melair/ktane/Docs/Card Scan/Melair_realistic_black_women_with_grey_streaks_in_hair_wearing__44ab107c-06e1-47cd-86c4-bb1236d598e2.png

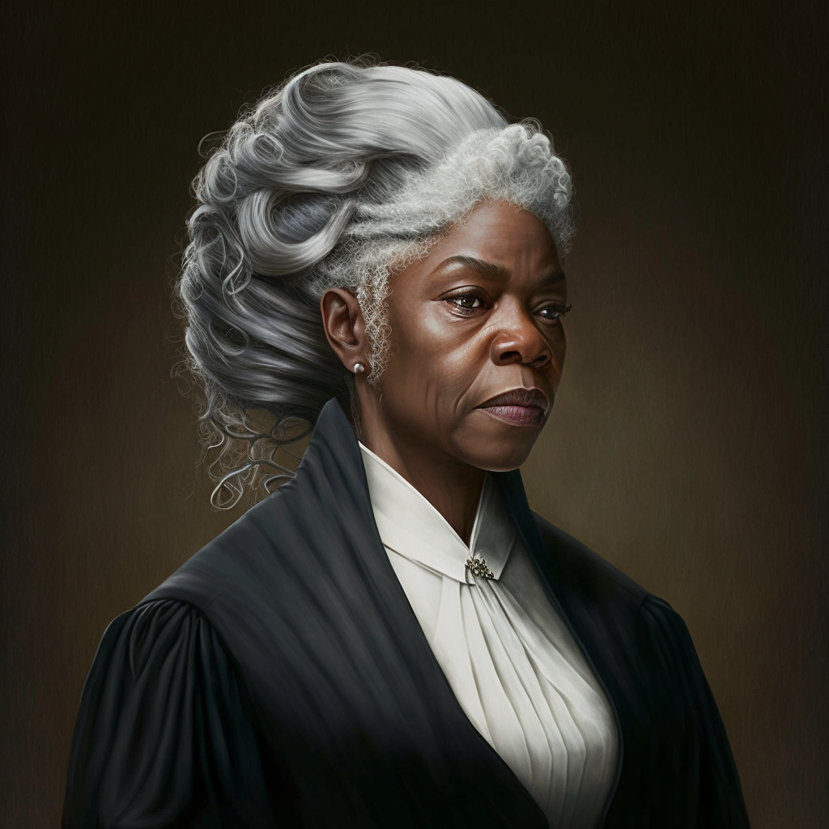
Docs/Card Scan/Melair_realistic_black_women_with_grey_streaks_in_hair_wearing__44ab107c-06e1-47cd-86c4-bb1236d598e2.png
