melair/ktane/Docs/Card Scan/Melair_realistic_grey_skinned_male_in_yellow_suit_jacket_with_n_b30e8cae-0856-494e-9278-38f3bf413497.png

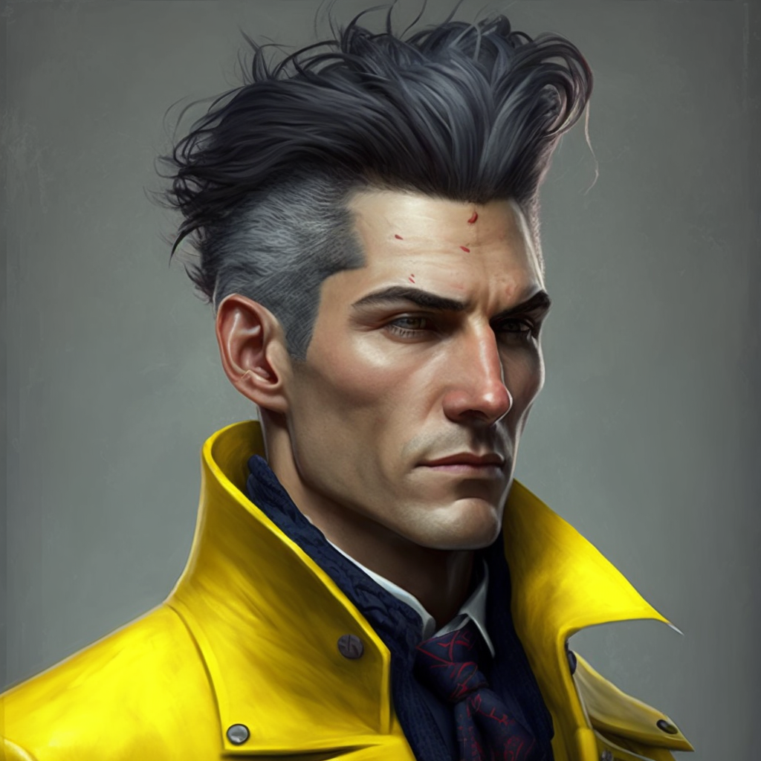
Docs/Card Scan/Melair_realistic_grey_skinned_male_in_yellow_suit_jacket_with_n_b30e8cae-0856-494e-9278-38f3bf413497.png
