melair/ktane/README.md

# Keep Talking and Nobody Explodes - Physical Version

## Version Two

This is version two of my Keep Talking and Nobody Explodes physical bomb, you may refer to the `version-one` branch if you wish to see the first version progress.
