melair/ktane/Docs/Card Scan/Cards.pdf

Acheron | Kontrollbeamter | Nyx | Obaida
Lloyd Davis | Judge Harris | Nine | 无名 (Wúmíng)

Richmond
Avenal

Josephus
Miller | Breeze | La Succubus
Shaykh Alwaqt | Lady of the
Night | Colonel Riker | Reaver

のぞみ
(Nozomi)
Mena | Duck | Packet

Jamie,
the Needle | The Librarian | Blackbird | El Padre del Diablo
