melair/ktane/Docs/Card Scan/Melair_realisitic_non_binary_person_with_short_hair_in_grey_mil_04014cfb-8ffc-4a0f-abf2-2d42c61999cd.png

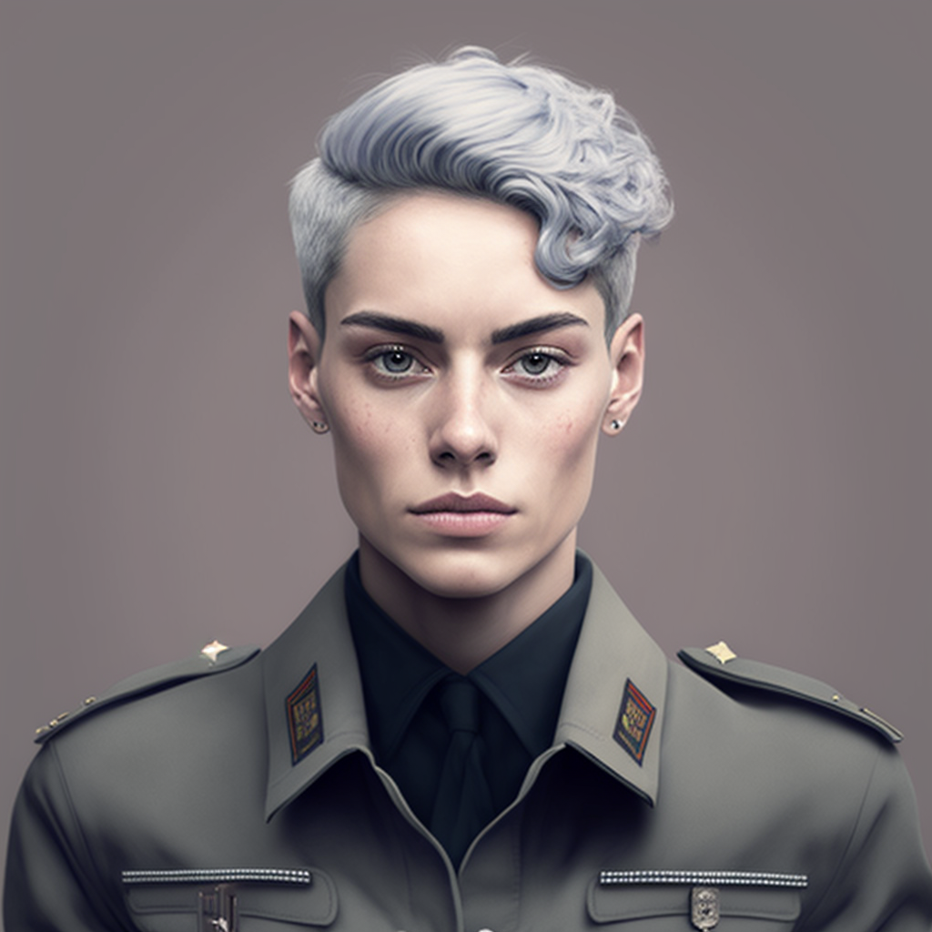
Docs/Card Scan/Melair_realisitic_non_binary_person_with_short_hair_in_grey_mil_04014cfb-8ffc-4a0f-abf2-2d42c61999cd.png
