melair/ktane/Docs/Card Scan/Melair_realistic_adult_German_female_with_purple_hair_in_a_blac_fe274c78-8b49-4a50-9dd5-ff4e6a9a2e28.png

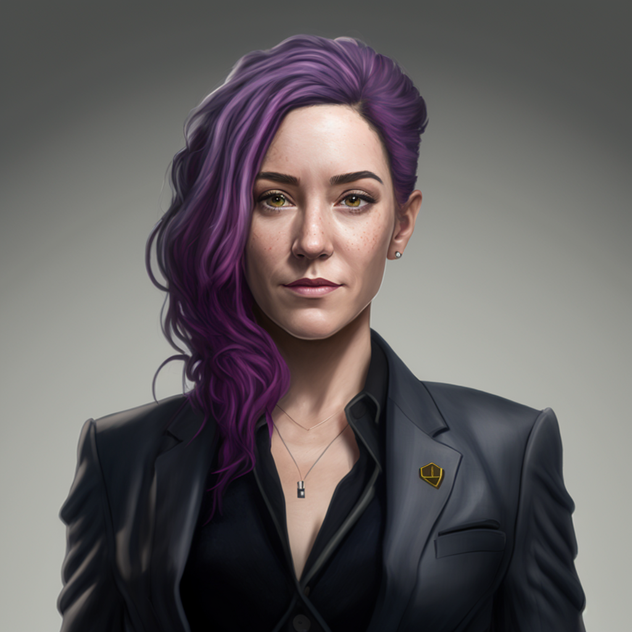
Docs/Card Scan/Melair_realistic_adult_German_female_with_purple_hair_in_a_blac_fe274c78-8b49-4a50-9dd5-ff4e6a9a2e28.png
