melair/ktane/Docs/Card Scan/Melair_realistic_Algerian_female_wearing_a_burka_d726cf47-6979-42aa-9952-323f560bce72.png

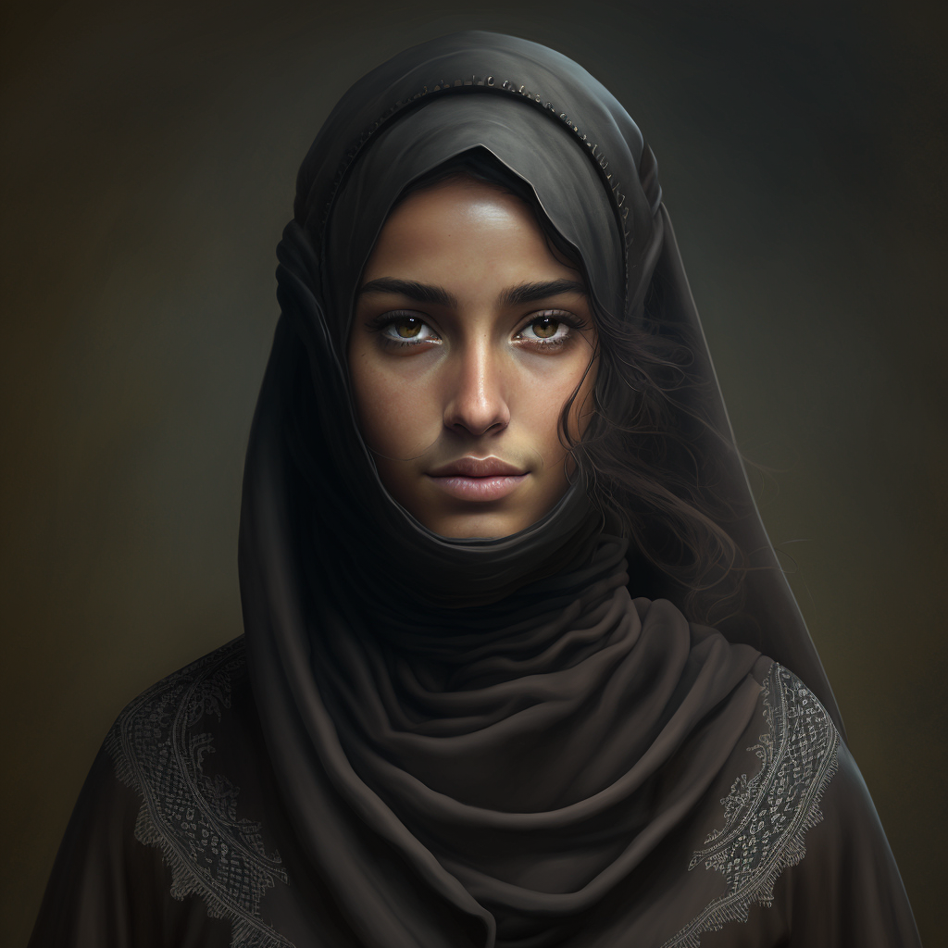
Docs/Card Scan/Melair_realistic_Algerian_female_wearing_a_burka_d726cf47-6979-42aa-9952-323f560bce72.png
