melair/ktane/Docs/Card Scan/Melair_realistic_black_male_with_white_hair_in_business_suite_368761fd-943f-4e19-92e4-5bb18a6a9406.png

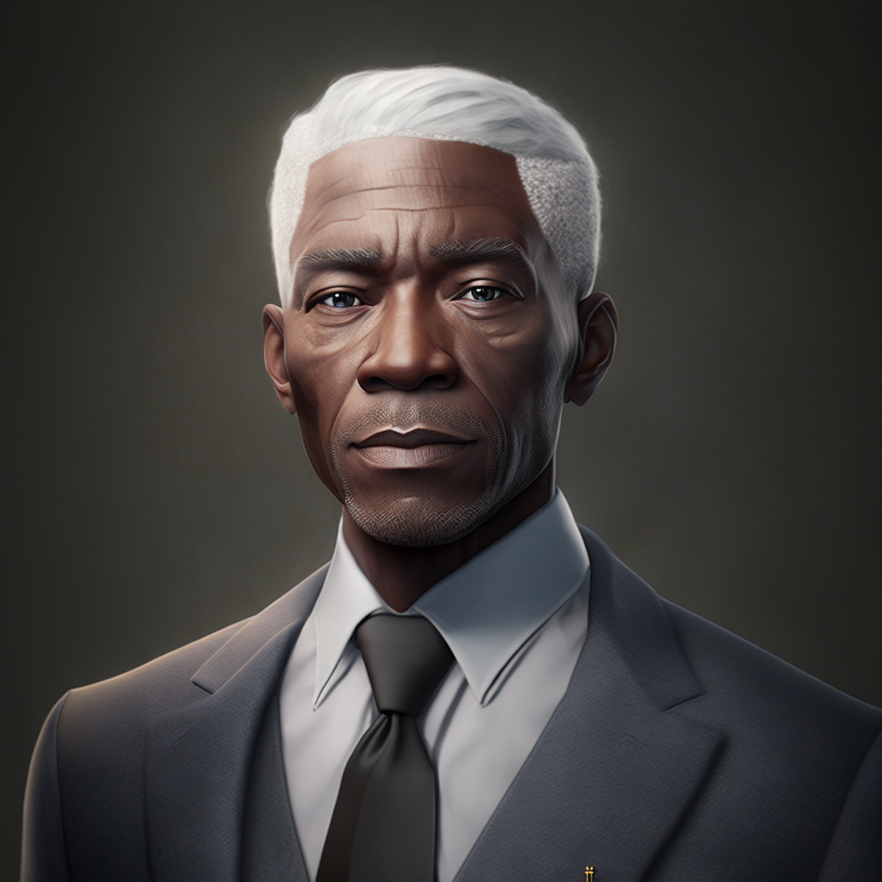
Docs/Card Scan/Melair_realistic_black_male_with_white_hair_in_business_suite_368761fd-943f-4e19-92e4-5bb18a6a9406.png
