melair/ktane/Docs/Card Scan/Melair_realistic_brown_teenager_wearing_a_pilots_uniform_has_gr_67f6606c-32e2-4271-a0de-92d22852f0d2.png

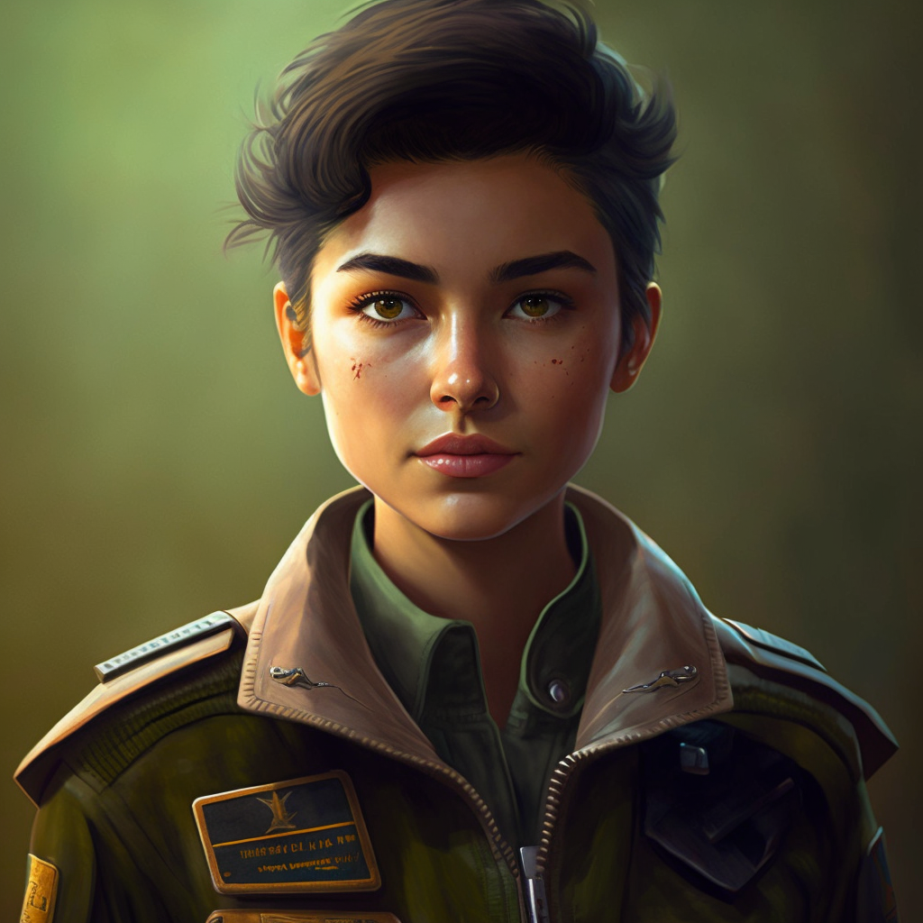
Docs/Card Scan/Melair_realistic_brown_teenager_wearing_a_pilots_uniform_has_gr_67f6606c-32e2-4271-a0de-92d22852f0d2.png
