melair/ktane/Docs/Card Scan/Melair_realistic_chinese_male_with_short_black_hair_in_formal_s_824c0033-530c-46d8-9239-9250d433e71a.png

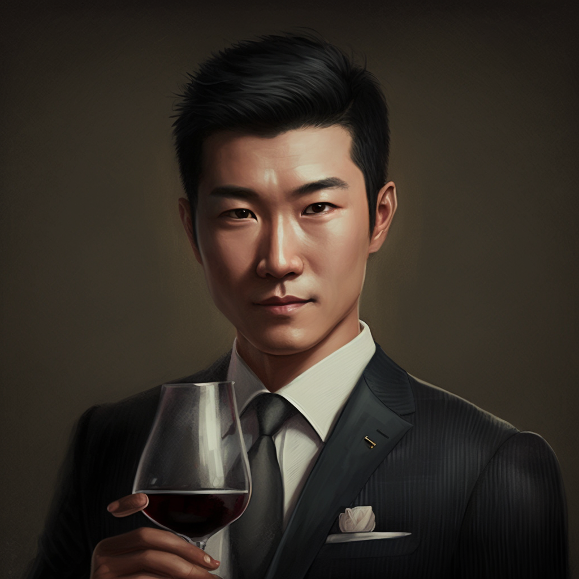
Docs/Card Scan/Melair_realistic_chinese_male_with_short_black_hair_in_formal_s_824c0033-530c-46d8-9239-9250d433e71a.png
