melair/ktane/Docs/Card Scan/Melair_realistic_goth_rock_male_with_long_black_hair_wearing_an_4043516b-c5be-47b4-9cfb-15923678df75.png

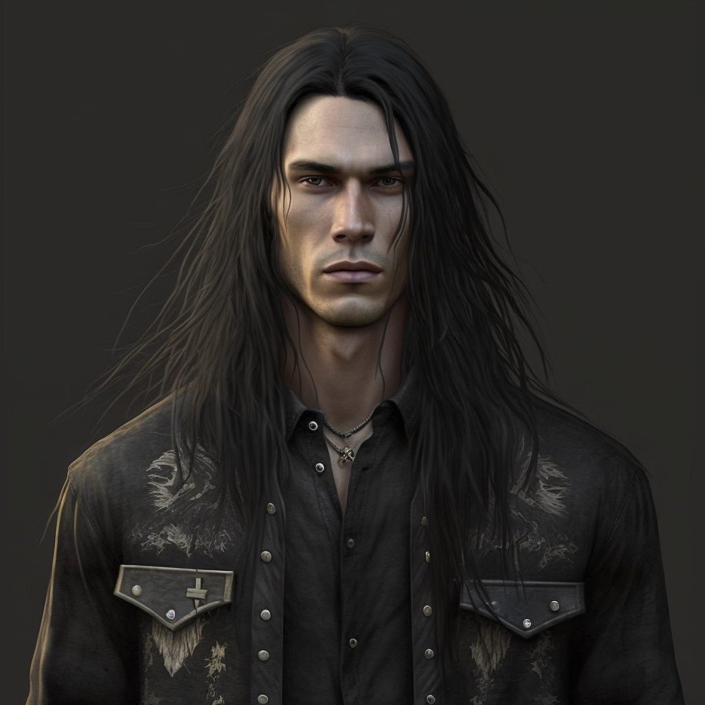
Docs/Card Scan/Melair_realistic_goth_rock_male_with_long_black_hair_wearing_an_4043516b-c5be-47b4-9cfb-15923678df75.png
