melair/ktane/Docs/Card Scan/Melair_realistic_indian_women_wearing_green_summer_dress_windsw_64dd87fc-c75d-431f-a860-1a8ef7d5c0e2.png

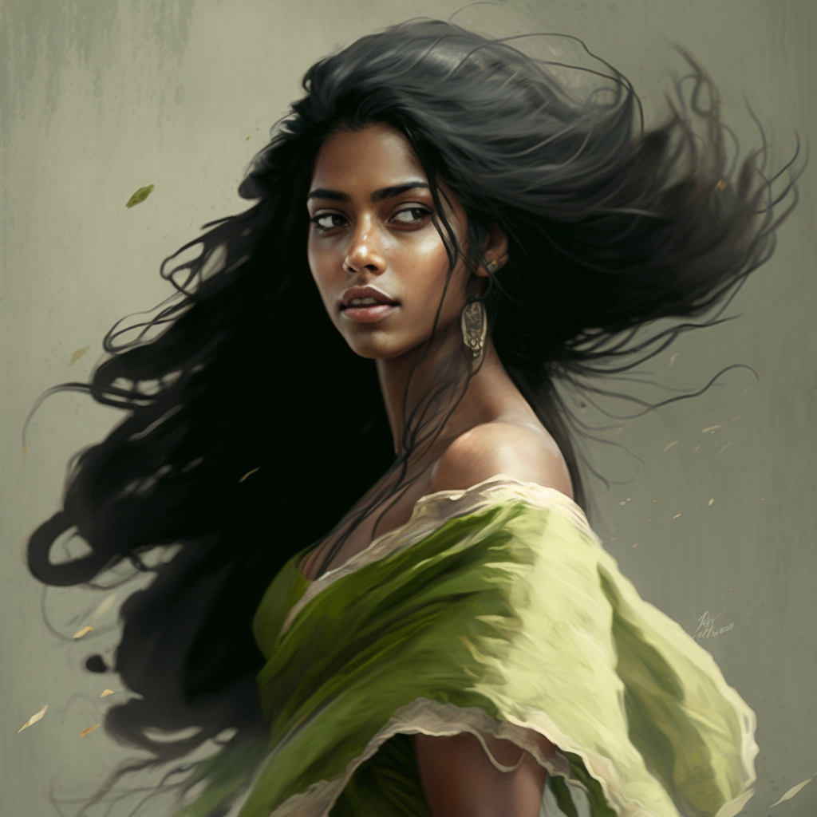
Docs/Card Scan/Melair_realistic_indian_women_wearing_green_summer_dress_windsw_64dd87fc-c75d-431f-a860-1a8ef7d5c0e2.png
