melair/ktane/Docs/Card Scan/Melair_realistic_latino_women_with_short_spikey_brown_hair_wear_2106f942-a5d6-429d-81e6-e0a5fbc91b26.png

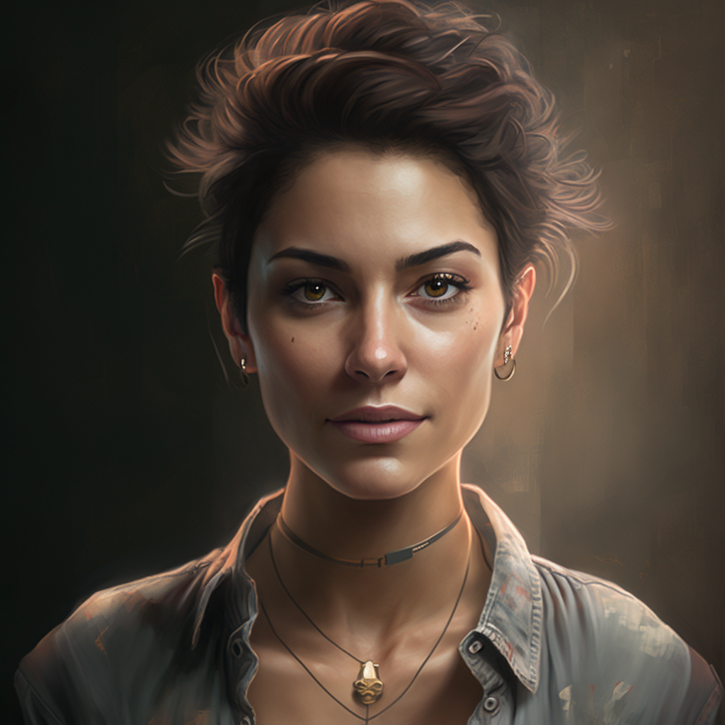
Docs/Card Scan/Melair_realistic_latino_women_with_short_spikey_brown_hair_wear_2106f942-a5d6-429d-81e6-e0a5fbc91b26.png
