melair/ktane/Docs/Card Scan/Melair_realistic_male_with_slick_black_hair_with_a_large_nose_p_a5ae49d4-29a0-4cd4-ba4a-adf8667f9832.png

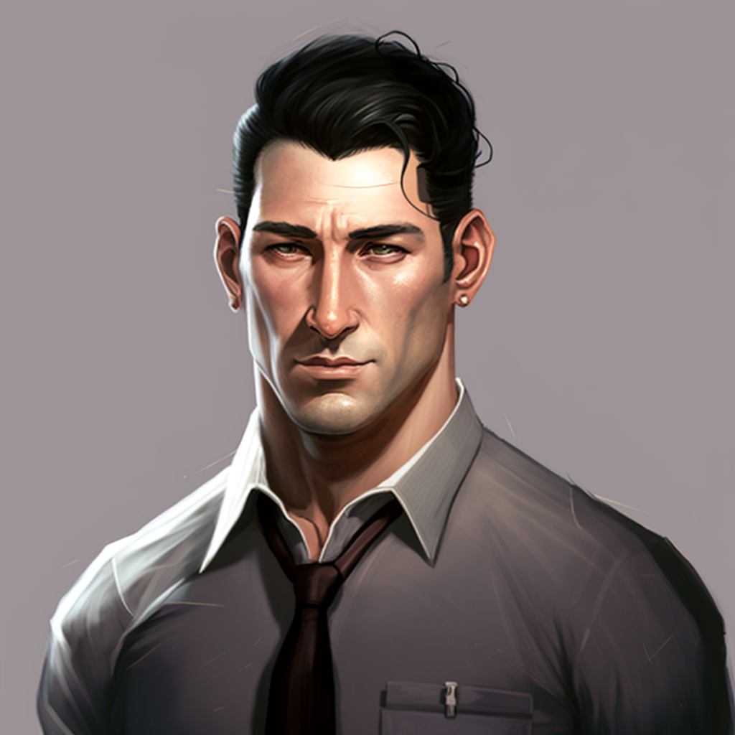
Docs/Card Scan/Melair_realistic_male_with_slick_black_hair_with_a_large_nose_p_a5ae49d4-29a0-4cd4-ba4a-adf8667f9832.png
