melair/ktane/Docs/Card Scan/Melair_realistic_middle_aged_arabian_man_with_dark_beard_wearin_ca8c735b-52ef-4bd1-9561-8f61d17f6978.png

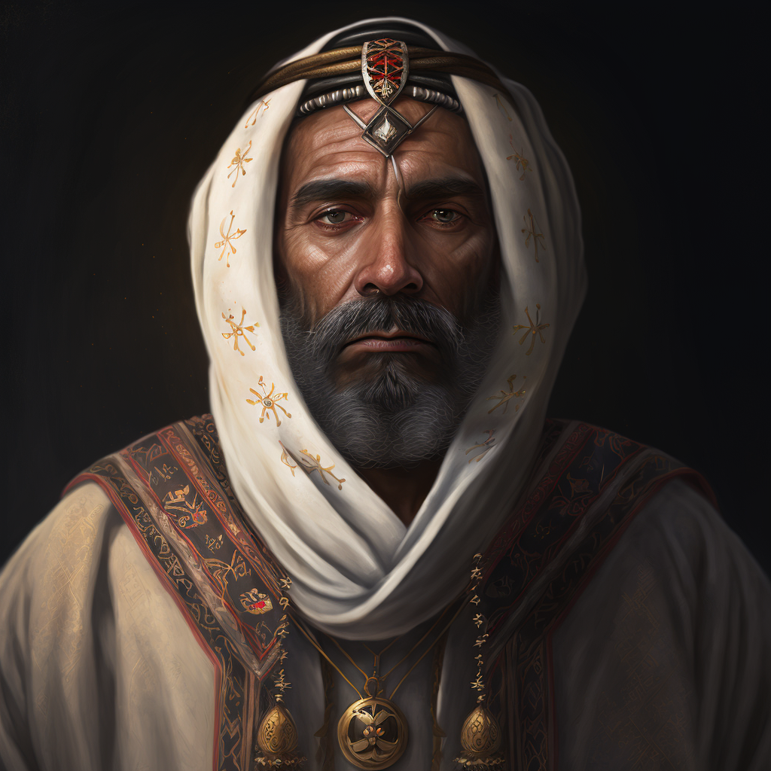
Docs/Card Scan/Melair_realistic_middle_aged_arabian_man_with_dark_beard_wearin_ca8c735b-52ef-4bd1-9561-8f61d17f6978.png
