melair/ktane/Docs/Card Scan/Melair_realistic_punk_rock_chick_with_dark_green_hair_b33debdb-83f1-4f58-8f6f-820d5b683afa.png

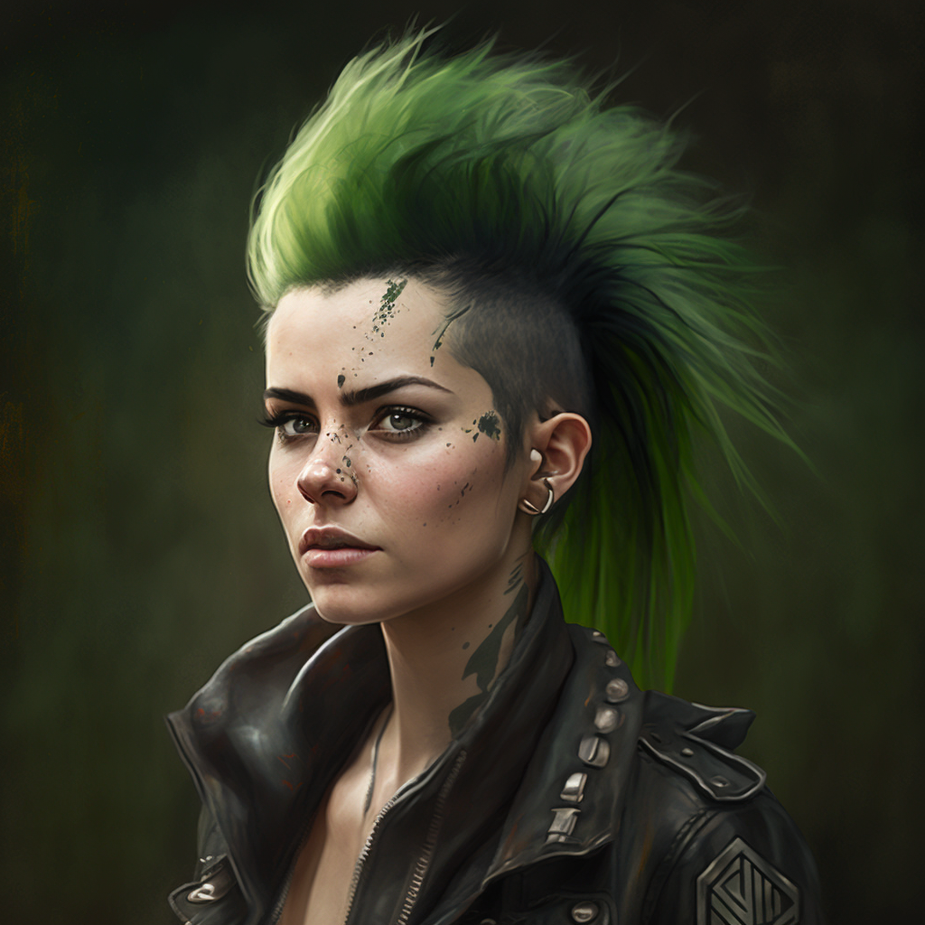
Docs/Card Scan/Melair_realistic_punk_rock_chick_with_dark_green_hair_b33debdb-83f1-4f58-8f6f-820d5b683afa.png
