melair/ktane/Docs/Card Scan/Melair_realistic_single_japanese_women_wearing_white_blouse_ff5d4336-b6ed-4613-82a2-87acb8b5093d.png

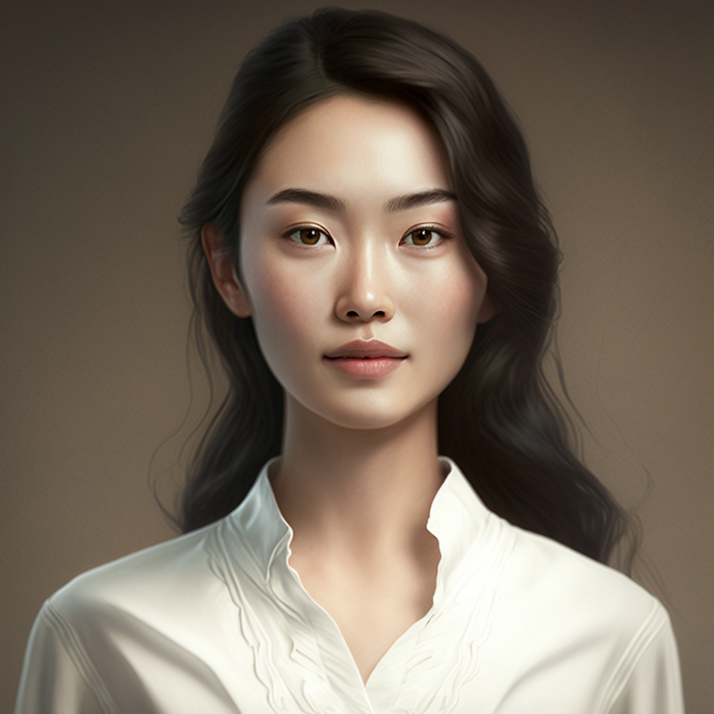
Docs/Card Scan/Melair_realistic_single_japanese_women_wearing_white_blouse_ff5d4336-b6ed-4613-82a2-87acb8b5093d.png
