melair/ktane/Docs/Card Scan/Melair_realistic_skater_girl_in_a_pink_tutu_with_braids_and_rol_8da13982-55fd-414e-803c-13e852adb5a8.png

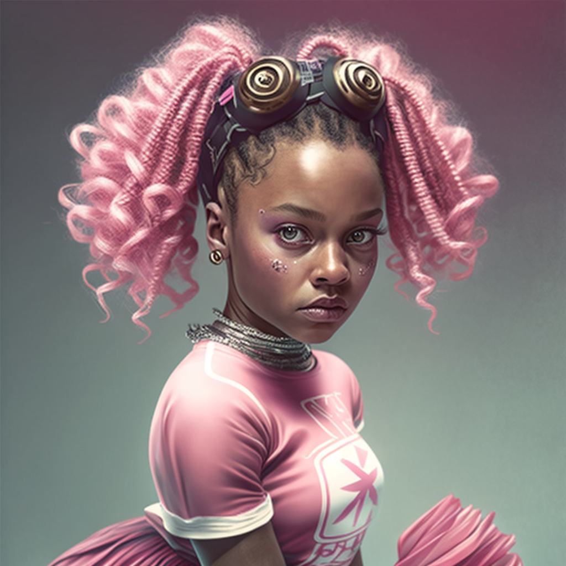
Docs/Card Scan/Melair_realistic_skater_girl_in_a_pink_tutu_with_braids_and_rol_8da13982-55fd-414e-803c-13e852adb5a8.png
