melair/ktane/Docs/Card Scan/Melair_realistic_skinny_white_male_with_shaved_head_with_a_larg_ee708fcf-f423-4748-8782-7e67da6e844e.png

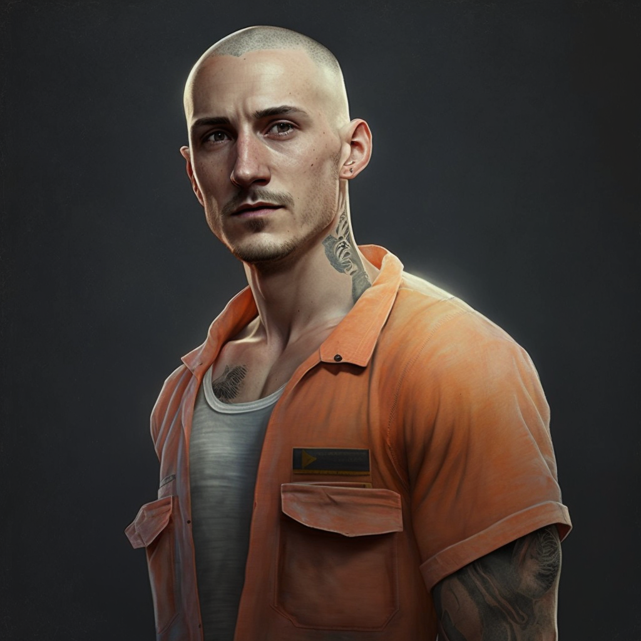
Docs/Card Scan/Melair_realistic_skinny_white_male_with_shaved_head_with_a_larg_ee708fcf-f423-4748-8782-7e67da6e844e.png
