melair/ktane/Docs/Card Scan/Melair_realistic_teenage_male_with_gaming_attire_0c467978-188e-4960-90f6-b093527184a6.png

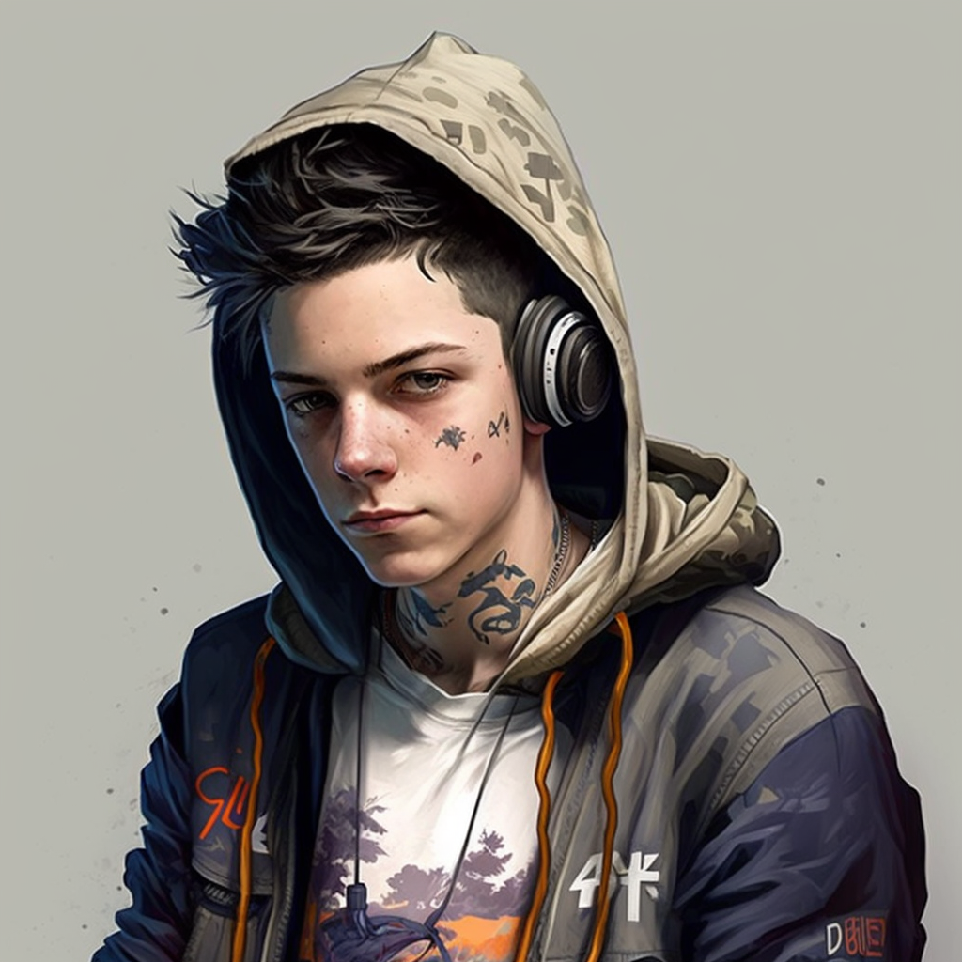
Docs/Card Scan/Melair_realistic_teenage_male_with_gaming_attire_0c467978-188e-4960-90f6-b093527184a6.png
