melair/ktane/Docs/Card Scan/Melair_realsitic_white_female_with_curly_blue_hair_with_an_eye__1b1dd122-b8fa-4b1e-844d-534144faa12f.png

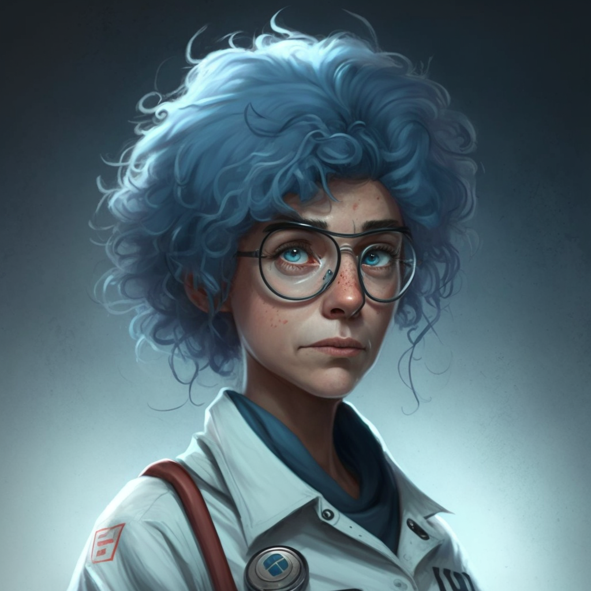
Docs/Card Scan/Melair_realsitic_white_female_with_curly_blue_hair_with_an_eye__1b1dd122-b8fa-4b1e-844d-534144faa12f.png
