melair/ktane/Docs/Card Scan/Melair_realsitic_young_black_female_wearing_a_tshirt_and_sweatp_16b6e8c9-ff5d-465f-b502-37f628f60e0f.png

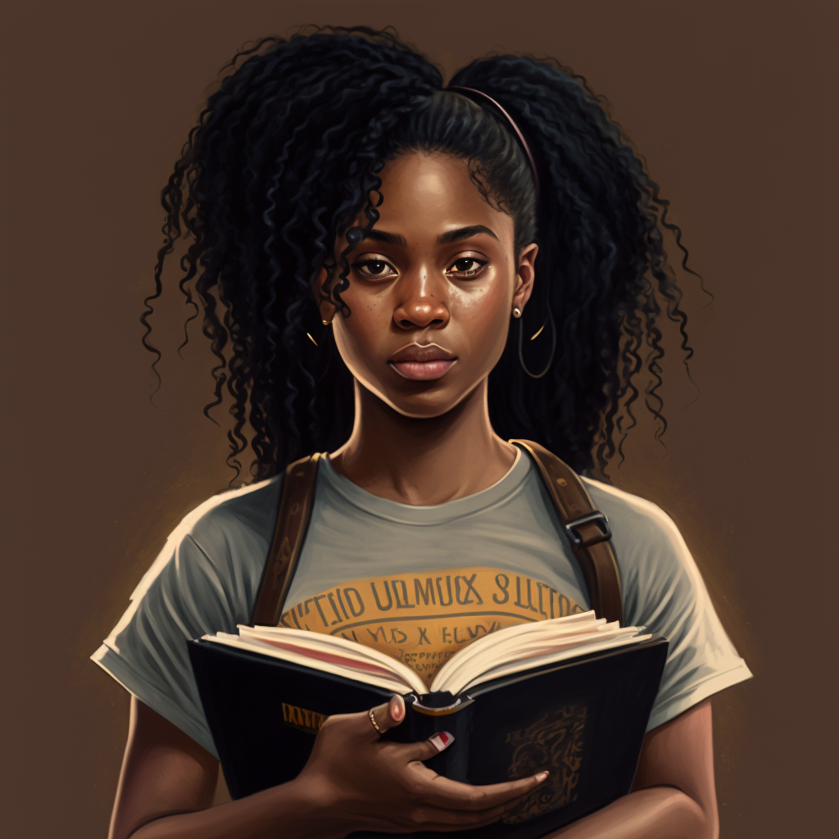
Docs/Card Scan/Melair_realsitic_young_black_female_wearing_a_tshirt_and_sweatp_16b6e8c9-ff5d-465f-b502-37f628f60e0f.png
