melair/ktane/Docs/Card Scan/Melair_white_female_with_pink_hair_in_a_pony_tail_with_large_ea_9b0f452e-8255-471d-aaca-e15b412c15e5.png

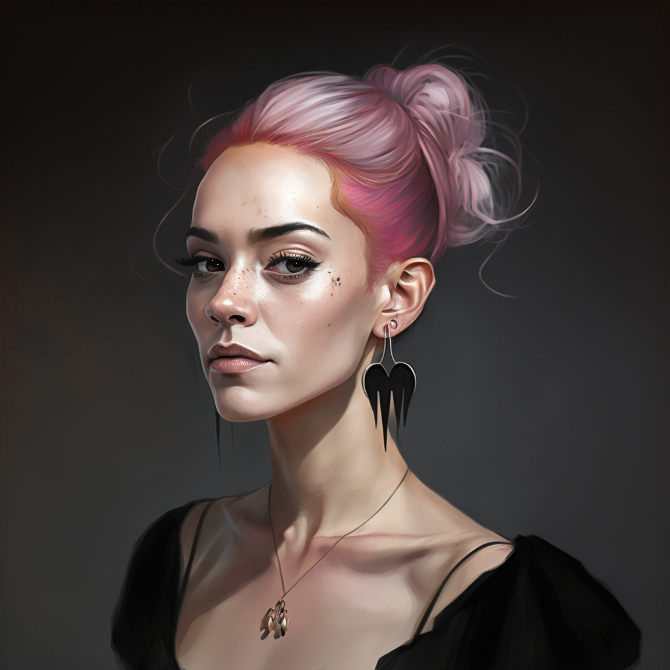
Docs/Card Scan/Melair_white_female_with_pink_hair_in_a_pony_tail_with_large_ea_9b0f452e-8255-471d-aaca-e15b412c15e5.png
