melair/ktane/Docs/Card Scan/Melair_young_spanish_man_with_tattoos_in_christian_priest_garb_0e999c80-e16d-4958-b63a-ef56c83381e8.png

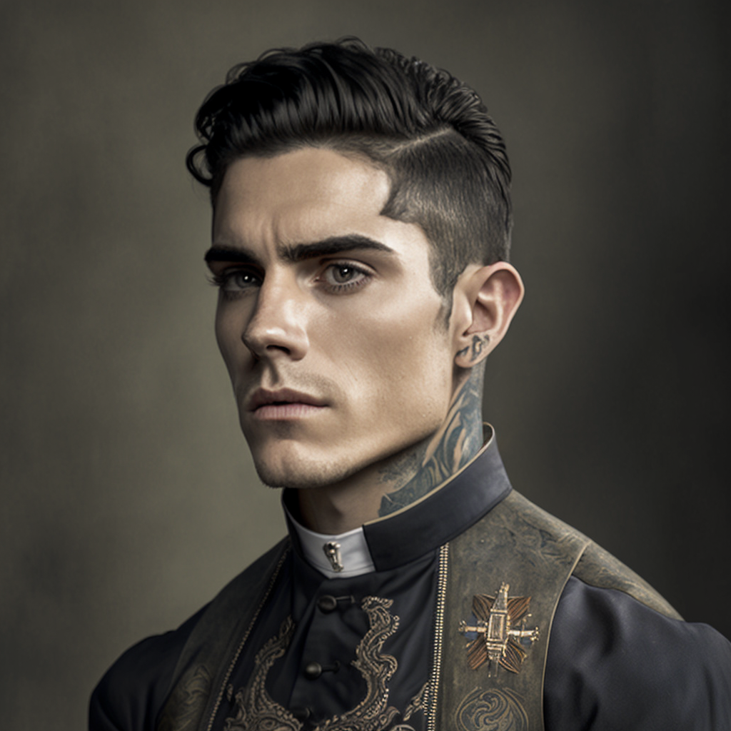
Docs/Card Scan/Melair_young_spanish_man_with_tattoos_in_christian_priest_garb_0e999c80-e16d-4958-b63a-ef56c83381e8.png
