melair/ktane/PCB/Others/ARGBSingle/Gerbers/ARGBSingle.csv

Reference | Qty | Value | DNP | Exclude from BOM | Exclude from Board | Footprint | Datasheet
C1 | 1 | 0.1uF |  |  |  | Capacitor_SMD:C_0603_1608Metric
D1 | 1 | WS2812B-2020 |  |  |  | LED_SMD:LED_WS2812B-2020_PLCC4_2.0x2.0mm | https://cdn-shop.adafruit.com/product-files/4684/4684_WS2812B-2020_V1.3_EN.pdf
