melair/ktane/(threads)

Thread 1 (2021-08-28):

It is possible to put the game into a weird state

InsiderPhD, 2021-08-28:
If the cables are not disconnected in between basked the game is put into a weird stagd

melair, 2022-08-26:
This is solved by 9810a73be7e14913d6606e7de681d0970c89e883, the issue isn't infact inbetween games as the actual MCU has to be restarted and its RAM is wiped on start. It's actually an oddity to do with changing resistances when a cable is touched/wiggled. This change makes it not care about cables "changing" colour during the game, only if they are removed outright.

Closed 2022-08-26.

Thread 2 (2023-02-12):

Change LCD code to act like a normal peripheral.

melair, 2023-02-12:
All modules currently init the LCD screen regardless of if they use it. This should be changed so that they only init it in the module's specific *_initialise() code. Remove lcd_default() from everywhere. This is the first step to the new main board respin with a custom module PCB for driving the LCD.

melair, 2023-02-12:
Done.

Closed 2023-02-12.

Thread 3 (2023-02-12):

Migrate peripherals to take memory during *_initialise()

melair, 2023-02-12:
At the moment peripherals like ARGB, LCD, keymatrix all have statically allocated RAM. The RAM should be moved into the modules mode_data_t union structure, that way RAM isn't being wasted when the LCD (4*20*3) or ARGB (40*3).

This isn't a problem at current, but maybe once sectors from the SD card are being buffered for DAC output.

Thread 6 (2023-03-07):

Controller ticks at 2kHz during GAME_RUNNING

melair, 2023-03-07:
As in title, it only updates the screen, it shouldn't need to run at that frequency.

melair, 2023-03-10:
This appears to be so that we can ensure the controller plays the timer tones correctly, as they happen at specific centisecond marks. We might be able to drop this down to 1kHz or 200Hz though.

Thread 10 (2023-03-11):

Migrate `peripherals/ports` and `peripherals/spi` to `hal`.

melair, 2023-03-11:
To avoid confusion migrate all abstractions into a specifically named HAL.

Add the following functionality:
- [x] Requesting resources such as UART and PWM by port.
- [ ] I2C HAL, similar to SPI.

Thread 9 (2023-03-11):

Change SPI HAL to handle unlimited devices/commands.

melair, 2023-03-11:
At current the SPI HAL is limited to X number of devices/commands, there isn't actually a need for devices to register with SPI first.

Instead migrate `spi_device_t` to be a ptr on `spi_command_t`. Further, add a `spi_command_t *next` ptr. This means that SPI would just need to keep a single ptr to the head of the queue.

This removes the need for modules/opts to track the device id, and any limits on registering and queuing.

Closed 2023-03-14.

Thread 13 (2023-03-27):

Rebuild approach to CAN firmware process.

melair, 2023-03-27:
The current implementation of "over-the-air" firmware updates is relativly naive. The KTANE firmware is limited to 63kb, this is under half of the 128kb that the PIC18F57Q84 has.

The memory layout is as follows:
* 0x000000 - 0x00FBFF (Firmware Main)
* 0x00FC00 - 0x01F7FF (Firmware Staging)
* 0x01F800 - 0x01FFFF (Flasher)

When the firmware detects that new firmware is available it wipes the staging area, and then proceeds to pull firmware from the remote module and place it in the firmware staging area.

If it then passes the CRC32 the program jumps to the flasher, the flasher disables all interrupts, DMAs, etc and copies the firmware from the staging environment to the main space, then issues `RESET()`.

This is how firmwaring works at current, it was simple to implement and has been reliable. However this means that 63kb of ROM space is unavailable to the module, and space is now becoming an issue.

A better way of handling this would be to move to a bootloader, firmware and CAN aware flasher combination. This would look like the following:

* 0x000000 - 0x0000FF (Bootloader)
* 0x000100 - 0x01EFFF (Firmware)
* 0x01F000 - 0x01FFFF (CAN Flasher)

The PIC18 would init to the bootloader, based upon a flag in the EEPROM of the PIC18 it would chose to jump to the firmware or the CAN flasher. Under normal operation the bootloader would immediately jump to the firmware.

The firmware would operate as normal, but not participate in actively retrieving firmware (though would have code to distribute firmware). If the firmware detected there was new firmware, then it would store its CAN id, the remote CAN id of the firmware, the new firmware version, new firmware CRC in the EEPROM, as well as activate the flag to jump to the CAN flasher, it would then issue `RESET()`.

The bootloader would then jump to the CAN flasher, which would init the CAN stack, and begin retrieving firmware pages via CAN, writing them directly over the existing firmware. Once the transfer was complete the CRC32 would be verified, assuming it was valid the EEPROM would be reset back to jump into normal firmware, wiping out the existing CAN details for the flasher.

If the CAN flasher failed to verify the CRC32, then it would increase an attempt count and RESET(), attempting the process again. This would be retried for a specific number of attempts.

This new approach would give us just under 124kb of ROM, almost double the current program space.

melair, 2023-03-29:
# New Firmware Flow

## Application

* Monitor `module_t modules[MODULE_COUNT]`, updated by `OPCODE_MODULE_ANNOUNCEMENT` messages.
  * Watch for a more recent firmware version (not 0xFFFF).
  * For bootloader, application and flasher.
* If bootloader or flasher:
  * Start process within application.
  * RESET() once complete.
* Update EEPROM:
  * Target firmware partition
  * Target firmware version
  * Current CAN ID
  * Bootloader Target

## Flasher

* Read EEPROM data.
* Start Process
* RESET()

## Process

* Send `OPCODE_FIRMWARE_REQUEST`, wait for `OPCODE_FIRMWARE_HEADER`.
* Send `OPCODE_FIRMWARE_PAGE_REQUEST` for each required page
  * Await `OPCODE_FIRMWARE_PAGE_RESPONSE`, write code into NVM.
* Once complete, verify CRC.
  * If matches, change Bootloader Target back to application.
  * If fails, increase firmware attempt count and restart process.

melair, 2023-04-13:
This has been completed and merged in!

Closed 2023-04-13.

Thread 14 (2023-04-12):

can_service() is not woken by interrupt

melair, 2023-04-12:
It appears that the can peripheral is not causing interrupts to wake the application out of `DOZE`.

This isn't a real issue for the main application as the clock is waking it every 0.5ms anyway, but for the flasher it stops it doing anything as there are no other triggers to wake from `DOZE`.

The `sleep()` line is commented out in the flasher.

Thread 17 (2024-08-25):

Module Ideas: Punch Cards

melair, 2024-08-25:
Some module that requires creation of punch cards by assembling different cards together. Layered to create the correct hole pattern. Use optical or micro switch array to detect.
