melair/ktane/PCB/Others/LCDI2CInterface/LCDI2CInterface.kicad_pcb

## KiCad design PCB/Others/LCDI2CInterface/LCDI2CInterface.kicad_pcb (2026-10-21)

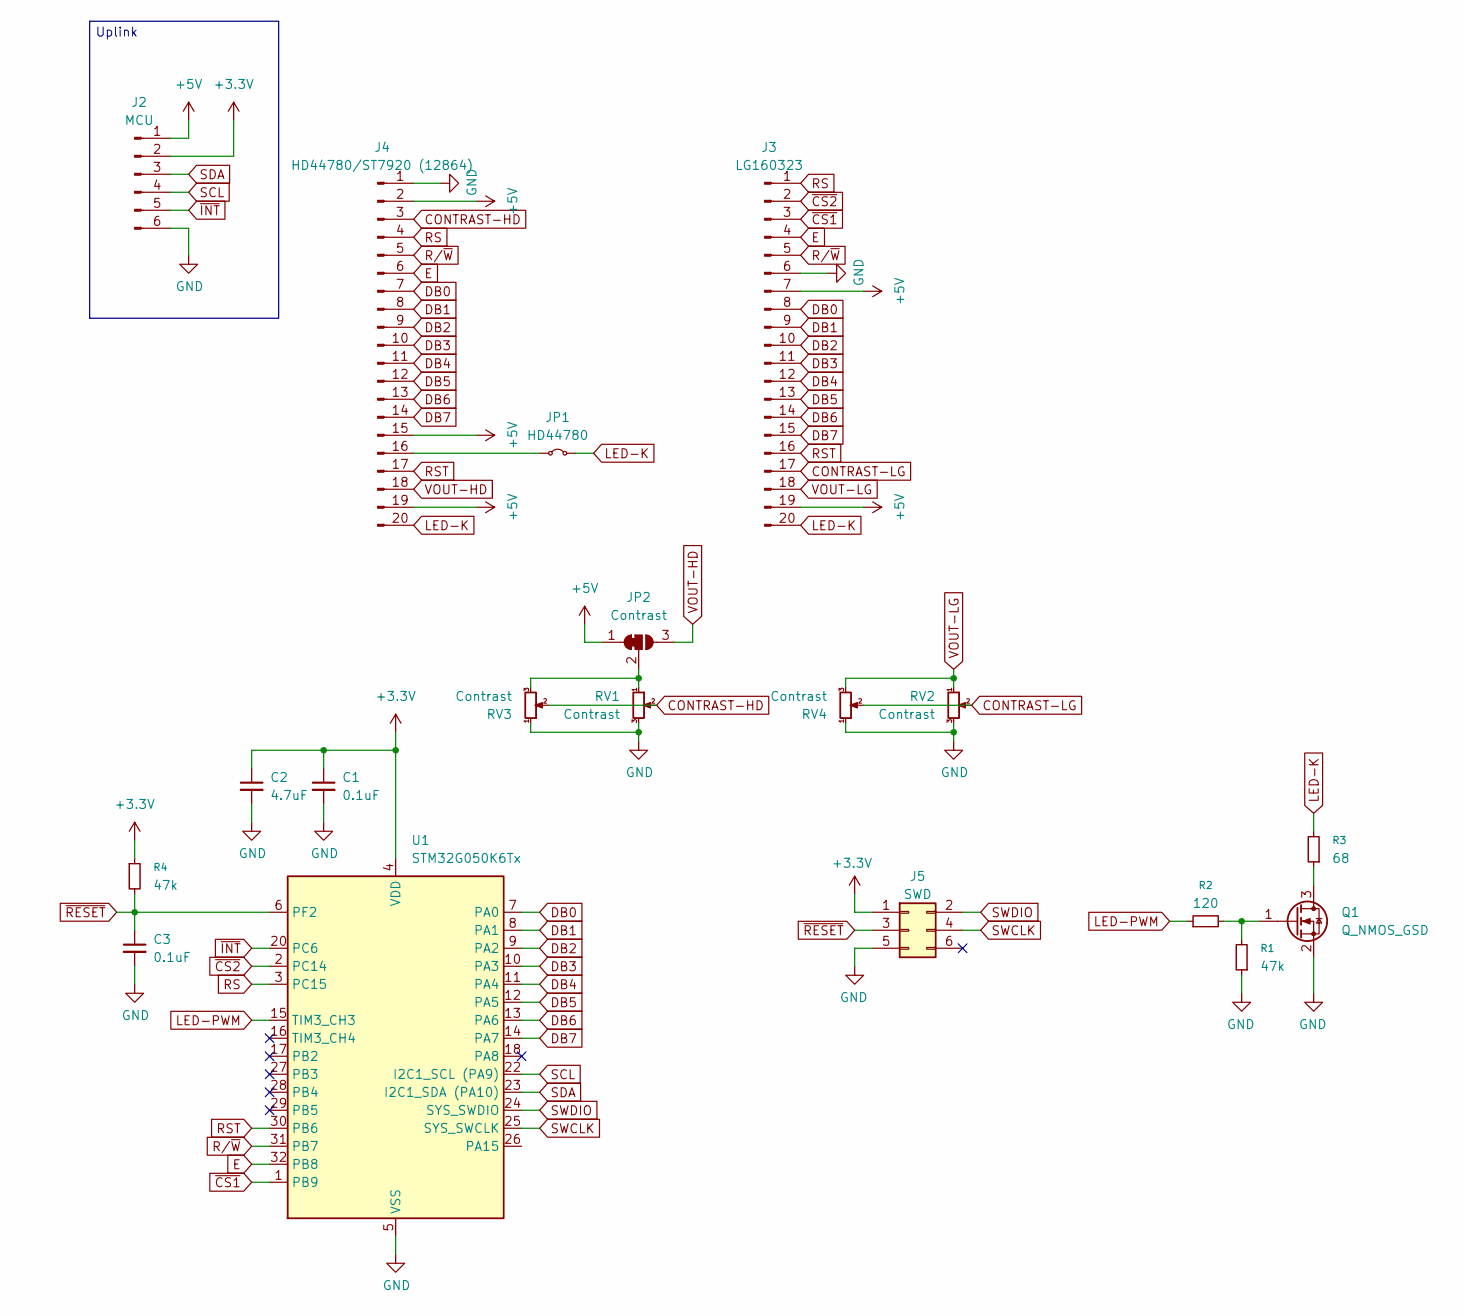
[picture p23: schematic LCDI2CInterface.kicad_sch, KTANE Physical Edition - LCDI2CInterface]

Parts:
C1, C3: 0.1uF; C_0603_1608Metric
C2: 4.7uF; C_0603_1608Metric
J2: MCU; PinHeader_1x06_P2.54mm_Horizontal
J3: LG160323; PinHeader_1x20_P2.54mm_Vertical
J4: HD44780/ST7920 (12864); PinHeader_1x20_P2.54mm_Vertical
J5: SWD; Tag-Connect_TC2030-IDC-NL_2x03_P1.27mm_Vertical; DIGIKEY NONE
JP1: HD44780; SolderJumper-2_P1.3mm_Bridged_RoundedPad1.0x1.5mm
JP2: Contrast; SolderJumper-3_P1.3mm_Bridged12_RoundedPad1.0x1.5mm
Q1: Q_NMOS_GSD; SOT-23
R1, R4: 47k; R_0603_1608Metric
R2: 120; R_0603_1608Metric
R3: 68; R_0603_1608Metric
RV1, RV2, RV3, RV4: Contrast; Potentiometer_Bourns_TC33X_Vertical; DIGIKEY TC33X-103ECT-ND
U1: STM32G050K6Tx; LQFP-32_7x7mm_P0.8mm

Connections:
+3.3V: C1.1, C2.1, J2.2, J5.1, R4.1, U1.4 (VDD)
+5V: J2.1, J3.7, J3.19, J4.2, J4.15, J4.19, JP2.1 (A)
CONTRAST-HD: J4.3, RV1.2, RV3.2
CONTRAST-LG: J3.17, RV2.2, RV4.2
DB0: J3.8, J4.7, U1.7 (PA0)
DB1: J3.9, J4.8, U1.8 (PA1)
DB2: J3.10, J4.9, U1.9 (PA2)
DB3: J3.11, J4.10, U1.10 (PA3)
DB4: J3.12, J4.11, U1.11 (PA4)
DB5: J3.13, J4.12, U1.12 (PA5)
DB6: J3.14, J4.13, U1.13 (PA6)
DB7: J3.15, J4.14, U1.14 (PA7)
E: J3.4, J4.6, U1.32 (PB8)
GND: C1.2, C2.2, C3.2, J2.6, J3.6, J4.1, J5.5, Q1.2 (S), R1.1, RV1.3, RV2.3, RV3.1, RV4.1, U1.5 (VSS)
LED-K: J3.20, J4.20, JP1.2 (B), R3.2
LED-PWM: R2.1, U1.15 (TIM3_CH3)
unnamed: J4.16, JP1.1 (A)
unnamed: JP2.2 (C), RV1.1, RV3.3
unnamed: Q1.3 (D), R3.1
unnamed: Q1.1 (G), R1.2, R2.2
RS: J3.1, J4.4, U1.3 (PC15)
RST: J3.16, J4.17, U1.30 (PB6)
R/~W: J3.5, J4.5, U1.31 (PB7)
SCL: J2.4, U1.22 (I2C1_SCL (PA9))
SDA: J2.3, U1.23 (I2C1_SDA (PA10))
SWCLK: J5.4, U1.25 (SYS_SWCLK)
SWDIO: J5.2, U1.24 (SYS_SWDIO)
VOUT-HD: J4.18, JP2.3 (B)
VOUT-LG: J3.18, RV2.1, RV4.3
~CS1: J3.3, U1.1 (PB9)
~CS2: J3.2, U1.2 (PC14)
~INT: J2.5, U1.20 (PC6)
~RESET: C3.1, J5.3, R4.2, U1.6 (PF2)

Notes on the sheet:
Uplink

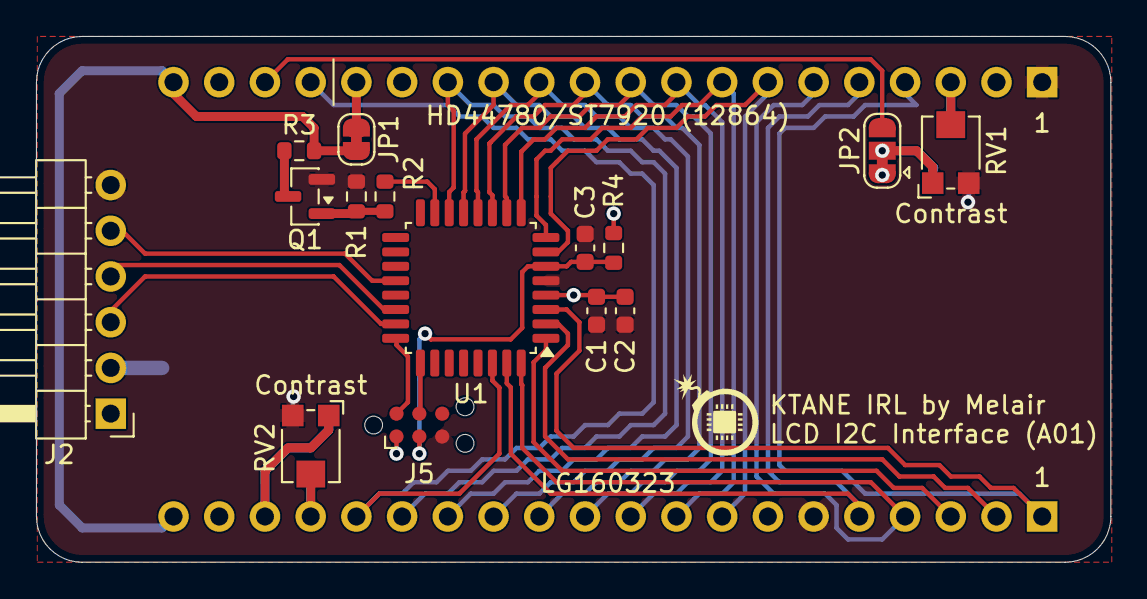
[picture p24: board LCDI2CInterface.kicad_pcb from above]

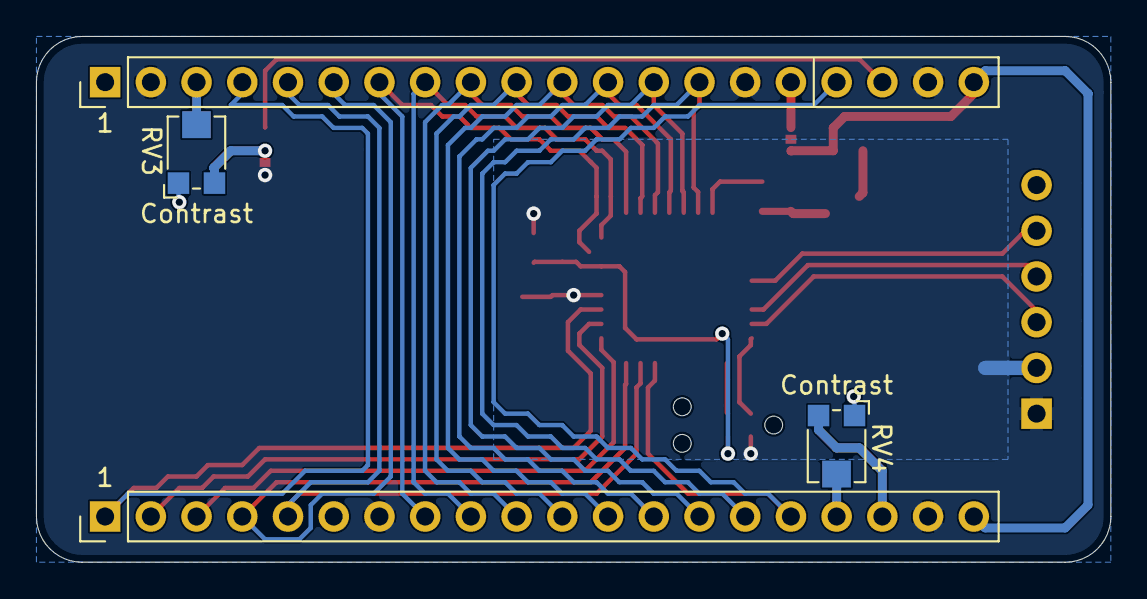
[picture p25: board LCDI2CInterface.kicad_pcb from below]

Board: 2 copper layers, 59.7 x 29.2 mm, 19 parts (4 on the bottom side), 33 nets.
