melair/ktane/PCB/Modules/Keymatrix/Keymatrix.kicad_pcb

## KiCad design PCB/Modules/Keymatrix/Keymatrix.kicad_pcb (2026-10-21)

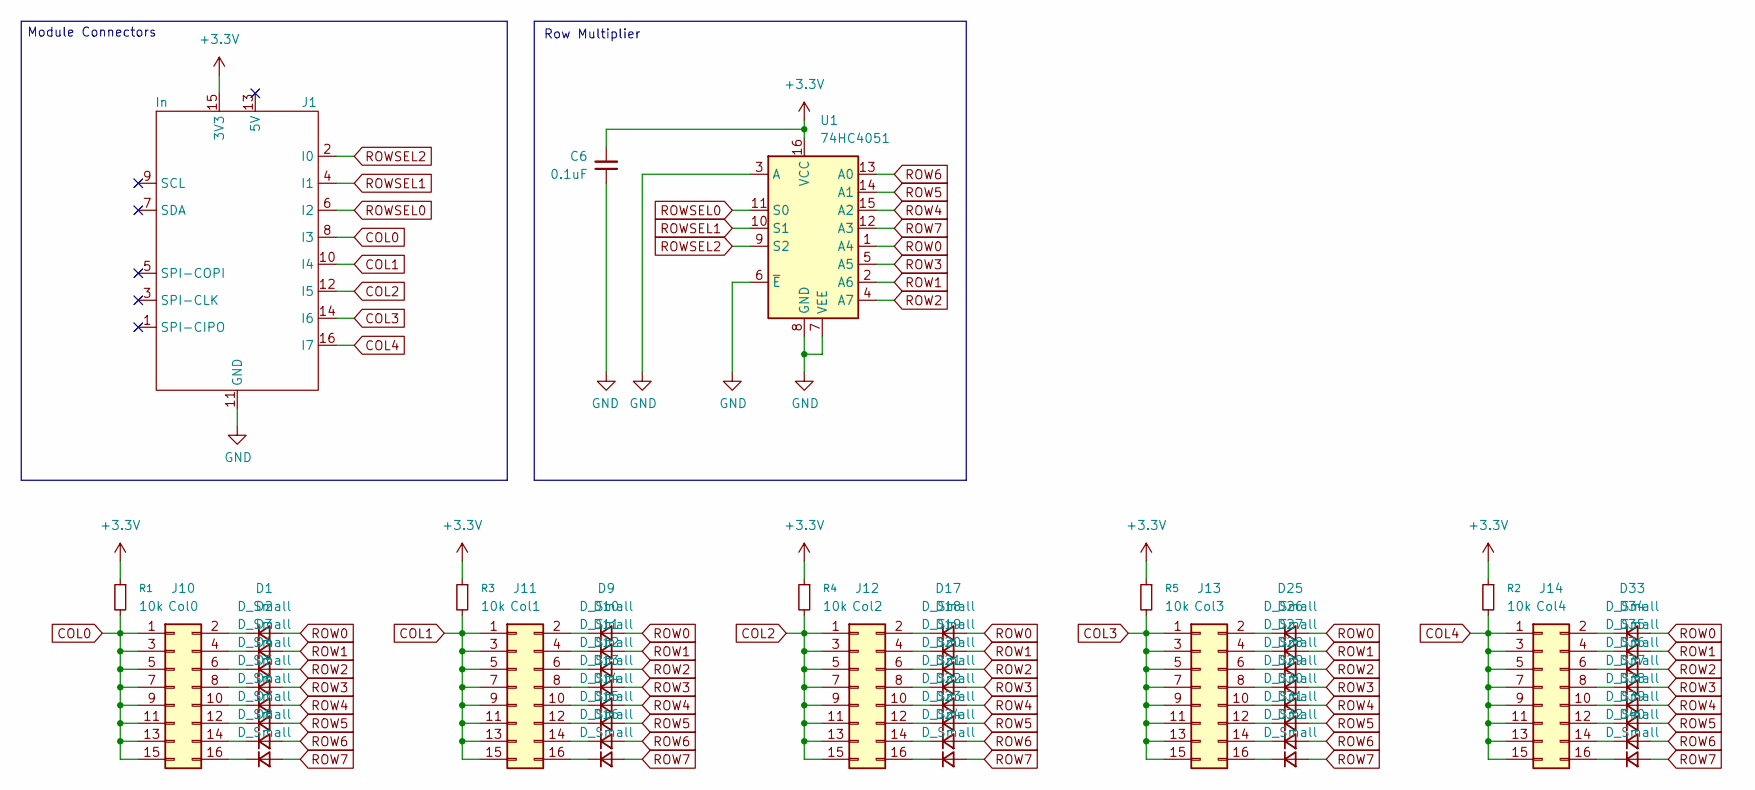
[picture p26: schematic Keymatrix.kicad_sch, KTANE Physical Edition - Keymatrix]

Parts:
C6: 0.1uF; C_0603_1608Metric
D1, D2, D3, D4, D5, D6, D7, D8, D9, D10, D11, D12, D13, D14, D15, D16, D17, D18, D19, D20, D21, D22, D23, D24, D25, D26, D27, D28, D29, D30, D31, D32, D33, D34, D35, D36, D37, D38, D39, D40: D_Small; D_0603_1608Metric
J1: In; KTANE Submodule Connector V2 - Short; DIGIKEY STOCK
J10: Col0; PinHeader_2x08_P2.54mm_Vertical
J11: Col1; PinHeader_2x08_P2.54mm_Vertical
J12: Col2; PinHeader_2x08_P2.54mm_Vertical
J13: Col3; PinHeader_2x08_P2.54mm_Vertical
J14: Col4; PinHeader_2x08_P2.54mm_Vertical
R1, R2, R3, R4, R5: 10k; R_0603_1608Metric
U1: 74HC4051; DHVQFN-16-1EP_2.5x3.5mm_P0.5mm_EP1x2mm

Connections:
+3.3V: C6.2, J1.15 (3V3), R1.1, R2.1, R3.1, R4.1, R5.1, U1.16 (VCC)
COL0: J1.8 (I3), J10.1, J10.3, J10.5, J10.7, J10.9, J10.11, J10.13, J10.15, R1.2
COL1: J1.10 (I4), J11.1, J11.3, J11.5, J11.7, J11.9, J11.11, J11.13, J11.15, R3.2
COL2: J1.12 (I5), J12.1, J12.3, J12.5, J12.7, J12.9, J12.11, J12.13, J12.15, R4.2
COL3: J1.14 (I6), J13.1, J13.3, J13.5, J13.7, J13.9, J13.11, J13.13, J13.15, R5.2
COL4: J1.16 (I7), J14.1, J14.3, J14.5, J14.7, J14.9, J14.11, J14.13, J14.15, R2.2
GND: C6.1, J1.11 (GND), U1.3 (A), U1.6 (~E), U1.7 (VEE), U1.8 (GND)
unnamed: D1.1 (K), J10.2
unnamed: D2.1 (K), J10.4
unnamed: D3.1 (K), J10.6
unnamed: D4.1 (K), J10.8
unnamed: D5.1 (K), J10.10
unnamed: D6.1 (K), J10.12
unnamed: D7.1 (K), J10.14
unnamed: D8.1 (K), J10.16
unnamed: D9.1 (K), J11.2
unnamed: D10.1 (K), J11.4
unnamed: D11.1 (K), J11.6
unnamed: D12.1 (K), J11.8
unnamed: D13.1 (K), J11.10
unnamed: D14.1 (K), J11.12
unnamed: D15.1 (K), J11.14
unnamed: D16.1 (K), J11.16
unnamed: D17.1 (K), J12.2
unnamed: D18.1 (K), J12.4
unnamed: D19.1 (K), J12.6
unnamed: D20.1 (K), J12.8
unnamed: D21.1 (K), J12.10
unnamed: D22.1 (K), J12.12
unnamed: D23.1 (K), J12.14
unnamed: D24.1 (K), J12.16
unnamed: D25.1 (K), J13.2
unnamed: D26.1 (K), J13.4
unnamed: D27.1 (K), J13.6
unnamed: D28.1 (K), J13.8
unnamed: D29.1 (K), J13.10
unnamed: D30.1 (K), J13.12
unnamed: D31.1 (K), J13.14
unnamed: D32.1 (K), J13.16
unnamed: D33.1 (K), J14.2
unnamed: D34.1 (K), J14.4
unnamed: D35.1 (K), J14.6
unnamed: D36.1 (K), J14.8
unnamed: D37.1 (K), J14.10
unnamed: D38.1 (K), J14.12
unnamed: D39.1 (K), J14.14
unnamed: D40.1 (K), J14.16
ROW0: D1.2 (A), D9.2 (A), D17.2 (A), D25.2 (A), D33.2 (A), U1.1 (A4)
ROW1: D2.2 (A), D10.2 (A), D18.2 (A), D26.2 (A), D34.2 (A), U1.2 (A6)
ROW2: D3.2 (A), D11.2 (A), D19.2 (A), D27.2 (A), D35.2 (A), U1.4 (A7)
ROW3: D4.2 (A), D12.2 (A), D20.2 (A), D28.2 (A), D36.2 (A), U1.5 (A5)
ROW4: D5.2 (A), D13.2 (A), D21.2 (A), D29.2 (A), D37.2 (A), U1.15 (A2)
ROW5: D6.2 (A), D14.2 (A), D22.2 (A), D30.2 (A), D38.2 (A), U1.14 (A1)
ROW6: D7.2 (A), D15.2 (A), D23.2 (A), D31.2 (A), D39.2 (A), U1.13 (A0)
ROW7: D8.2 (A), D16.2 (A), D24.2 (A), D32.2 (A), D40.2 (A), U1.12 (A3)
ROWSEL0: J1.6 (I2), U1.11 (S0)
ROWSEL1: J1.4 (I1), U1.10 (S1)
ROWSEL2: J1.2 (I0), U1.9 (S2)

Notes on the sheet:
Module Connectors
Row Multiplier

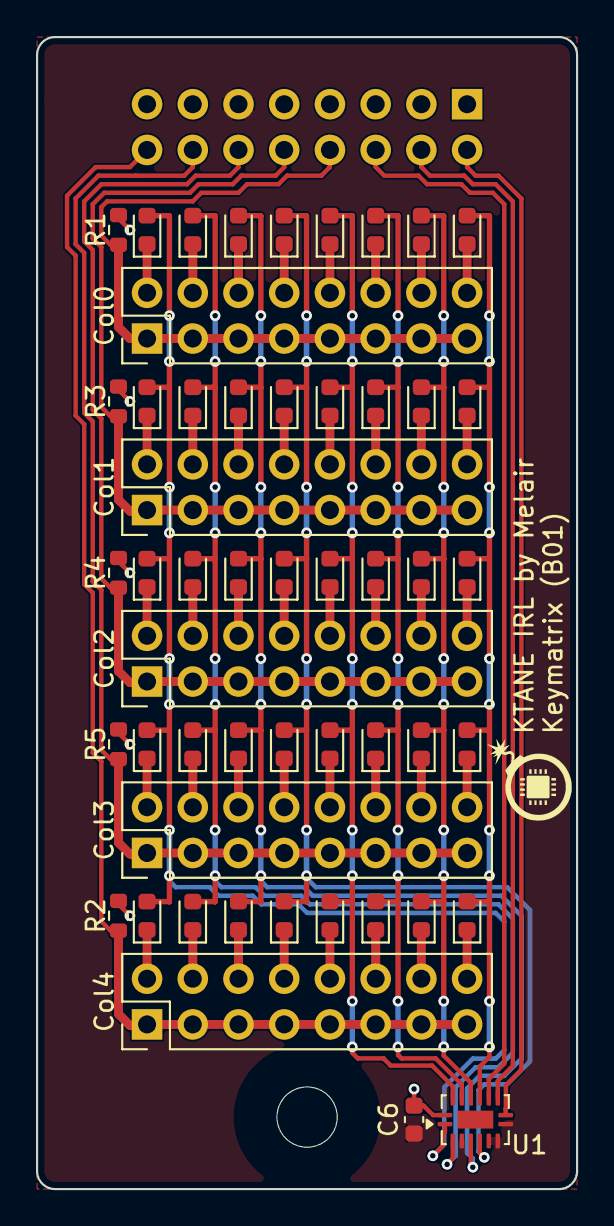
[picture p27: board Keymatrix.kicad_pcb from above]

Board: 2 copper layers, 30.0 x 64.0 mm, 53 parts (0 on the bottom side), 58 nets.
