melair/ktane/PCB/Modules/LocalAudio/LocalAudio.kicad_pcb

## KiCad design PCB/Modules/LocalAudio/LocalAudio.kicad_pcb (2026-10-17)

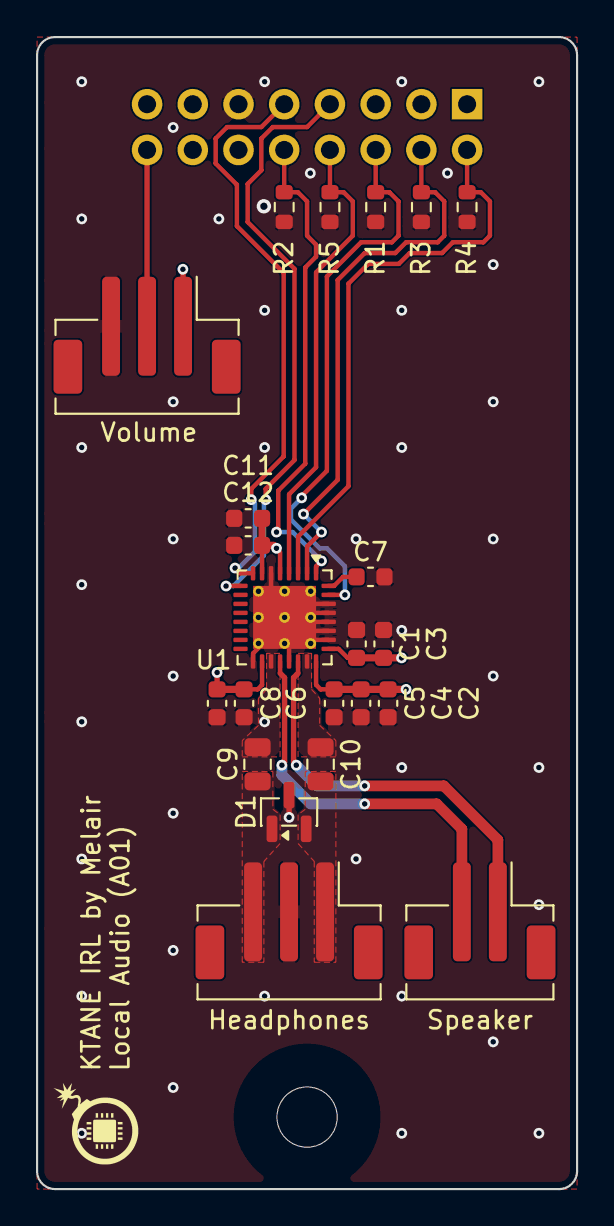
[picture p28: board LocalAudio.kicad_pcb from above]

Board: 4 copper layers, 30.0 x 64.0 mm, 23 parts (0 on the bottom side), 17 nets.

Parts:
C1, C5, C6, C7, C12: 0.1uF; C_0603_1608Metric
C2: 10uF; C_0603_1608Metric
C3, C4, C8, C11: 1uF; C_0603_1608Metric
C9, C10: 47uF; C_0805_2012Metric
D1: PESD3V3S2BT; SOT-23
J1: In; KTANE Submodule Connector V2 - Short
J2: Speaker; JST_PH_B2B-PH-SM4-TB_1x02-1MP_P2.00mm_Vertical
J3: Headphones; JST_PH_B3B-PH-SM4-TB_1x03-1MP_P2.00mm_Vertical
J4: Volume; JST_PH_B3B-PH-SM4-TB_1x03-1MP_P2.00mm_Vertical
R1, R2, R3, R4, R5: 4.7k; R_0603_1608Metric
U1: TLV320DAC32; VQFN-32-1EP_5x5mm_P0.5mm_EP3.5x3.5mm_ThermalVias

Connections:
+3.3V: C1.2, C2.2, C3.2, C4.2, C5.2, C6.2, C8.2, C11.2, C12.2, J1.15 (3V3), J4.1, U1.5 (LDO_SELECT), U1.7 (IOVDD), U1.18 (DRVDD), U1.24 (DRVDD), U1.25 (AVDD_DAC)
GND: C1.1, C2.1, C3.1, C4.1, C5.1, C6.1, C7.1, C8.1, C11.1, C12.1, D1.3 (CC), J1.11 (GND), J3.2, J4.3, R1.1, R2.1, R3.1, R4.1, R5.1, U1.6 (IOVSS), U1.17 (DRVSS), U1.21 (DRVSS), U1.26 (VSS_DAC), U1.27 (VSS_DAC), U1.28 (VSS_DAC), U1.29 (VSS_DAC), U1.30 (VSS_DAC), U1.33 (VSS_DAC)
I2C-CLK: J1.9 (SCL), U1.8 (SCL)
I2C-DAT: J1.7 (SDA), U1.9 (SDA)
I2S-BCLK: J1.4 (I2S_CK), R3.2, U1.2 (BCLK)
I2S-DAT: J1.8 (I2S_SDO), R5.2, U1.4 (DIN)
I2S-MCLK: J1.10 (I2S_MCLK), R2.2, U1.1 (MCLK)
I2S-WCLK: J1.2 (I2S_WS), R4.2, U1.3 (WCLK)
unnamed: C9.2, D1.1 (K1), J3.3
unnamed: C10.2, D1.2 (K2), J3.1
unnamed: C7.2, U1.32 (DVDD)
unnamed: C9.1, U1.19 (HPLOUT)
unnamed: C10.1, U1.23 (HPROUT)
SPK+: J2.1, U1.22 (HPRCOM)
SPK-: J2.2, U1.20 (HPLCOM)
VOL: J1.16 (I7), J4.2
~RESET: J1.6 (I2S_SDI), R1.2, U1.31 (~RESET)
