melair/ktane/PCB/Others/NeedyCountdown/NeedyCountdown.kicad_pcb

## KiCad design PCB/Others/NeedyCountdown/NeedyCountdown.kicad_pcb (2026-10-16)

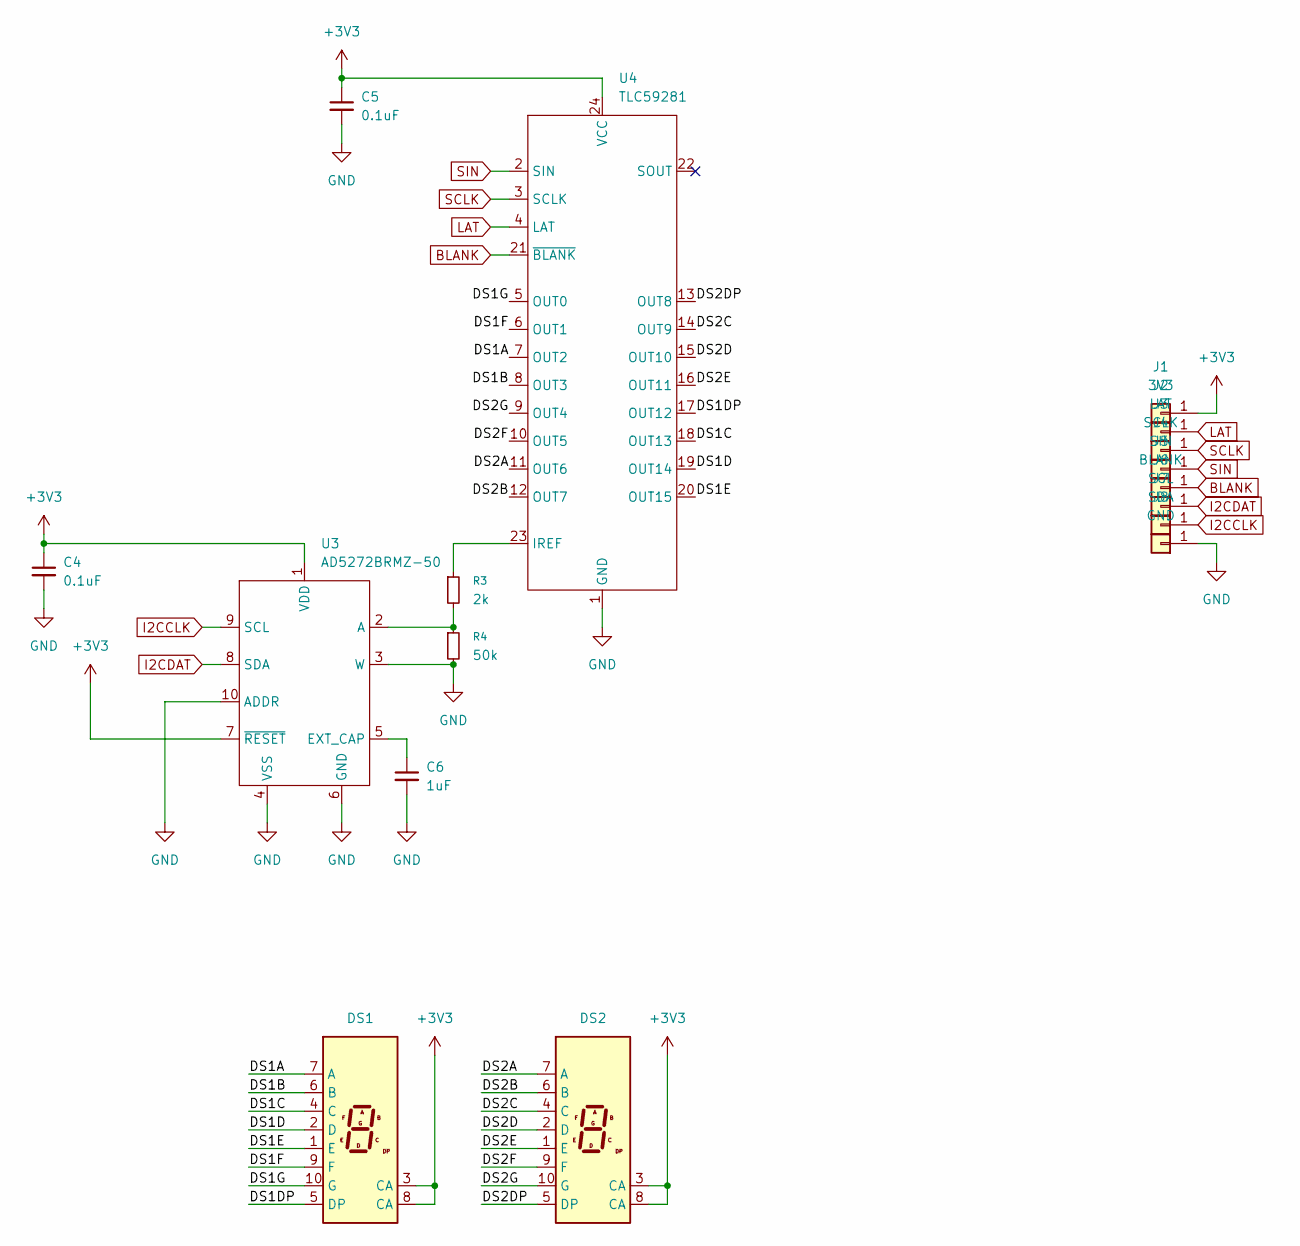
[picture p29: schematic NeedyCountdown.kicad_sch]

Parts:
C4, C5: 0.1uF; C_0603_1608Metric; DIGIKEY 1276-1005-1-ND
C6: 1uF; C_0603_1608Metric; DIGIKEY 1276-1946-1-ND
DS1, DS2: 5161 LED
J1: 3V3; Pad4x2; DIGIKEY NONE
J2: LAT; Pad4x2; DIGIKEY NONE
J3: SCLK; Pad4x2; DIGIKEY NONE
J4: SIN; Pad4x2; DIGIKEY NONE
J5: BLANK; Pad4x2; DIGIKEY NONE
J6: SCL; Pad4x2; DIGIKEY NONE
J7: SDA; Pad4x2; DIGIKEY NONE
J8: GND; Pad4x2; DIGIKEY NONE
R3: 2k; R_0603_1608Metric; DIGIKEY P2.00KHCT-ND
R4: 50k; R_0603_1608Metric; DIGIKEY P51.0KHCT-ND
U3: AD5272BRMZ-50; MSOP-10_3x3mm_P0.5mm; DIGIKEY 505-AD5272BRMZ-50-ND
U4: TLC59281; SSOP-24_3.9x8.7mm_P0.635mm; DIGIKEY 296-25789-1-ND

Connections:
+3V3: C4.1, C5.1, DS1.3 (CA), DS1.8 (CA), DS2.3 (CA), DS2.8 (CA), J1.1 (Pin_1_1), U3.1 (VDD), U3.7 (~RESET), U4.24 (VCC)
/DS1A: DS1.7 (A), U4.7 (OUT2)
/DS1B: DS1.6 (B), U4.8 (OUT3)
/DS1C: DS1.4 (C), U4.18 (OUT13)
/DS1D: DS1.2 (D), U4.19 (OUT14)
/DS1DP: DS1.5 (DP), U4.17 (OUT12)
/DS1E: DS1.1 (E), U4.20 (OUT15)
/DS1F: DS1.9 (F), U4.6 (OUT1)
/DS1G: DS1.10 (G), U4.5 (OUT0)
/DS2A: DS2.7 (A), U4.11 (OUT6)
/DS2B: DS2.6 (B), U4.12 (OUT7)
/DS2C: DS2.4 (C), U4.14 (OUT9)
/DS2D: DS2.2 (D), U4.15 (OUT10)
/DS2DP: DS2.5 (DP), U4.13 (OUT8)
/DS2E: DS2.1 (E), U4.16 (OUT11)
/DS2F: DS2.9 (F), U4.10 (OUT5)
/DS2G: DS2.10 (G), U4.9 (OUT4)
BLANK: J5.1 (Pin_1_1), U4.21 (~BLANK)
GND: C4.2, C5.2, C6.2, J8.1 (Pin_1_1), R4.2, U3.3 (W), U3.4 (VSS), U3.6 (GND), U3.10 (ADDR), U4.1 (GND)
I2CCLK: J7.1 (Pin_1_1), U3.9 (SCL)
I2CDAT: J6.1 (Pin_1_1), U3.8 (SDA)
LAT: J2.1 (Pin_1_1), U4.4 (LAT)
unnamed: R3.2, R4.1, U3.2 (A)
unnamed: C6.1, U3.5 (EXT_CAP)
unnamed: R3.1, U4.23 (IREF)
SCLK: J3.1 (Pin_1_1), U4.3 (SCLK)
SIN: J4.1 (Pin_1_1), U4.2 (SIN)

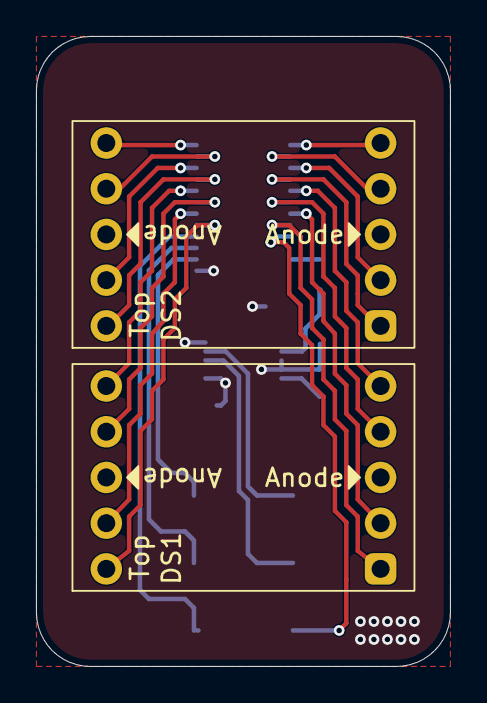
[picture p30: board NeedyCountdown.kicad_pcb from above]

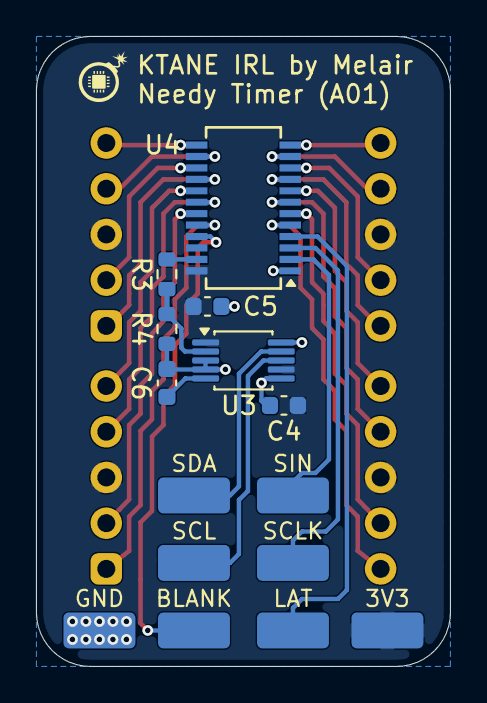
[picture p31: board NeedyCountdown.kicad_pcb from below]

Board: 2 copper layers, 23.0 x 35.0 mm, 17 parts (15 on the bottom side), 27 nets.
