melair/ktane/PCB/Modules/Comms/Comms.kicad_pcb

## KiCad design PCB/Modules/Comms/Comms.kicad_pcb (2026-09-24)

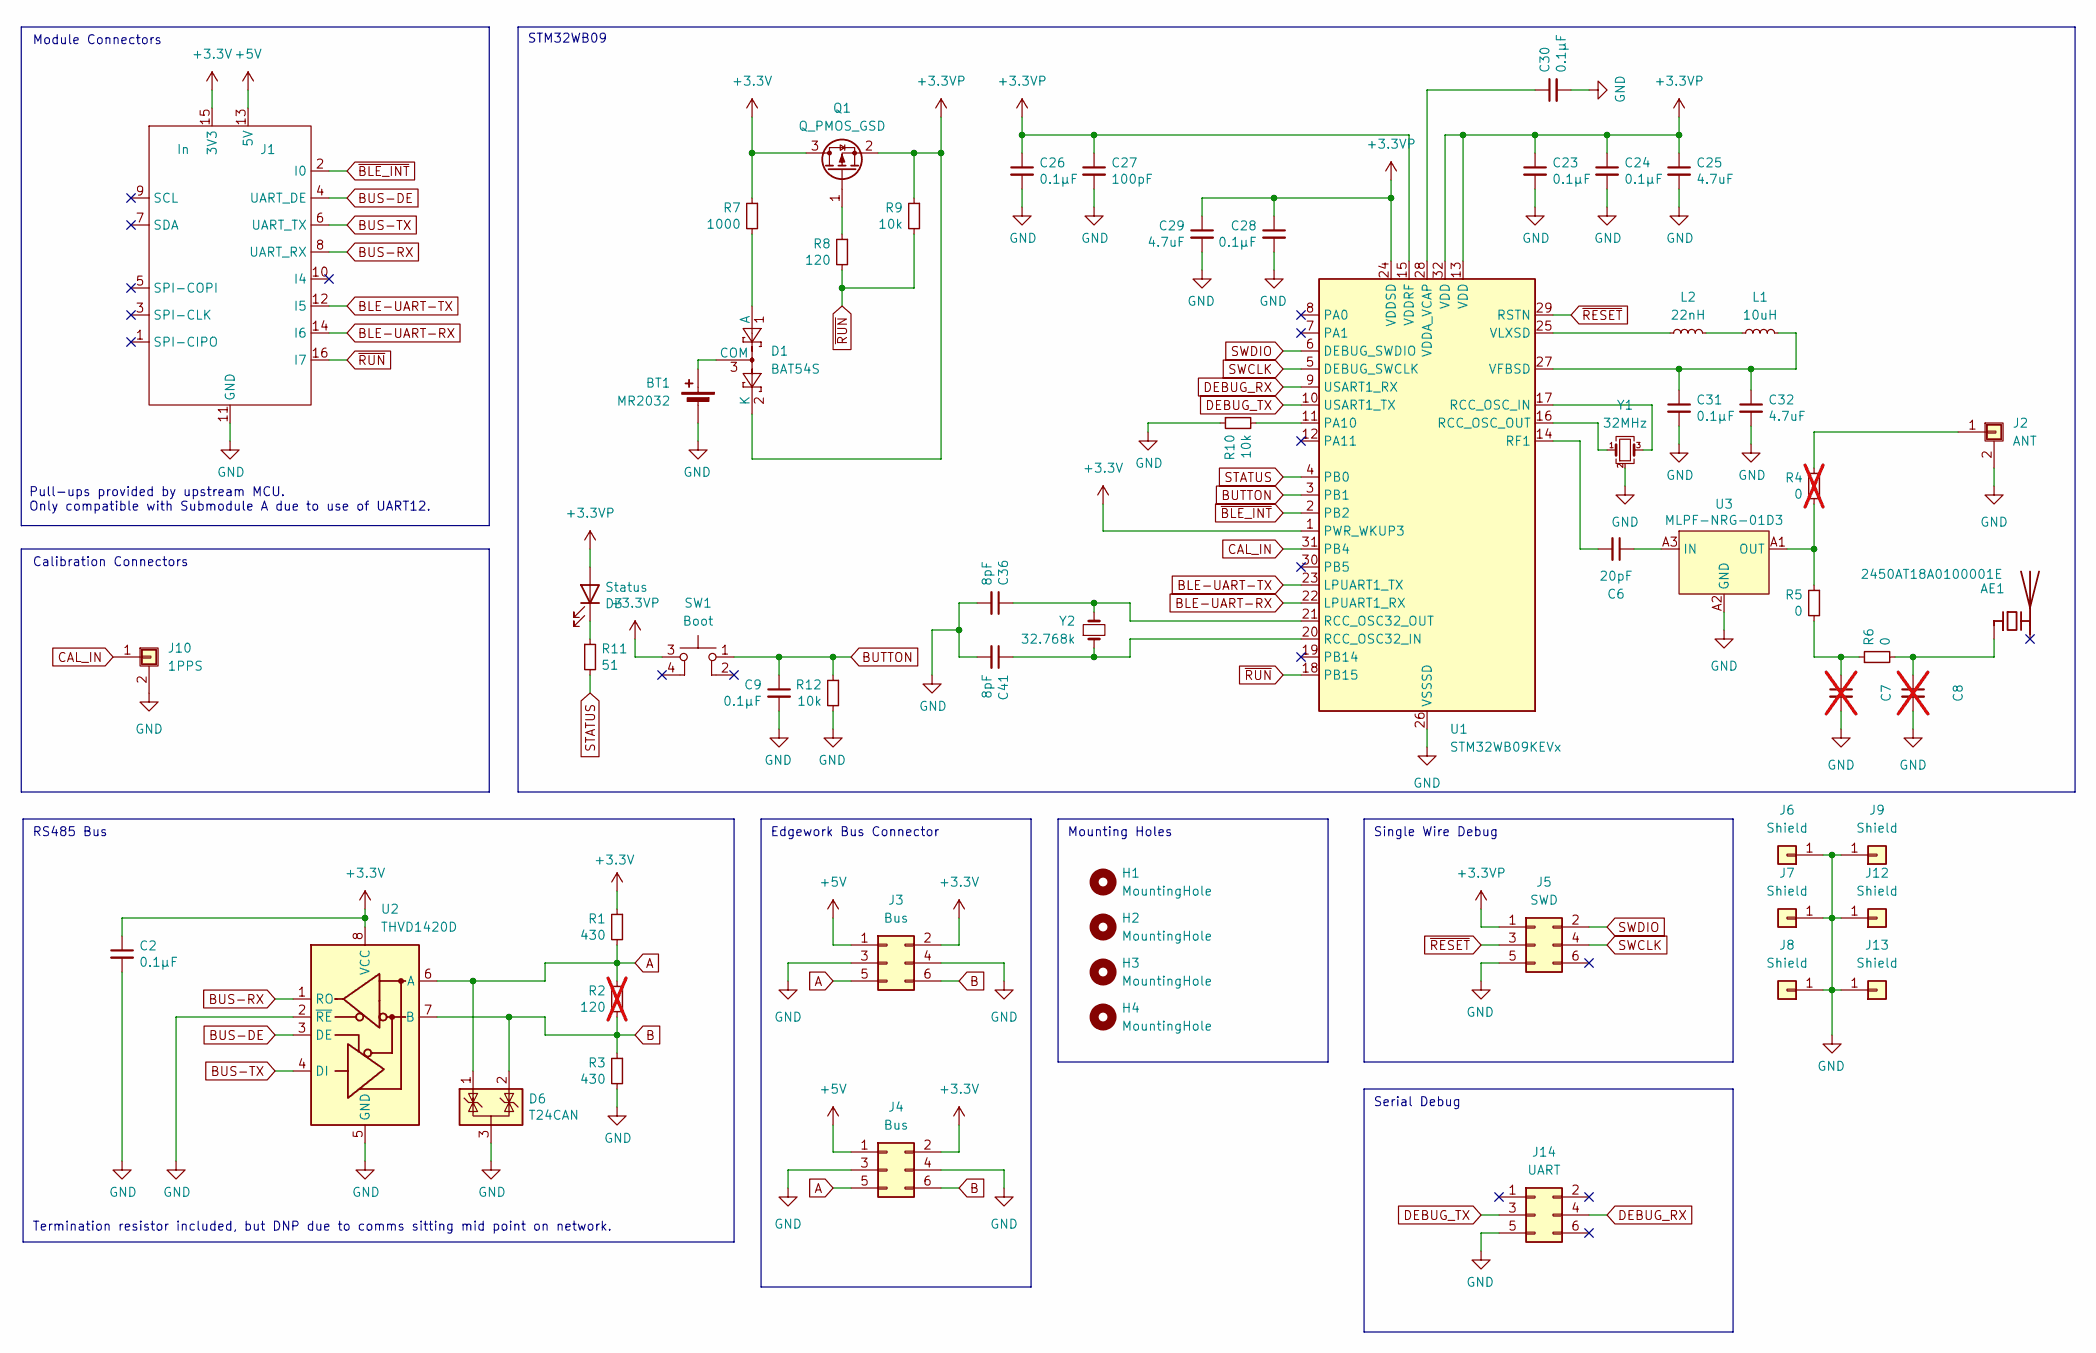
[picture p32: schematic Comms.kicad_sch, KTANE Physical Edition - Edgework Bus / BLE]

Parts:
AE1: 2450AT18A0100001E; Johanson_2450AT18x100_2400-2500Mhz; DIGIKEY 712-2450AT18A0100001ECT-ND
BT1: MR2032; CellHolder
C2, C9, C23, C24, C26, C28, C30, C31: 0.1μF; C_0603_1608Metric; DIGIKEY 1276-1005-1-ND
C6: 20pF; R_0402_1005Metric_Tweaked; DIGIKEY 1276-6601-1-ND
C7, C8: R_0402_1005Metric_Tweaked; DIGIKEY NONE; not fitted
C25, C29, C32: 4.7uF; C_0603_1608Metric; DIGIKEY 1276-2087-1-ND
C27: 100pF; C_0603_1608Metric; DIGIKEY 1276-1005-1-ND
C36, C41: 8pF; C_0603_1608Metric; DIGIKEY 490-GCM1885C2A8R0BA16JCT-ND
D1: BAT54S; SOT-23; DIGIKEY BAT54SLT1GOSCT-ND
D3: Status; LED_0603_1608Metric; DIGIKEY 160-1827-1-ND
D6: T24CAN; SOT-23; DIGIKEY STOCK
H1, H2, H3, H4: MountingHole; MountingHole_3.2mm_M3_NoCopper; DIGIKEY NONE
J1: In; PinHeader_2x08_P2.54mm_Vertical-Centered; DIGIKEY S9171-ND
J2: ANT; U.FL_Hirose_U.FL-R-SMT-1_Vertical; DIGIKEY 26-U.FL-R-SMT-1(32)CT-ND
J3, J4: Bus; PinHeader_2x03_P2.54mm_Vertical-Centered; DIGIKEY S9716-ND
J5: SWD; Tag-Connect_TC2030-IDC-NL_2x03_P1.27mm_Vertical; DIGIKEY NONE
J6, J7, J8, J9: Shield; EMI_Shield_Corner; DIGIKEY STOCK/AliExpress
J10: 1PPS; U.FL_Hirose_U.FL-R-SMT-1_Vertical; DIGIKEY 26-U.FL-R-SMT-1(32)CT-ND
J12, J13: Shield; EMI_Shield_Straight; DIGIKEY STOCK/AliExpress
J14: UART; Tag-Connect_TC2030-IDC-NL_2x03_P1.27mm_Vertical; DIGIKEY NONE
L1: 10uH; L_0805_2012Metric; DIGIKEY 490-LQM21DN100M70LCT-ND
L2: 22nH; L_0402_1005Metric; DIGIKEY 490-LQG15HN22NG02DCT-ND
Q1: Q_PMOS_GSD; SOT-23; DIGIKEY 4518-SI2307ACT-ND
R1, R3: 430; R_0603_1608Metric; DIGIKEY P430HCT-ND
R2: 120; R_0603_1608Metric; DIGIKEY P120HCT-ND; not fitted
R4: 0; R_0402_1005Metric_Tweaked; DIGIKEY 10-ERJ-H2G0R00XCT-ND; not fitted
R5, R6: 0; R_0402_1005Metric_Tweaked; DIGIKEY 10-ERJ-H2G0R00XCT-ND
R7: 1000; R_0603_1608Metric; DIGIKEY P1.00KHCT-ND
R8: 120; R_0603_1608Metric; DIGIKEY P120HCT-ND
R9, R10, R12: 10k; R_0603_1608Metric; DIGIKEY P10.0KHCT-ND
R11: 51; R_0603_1608Metric; DIGIKEY P51.0HCT-ND
SW1: Boot; PTS526Sx15SMTR2xLFS; DIGIKEY CKN12220-1-ND
U1: STM32WB09KEVx; QFN-32-1EP_5x5mm_P0.5mm_EP3.7x3.7mm; DIGIKEY 497-STM32WB09KEV6TRCT-ND
U2: THVD1420D; SOT-583-8; DIGIKEY 296-THVD1420DRLRCT-ND
U3: MLPF-NRG-01D3; DIGIKEY 497-MLPF-NRG-01D3CT-ND
Y1: 32MHz; Crystal_SMD_2016-4Pin_2.0x1.6mm; DIGIKEY 644-CS06654-32MCT-ND
Y2: 32.768k; Crystal_SMD_2012-2Pin_2.0x1.2mm; DIGIKEY XC3096CT-ND

Connections:
+3.3V: C2.1, J1.15 (3V3), J3.2, J4.2, Q1.3 (D), R1.1, R7.1, U1.1 (PWR_WKUP3), U2.8 (VCC)
+3.3VP: C23.1, C24.1, C25.1, C26.1, C27.1, C28.1, C29.1, D1.2 (K), D3.2 (A), J5.1, Q1.2 (S), R9.1, SW1.3, U1.13 (VDD), U1.15 (VDDRF), U1.24 (VDDSD), U1.32 (VDD)
+5V: J1.13 (5V), J3.1, J4.1
A: D6.1 (K), J3.5, J4.5, R1.2, R2.1, U2.6 (A)
B: D6.2 (K), J3.6, J4.6, R2.2, R3.1, U2.7 (B)
BLE-UART-RX: J1.14 (I6), U1.22 (LPUART1_RX)
BLE-UART-TX: J1.12 (I5), U1.23 (LPUART1_TX)
BUS-DE: J1.4 (UART_DE), U2.3 (DE)
BUS-RX: J1.8 (UART_RX), U2.1 (RO)
BUS-TX: J1.6 (UART_TX), U2.4 (DI)
BUTTON: C9.1, R12.1, SW1.1, U1.3 (PB1)
CAL_IN: J10.1, U1.31 (PB4)
DEBUG_RX: J14.4, U1.9 (USART1_RX)
DEBUG_TX: J14.3, U1.10 (USART1_TX)
GND: BT1.2 (-), C2.2, C7.2, C8.2, C9.2, C23.2, C24.2, C25.2, C26.2, C27.2, C28.2, C29.2, C30.2, C31.2, C32.2, C36.2, C41.2, D6.3 (A), J1.11 (GND), J2.2 (Shield), J3.3, J3.4, J4.3, J4.4, J5.5, J6.1 (Pin_1_1), J7.1 (Pin_1_1), J8.1 (Pin_1_1), J9.1 (Pin_1_1), J10.2 (Shield), J12.1 (Pin_1_1), J13.1 (Pin_1_1), J14.5, R3.2, R10.1, R12.2, U1.26 (VSSSD), U1.33 (VSSSD), U2.2 (~RE), U2.5 (GND), U3.A2 (GND), U3.B1 (GND), U3.B2 (GND), U3.B3 (GND), Y1.2 (G), Y1.4 (G)
unnamed: AE1.1 (FEED_1), C8.1, R6.2
unnamed: BT1.1 (+), D1.3 (COM)
unnamed: C7.1, R5.2, R6.1
unnamed: D1.1 (A), R7.2
unnamed: D3.1 (K), R11.1
unnamed: J2.1, R4.1
unnamed: L1.2, L2.1
unnamed: Q1.1 (G), R8.1
unnamed: U1.17 (RCC_OSC_IN), Y1.3
unnamed: U1.16 (RCC_OSC_OUT), Y1.1
unnamed: R10.2, U1.11 (PA10)
unnamed: C36.1, U1.21 (RCC_OSC32_OUT), Y2.2
unnamed: C41.1, U1.20 (RCC_OSC32_IN), Y2.1
unnamed: C6.2, U1.14 (RF1)
unnamed: C30.1, U1.28 (VDDA_VCAP)
unnamed: C31.1, C32.1, L1.1, U1.27 (VFBSD)
unnamed: L2.2, U1.25 (VLXSD)
unnamed: C6.1, U3.A3 (IN)
unnamed: R4.2, R5.1, U3.A1 (OUT)
STATUS: R11.2, U1.4 (PB0)
SWCLK: J5.4, U1.5 (DEBUG_SWCLK)
SWDIO: J5.2, U1.6 (DEBUG_SWDIO)
~BLE_INT: J1.2 (I0), U1.2 (PB2)
~RESET: J5.3, U1.29 (RSTN)
~RUN: J1.16 (I7), R8.2, R9.2, U1.18 (PB15)

Notes on the sheet:
Pull-ups provided by upstream MCU. Only compatible with Submodule A due to use of UART12.
Single Wire Debug
RS485 Bus
Module Connectors
Termination resistor included, but DNP due to comms sitting mid point on network.
Serial Debug
Mounting Holes
STM32WB09
Calibration Connectors
Edgework Bus Connector

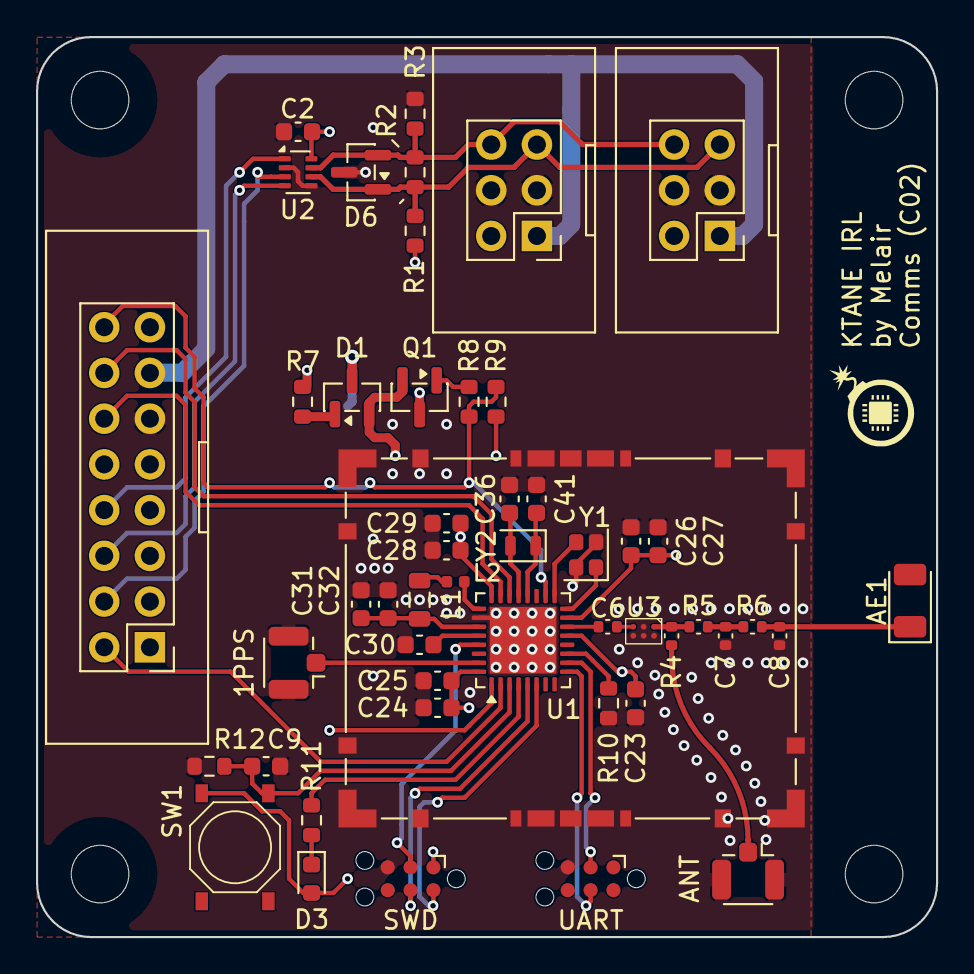
[picture p33: board Comms.kicad_pcb from above]

Board: 4 copper layers, 50.0 x 50.0 mm, 60 parts (1 on the bottom side), 40 nets.
