melair/ktane/PCB/Others/ARGBSingle/ARGBSingle.kicad_pcb

## KiCad design PCB/Others/ARGBSingle/ARGBSingle.kicad_pcb (2026-08-23)

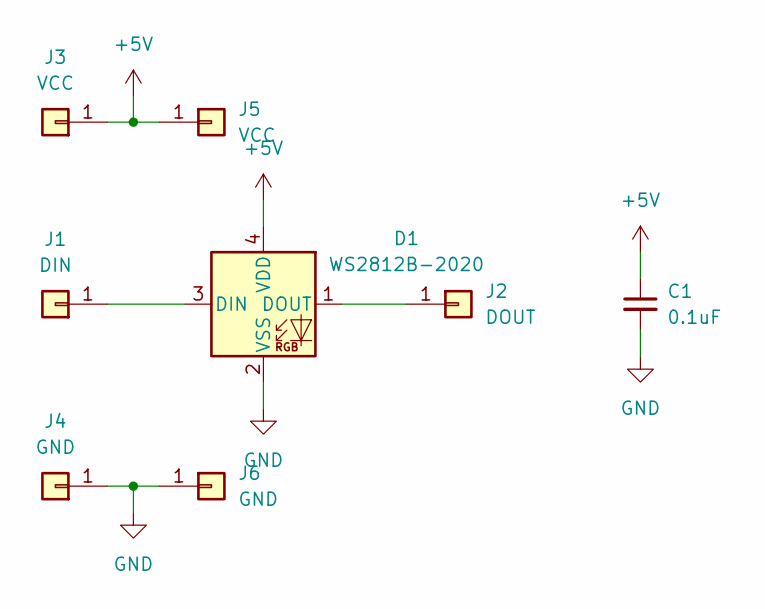
[picture p34: schematic ARGBSingle.kicad_sch]

Parts:
C1: 0.1uF; C_0603_1608Metric; JLCPCB Part # C597251
D1: WS2812B-2020; LED_WS2812B-2020_PLCC4_2.0x2.0mm; JLCPCB Part # C52917434
J1: DIN; Pad2.5x1.25
J2: DOUT; Pad2.5x1.25
J3, J5: VCC; Pad2.5x1.25
J4, J6: GND; Pad2.5x1.25

Connections:
+5V: C1.1, D1.4 (VDD), J3.1 (Pin_1_1), J5.1 (Pin_1_1)
GND: C1.2, D1.2 (VSS), J4.1 (Pin_1_1), J6.1 (Pin_1_1)
unnamed: D1.3 (DIN), J1.1 (Pin_1_1)
unnamed: D1.1 (DOUT), J2.1 (Pin_1_1)

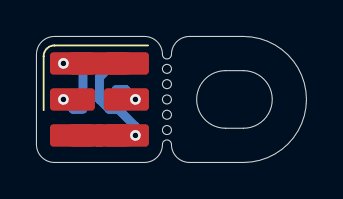
[picture p35: board ARGBSingle.kicad_pcb from above]

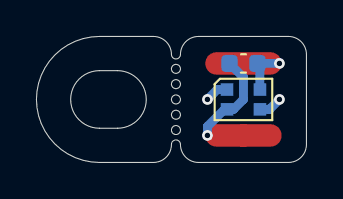
[picture p36: board ARGBSingle.kicad_pcb from below]

Board: 2 copper layers, 15.0 x 7.0 mm, 8 parts (2 on the bottom side), 4 nets.
