melair/ktane/PCB/Others/Strikes/Strikes.kicad_pcb

## KiCad design PCB/Others/Strikes/Strikes.kicad_pcb (2026-07-24)

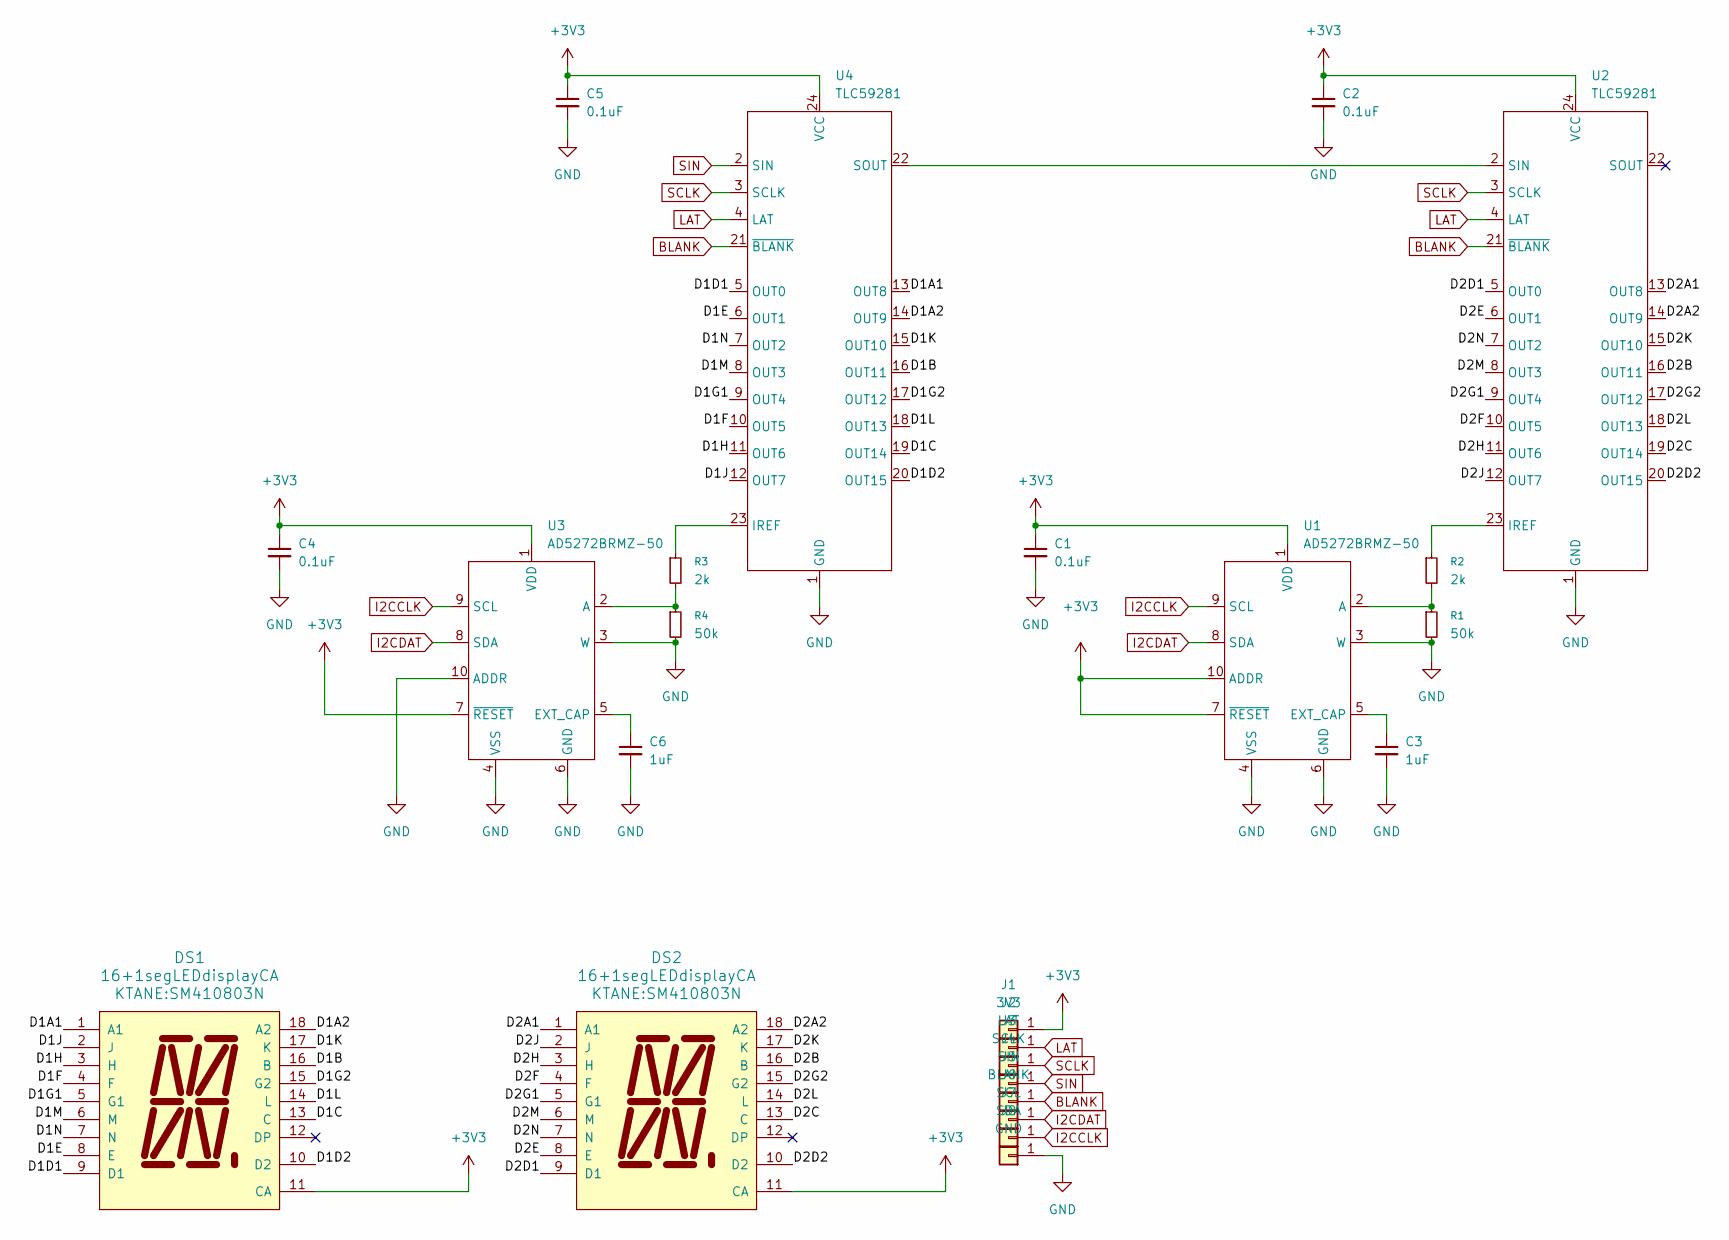
[picture p37: schematic Strikes.kicad_sch]

Parts:
C1, C2, C4, C5: 0.1uF; C_0603_1608Metric; DIGIKEY 1276-1005-1-ND
C3, C6: 1uF; C_0603_1608Metric; DIGIKEY 1276-1946-1-ND
DS1, DS2: 16+1segLEDdisplayCA; SM410803N; DIGIKEY STOCK/ALIEXPRESS
J1: 3V3; Pad4x2; DIGIKEY NONE
J2: LAT; Pad4x2; DIGIKEY NONE
J3: SCLK; Pad4x2; DIGIKEY NONE
J4: SIN; Pad4x2; DIGIKEY NONE
J5: BLANK; Pad4x2; DIGIKEY NONE
J6: SCL; Pad4x2; DIGIKEY NONE
J7: SDA; Pad4x2; DIGIKEY NONE
J8: GND; Pad4x2; DIGIKEY NONE
R1, R4: 50k; R_0603_1608Metric; DIGIKEY P51.0KHCT-ND
R2, R3: 2k; R_0603_1608Metric; DIGIKEY P2.00KHCT-ND
U1, U3: AD5272BRMZ-50; MSOP-10_3x3mm_P0.5mm; DIGIKEY 505-AD5272BRMZ-50-ND
U2, U4: TLC59281; SSOP-24_3.9x8.7mm_P0.635mm; DIGIKEY 296-25789-1-ND

Connections:
+3V3: C1.1, C2.1, C4.1, C5.1, DS1.11 (CA), DS2.11 (CA), J1.1, U1.1 (VDD), U1.7 (~RESET), U1.10 (ADDR), U2.24 (VCC), U3.1 (VDD), U3.7 (~RESET), U4.24 (VCC)
/D1A1: DS1.1 (A1), U4.13 (OUT8)
/D1A2: DS1.18 (A2), U4.14 (OUT9)
/D1B: DS1.16 (B), U4.16 (OUT11)
/D1C: DS1.13 (C), U4.19 (OUT14)
/D1D1: DS1.9 (D1), U4.5 (OUT0)
/D1D2: DS1.10 (D2), U4.20 (OUT15)
/D1E: DS1.8 (E), U4.6 (OUT1)
/D1F: DS1.4 (F), U4.10 (OUT5)
/D1G1: DS1.5 (G1), U4.9 (OUT4)
/D1G2: DS1.15 (G2), U4.17 (OUT12)
/D1H: DS1.3 (H), U4.11 (OUT6)
/D1J: DS1.2 (J), U4.12 (OUT7)
/D1K: DS1.17 (K), U4.15 (OUT10)
/D1L: DS1.14 (L), U4.18 (OUT13)
/D1M: DS1.6 (M), U4.8 (OUT3)
/D1N: DS1.7 (N), U4.7 (OUT2)
/D2A1: DS2.1 (A1), U2.13 (OUT8)
/D2A2: DS2.18 (A2), U2.14 (OUT9)
/D2B: DS2.16 (B), U2.16 (OUT11)
/D2C: DS2.13 (C), U2.19 (OUT14)
/D2D1: DS2.9 (D1), U2.5 (OUT0)
/D2D2: DS2.10 (D2), U2.20 (OUT15)
/D2E: DS2.8 (E), U2.6 (OUT1)
/D2F: DS2.4 (F), U2.10 (OUT5)
/D2G1: DS2.5 (G1), U2.9 (OUT4)
/D2G2: DS2.15 (G2), U2.17 (OUT12)
/D2H: DS2.3 (H), U2.11 (OUT6)
/D2J: DS2.2 (J), U2.12 (OUT7)
/D2K: DS2.17 (K), U2.15 (OUT10)
/D2L: DS2.14 (L), U2.18 (OUT13)
/D2M: DS2.6 (M), U2.8 (OUT3)
/D2N: DS2.7 (N), U2.7 (OUT2)
BLANK: J5.1, U2.21 (~BLANK), U4.21 (~BLANK)
GND: C1.2, C2.2, C3.2, C4.2, C5.2, C6.2, J8.1, R1.2, R4.2, U1.3 (W), U1.4 (VSS), U1.6 (GND), U2.1 (GND), U3.3 (W), U3.4 (VSS), U3.6 (GND), U3.10 (ADDR), U4.1 (GND)
I2CCLK: J7.1, U1.9 (SCL), U3.9 (SCL)
I2CDAT: J6.1, U1.8 (SDA), U3.8 (SDA)
LAT: J2.1, U2.4 (LAT), U4.4 (LAT)
unnamed: R1.1, R2.2, U1.2 (A)
unnamed: C3.1, U1.5 (EXT_CAP)
unnamed: R2.1, U2.23 (IREF)
unnamed: U2.2 (SIN), U4.22 (SOUT)
unnamed: R3.2, R4.1, U3.2 (A)
unnamed: C6.1, U3.5 (EXT_CAP)
unnamed: R3.1, U4.23 (IREF)
SCLK: J3.1, U2.3 (SCLK), U4.3 (SCLK)
SIN: J4.1, U4.2 (SIN)

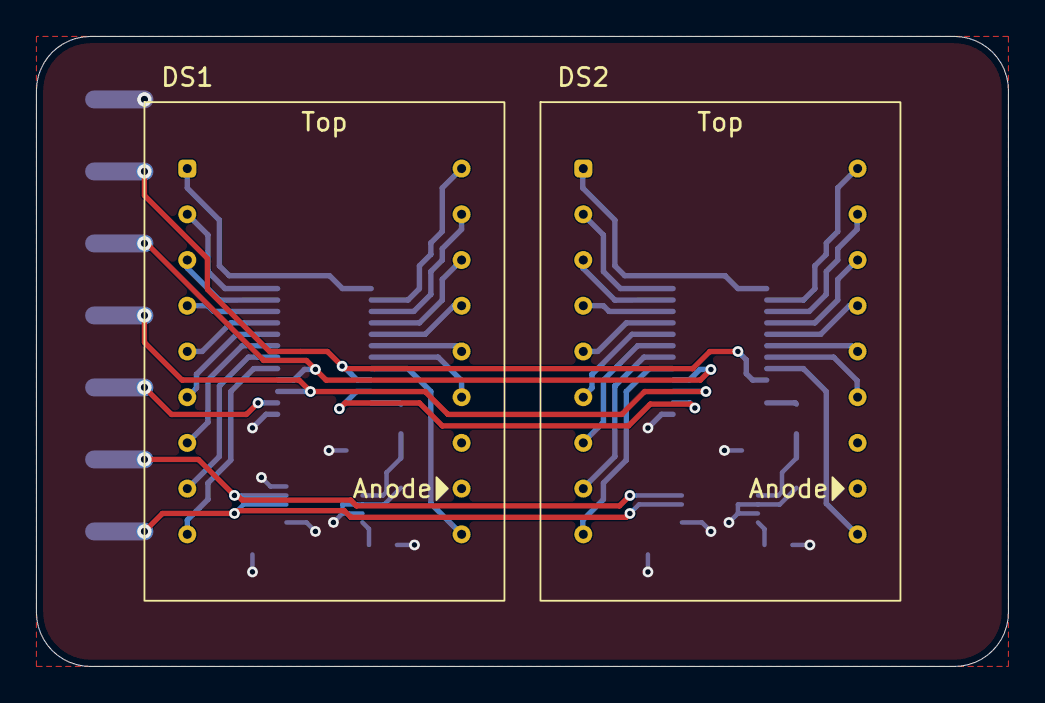
[picture p38: board Strikes.kicad_pcb from above]

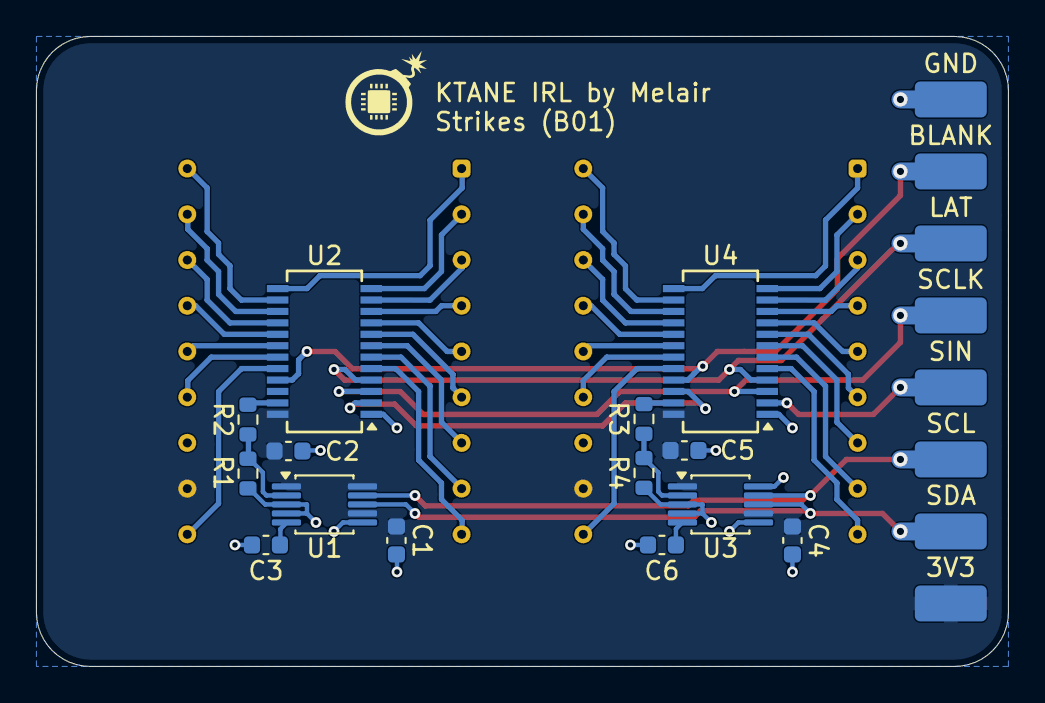
[picture p39: board Strikes.kicad_pcb from below]

Board: 2 copper layers, 54.0 x 35.0 mm, 24 parts (22 on the bottom side), 47 nets.
