melair/ktane/PCB/Edgework/Widget/Widget.kicad_pcb

## KiCad design PCB/Edgework/Widget/Widget.kicad_pcb (2026-06-27)

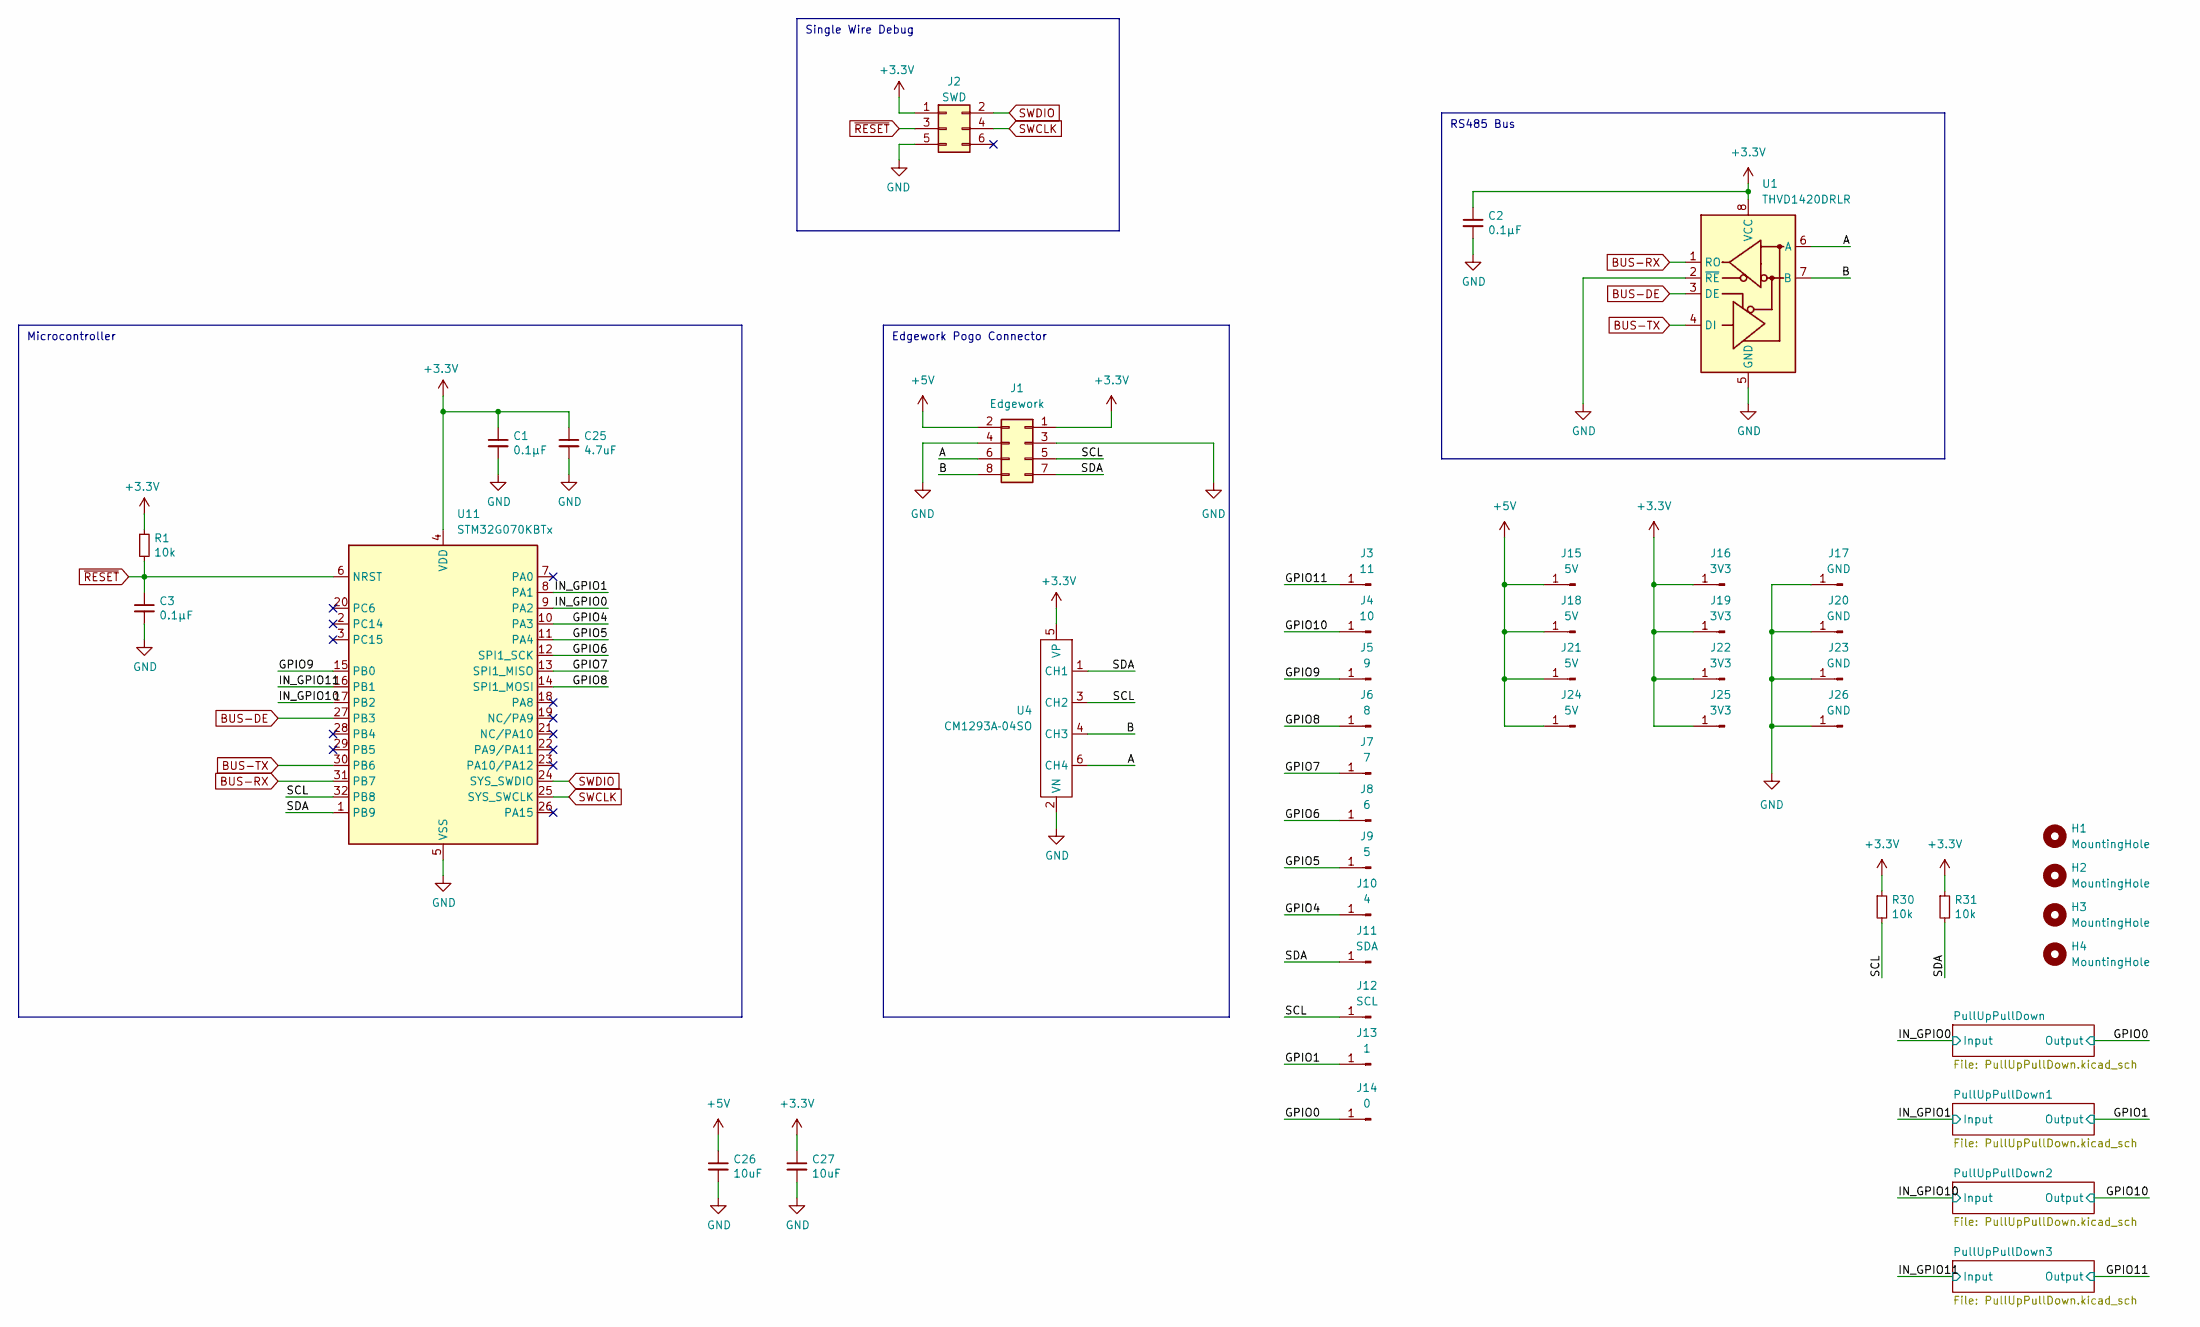
[picture p40: schematic Widget.kicad_sch, Edgework Widget]

Parts:
C1, C2, C3: 0.1μF; C_0603_1608Metric; DIGIKEY 1276-1005-1-ND
C25: 4.7uF; C_0603_1608Metric; DIGIKEY 1276-2087-1-ND
C26, C27: 10uF; C_0603_1608Metric; DIGIKEY 1276-1948-1-ND
H1, H2, H3, H4: MountingHole; MountingHole_3.2mm_M3_NoCopper; DIGIKEY NONE
J1: Edgework; PinHeader_2x04_P2.54mm_Horizontal; DIGIKEY STOCK/AliExpress
J2: SWD; Tag-Connect_TC2030-IDC-NL_2x03_P1.27mm_Vertical; DIGIKEY NONE
J3: 11; SolderPad; DIGIKEY NONE
J4: 10; SolderPad; DIGIKEY NONE
J5: 9; SolderPad; DIGIKEY NONE
J6: 8; SolderPad; DIGIKEY NONE
J7: 7; SolderPad; DIGIKEY NONE
J8: 6; SolderPad; DIGIKEY NONE
J9: 5; SolderPad; DIGIKEY NONE
J10: 4; SolderPad; DIGIKEY NONE
J11: SDA; SolderPad; DIGIKEY NONE
J12: SCL; SolderPad; DIGIKEY NONE
J13: 1; SolderPad; DIGIKEY NONE
J14: 0; SolderPad; DIGIKEY NONE
J15, J18, J21, J24: 5V; SolderPad; DIGIKEY NONE
J16, J19, J22, J25: 3V3; SolderPad; DIGIKEY NONE
J17, J20, J23, J26: GND; SolderPad; DIGIKEY NONE
R1, R30, R31: 10k; R_0603_1608Metric; DIGIKEY P10.0KHCT-ND
U1: THVD1420DRLR; SOT-583-8; DIGIKEY 296-THVD1420DRLRCT-ND
U4: CM1293A‐04SO; SC-74-6_1.55x2.9mm_P0.95mm; DIGIKEY CM1293A-04SOOSCT-ND
U11: STM32G070KBTx; LQFP-32_7x7mm_P0.8mm; DIGIKEY 497-STM32G070KBT6-ND

Connections:
+3.3V: C1.1, C2.1, C25.1, C27.1, J1.1, J2.1, J16.1 (Pin_1_1), J19.1 (Pin_1_1), J22.1 (Pin_1_1), J25.1 (Pin_1_1), R1.1, R30.1, R31.1, U1.8 (VCC), U4.5 (VP), U11.4 (VDD); also elsewhere on the board
+5V: C26.1, J1.2, J15.1 (Pin_1_1), J18.1 (Pin_1_1), J21.1 (Pin_1_1), J24.1 (Pin_1_1); also elsewhere on the board
/A: J1.6, U1.6 (A), U4.6 (CH4)
/B: J1.8, U1.7 (B), U4.4 (CH3)
/GPIO0: J14.1 (Pin_1_1); also elsewhere on the board
/GPIO1: J13.1 (Pin_1_1); also elsewhere on the board
/GPIO4: J10.1 (Pin_1_1), U11.10 (PA3)
/GPIO5: J9.1 (Pin_1_1), U11.11 (PA4)
/GPIO6: J8.1 (Pin_1_1), U11.12 (SPI1_SCK)
/GPIO7: J7.1 (Pin_1_1), U11.13 (SPI1_MISO)
/GPIO8: J6.1 (Pin_1_1), U11.14 (SPI1_MOSI)
/GPIO9: J5.1 (Pin_1_1), U11.15 (PB0)
/GPIO10: J4.1 (Pin_1_1); also elsewhere on the board
/GPIO11: J3.1 (Pin_1_1); also elsewhere on the board
/IN_GPIO0: U11.9 (PA2); also elsewhere on the board
/IN_GPIO1: U11.8 (PA1); also elsewhere on the board
/IN_GPIO10: U11.17 (PB2); also elsewhere on the board
/IN_GPIO11: U11.16 (PB1); also elsewhere on the board
/SCL: J1.5, J12.1 (Pin_1_1), R30.2, U4.3 (CH2), U11.32 (PB8)
/SDA: J1.7, J11.1 (Pin_1_1), R31.2, U4.1 (CH1), U11.1 (PB9)
BUS-DE: U1.3 (DE), U11.27 (PB3)
BUS-RX: U1.1 (RO), U11.31 (PB7)
BUS-TX: U1.4 (DI), U11.30 (PB6)
GND: C1.2, C2.2, C3.2, C25.2, C26.2, C27.2, J1.3, J1.4, J2.5, J17.1 (Pin_1_1), J20.1 (Pin_1_1), J23.1 (Pin_1_1), J26.1 (Pin_1_1), U1.2 (~RE), U1.5 (GND), U4.2 (VN), U11.5 (VSS); also elsewhere on the board
SWCLK: J2.4, U11.25 (SYS_SWCLK)
SWDIO: J2.2, U11.24 (SYS_SWDIO)
~RESET: C3.1, J2.3, R1.2, U11.6 (NRST)

Notes on the sheet:
Edgework Pogo Connector
Microcontroller
Single Wire Debug
RS485 Bus

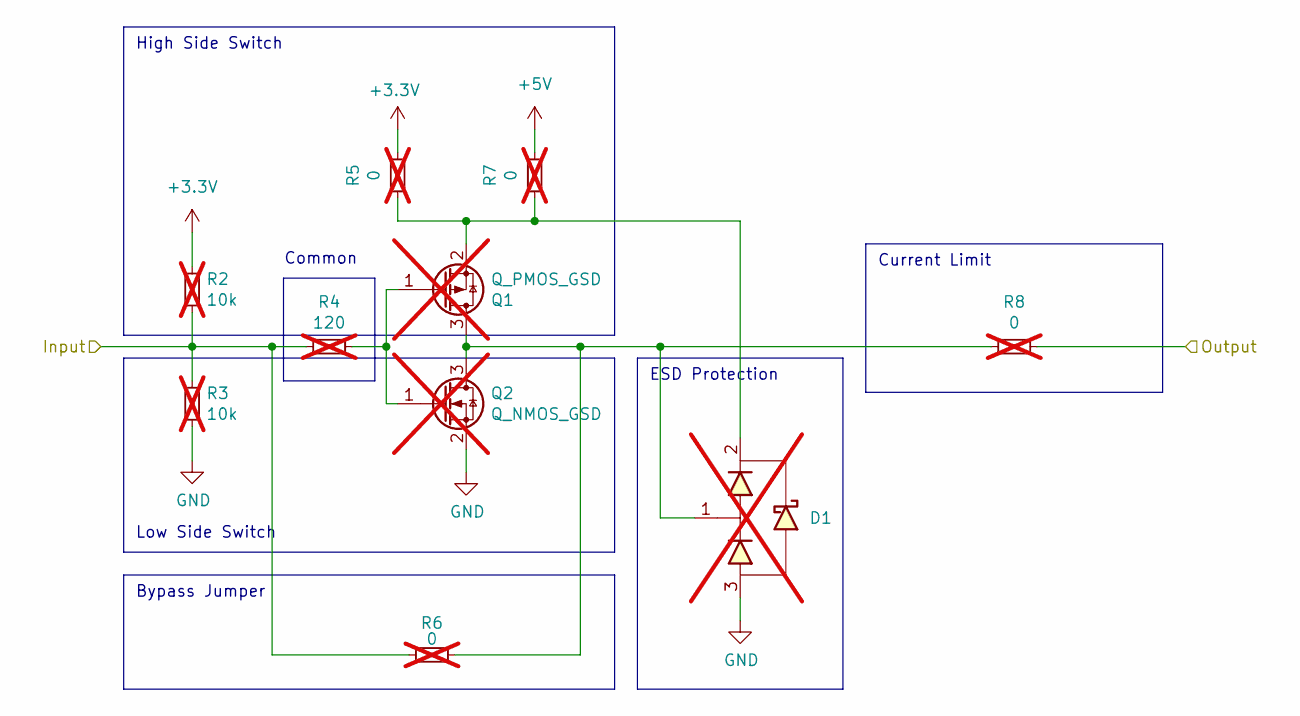
[picture p41: schematic PullUpPullDown.kicad_sch]

Parts:
D1: D1213A-01SO-7; SOT-23; DIGIKEY D1213A-01SO-7DICT-ND; not fitted
Q1: Q_PMOS_GSD; SOT-23; DIGIKEY DMG2301L-7DICT-ND; not fitted
Q2: Q_NMOS_GSD; SOT-23; DIGIKEY 31-DMN2310U-7CT-ND; not fitted
R2, R3: 10k; R_0603_1608Metric; DIGIKEY P10.0KHCT-ND; not fitted
R4: 120; R_0603_1608Metric; DIGIKEY P120HCT-ND; not fitted
R5, R6, R7, R8: 0; R_0603_1608Metric; DIGIKEY 10-ERJ-H3G0R00VCT-ND; not fitted

Connections:
+3.3V: R2.2, R5.1; also elsewhere on the board
+5V: R7.1; also elsewhere on the board
/GPIO0: R8.1; also elsewhere on the board
/IN_GPIO0: R2.1, R3.2, R4.1, R6.2; also elsewhere on the board
GND: D1.3, Q2.2 (S), R3.1; also elsewhere on the board
unnamed: D1.1, Q1.3 (D), Q2.3 (D), R6.1, R8.2
unnamed: Q1.1 (G), Q2.1 (G), R4.2
unnamed: D1.2, Q1.2 (S), R5.2, R7.2

Parts of its further copies:
D2, D3, D4: D1213A-01SO-7; SOT-23; DIGIKEY D1213A-01SO-7DICT-ND; not fitted
Q3, Q5, Q7: Q_PMOS_GSD; SOT-23; DIGIKEY DMG2301L-7DICT-ND; not fitted
Q4, Q6, Q8: Q_NMOS_GSD; SOT-23; DIGIKEY 31-DMN2310U-7CT-ND; not fitted
R9, R10, R16, R17, R23, R24: 10k; R_0603_1608Metric; DIGIKEY P10.0KHCT-ND; not fitted
R11, R18, R25: 120; R_0603_1608Metric; DIGIKEY P120HCT-ND; not fitted
R12, R13, R14, R15, R19, R20, R21, R22, R26, R27, R28, R29: 0; R_0603_1608Metric; DIGIKEY 10-ERJ-H3G0R00VCT-ND; not fitted

Connections of its further copies:
+3.3V: R9.2, R12.1, R16.2, R19.1, R23.2, R26.1; also elsewhere on the board
+5V: R14.1, R21.1, R28.1; also elsewhere on the board
/GPIO1: R15.1; also elsewhere on the board
/GPIO10: R22.1; also elsewhere on the board
/GPIO11: R29.1; also elsewhere on the board
/IN_GPIO1: R9.1, R10.2, R11.1, R13.2; also elsewhere on the board
/IN_GPIO10: R16.1, R17.2, R18.1, R20.2; also elsewhere on the board
/IN_GPIO11: R23.1, R24.2, R25.1, R27.2; also elsewhere on the board
GND: D2.3, D3.3, D4.3, Q4.2 (S), Q6.2 (S), Q8.2 (S), R10.1, R17.1, R24.1; also elsewhere on the board
unnamed: D2.1, Q3.3 (D), Q4.3 (D), R13.1, R15.2
unnamed: Q3.1 (G), Q4.1 (G), R11.2
unnamed: D2.2, Q3.2 (S), R12.2, R14.2
unnamed: D3.1, Q5.3 (D), Q6.3 (D), R20.1, R22.2
unnamed: Q5.1 (G), Q6.1 (G), R18.2
unnamed: D3.2, Q5.2 (S), R19.2, R21.2
unnamed: D4.1, Q7.3 (D), Q8.3 (D), R27.1, R29.2
unnamed: Q7.1 (G), Q8.1 (G), R25.2
unnamed: D4.2, Q7.2 (S), R26.2, R28.2

Notes on the sheet:
High Side Switch
Current Limit
Bypass Jumper
ESD Protection
Low Side Switch
Common

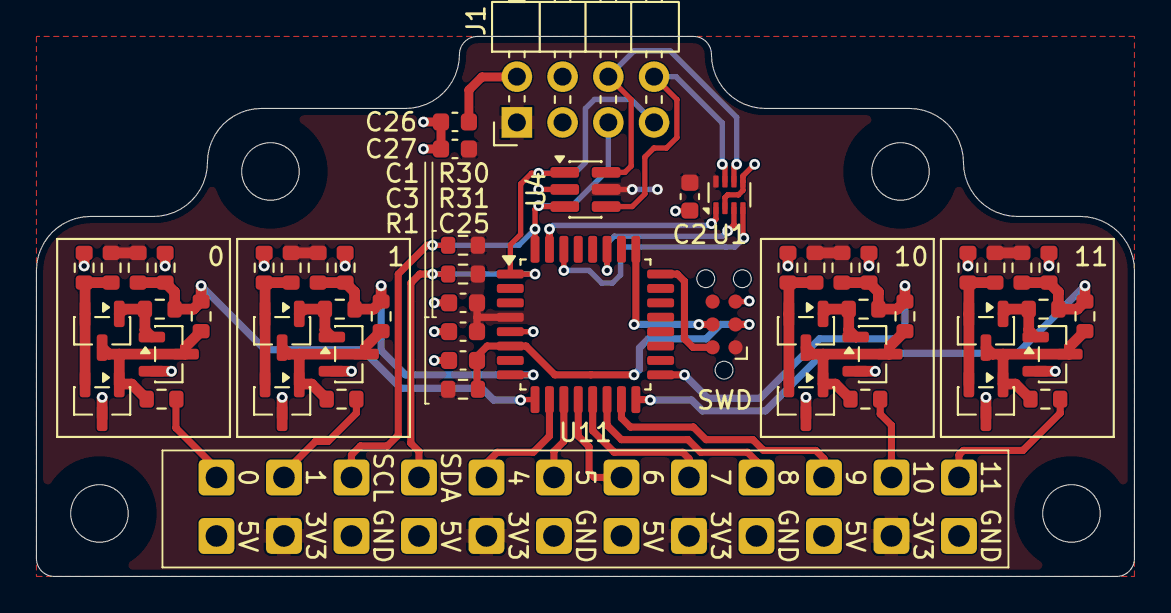
[picture p42: board Widget.kicad_pcb from above]

Board: 4 copper layers, 61.0 x 30.0 mm, 82 parts (0 on the bottom side), 39 nets.
