melair/ktane/PCB/Backplane/Backplane.kicad_pcb

## KiCad design PCB/Backplane/Backplane.kicad_pcb (2026-06-27)

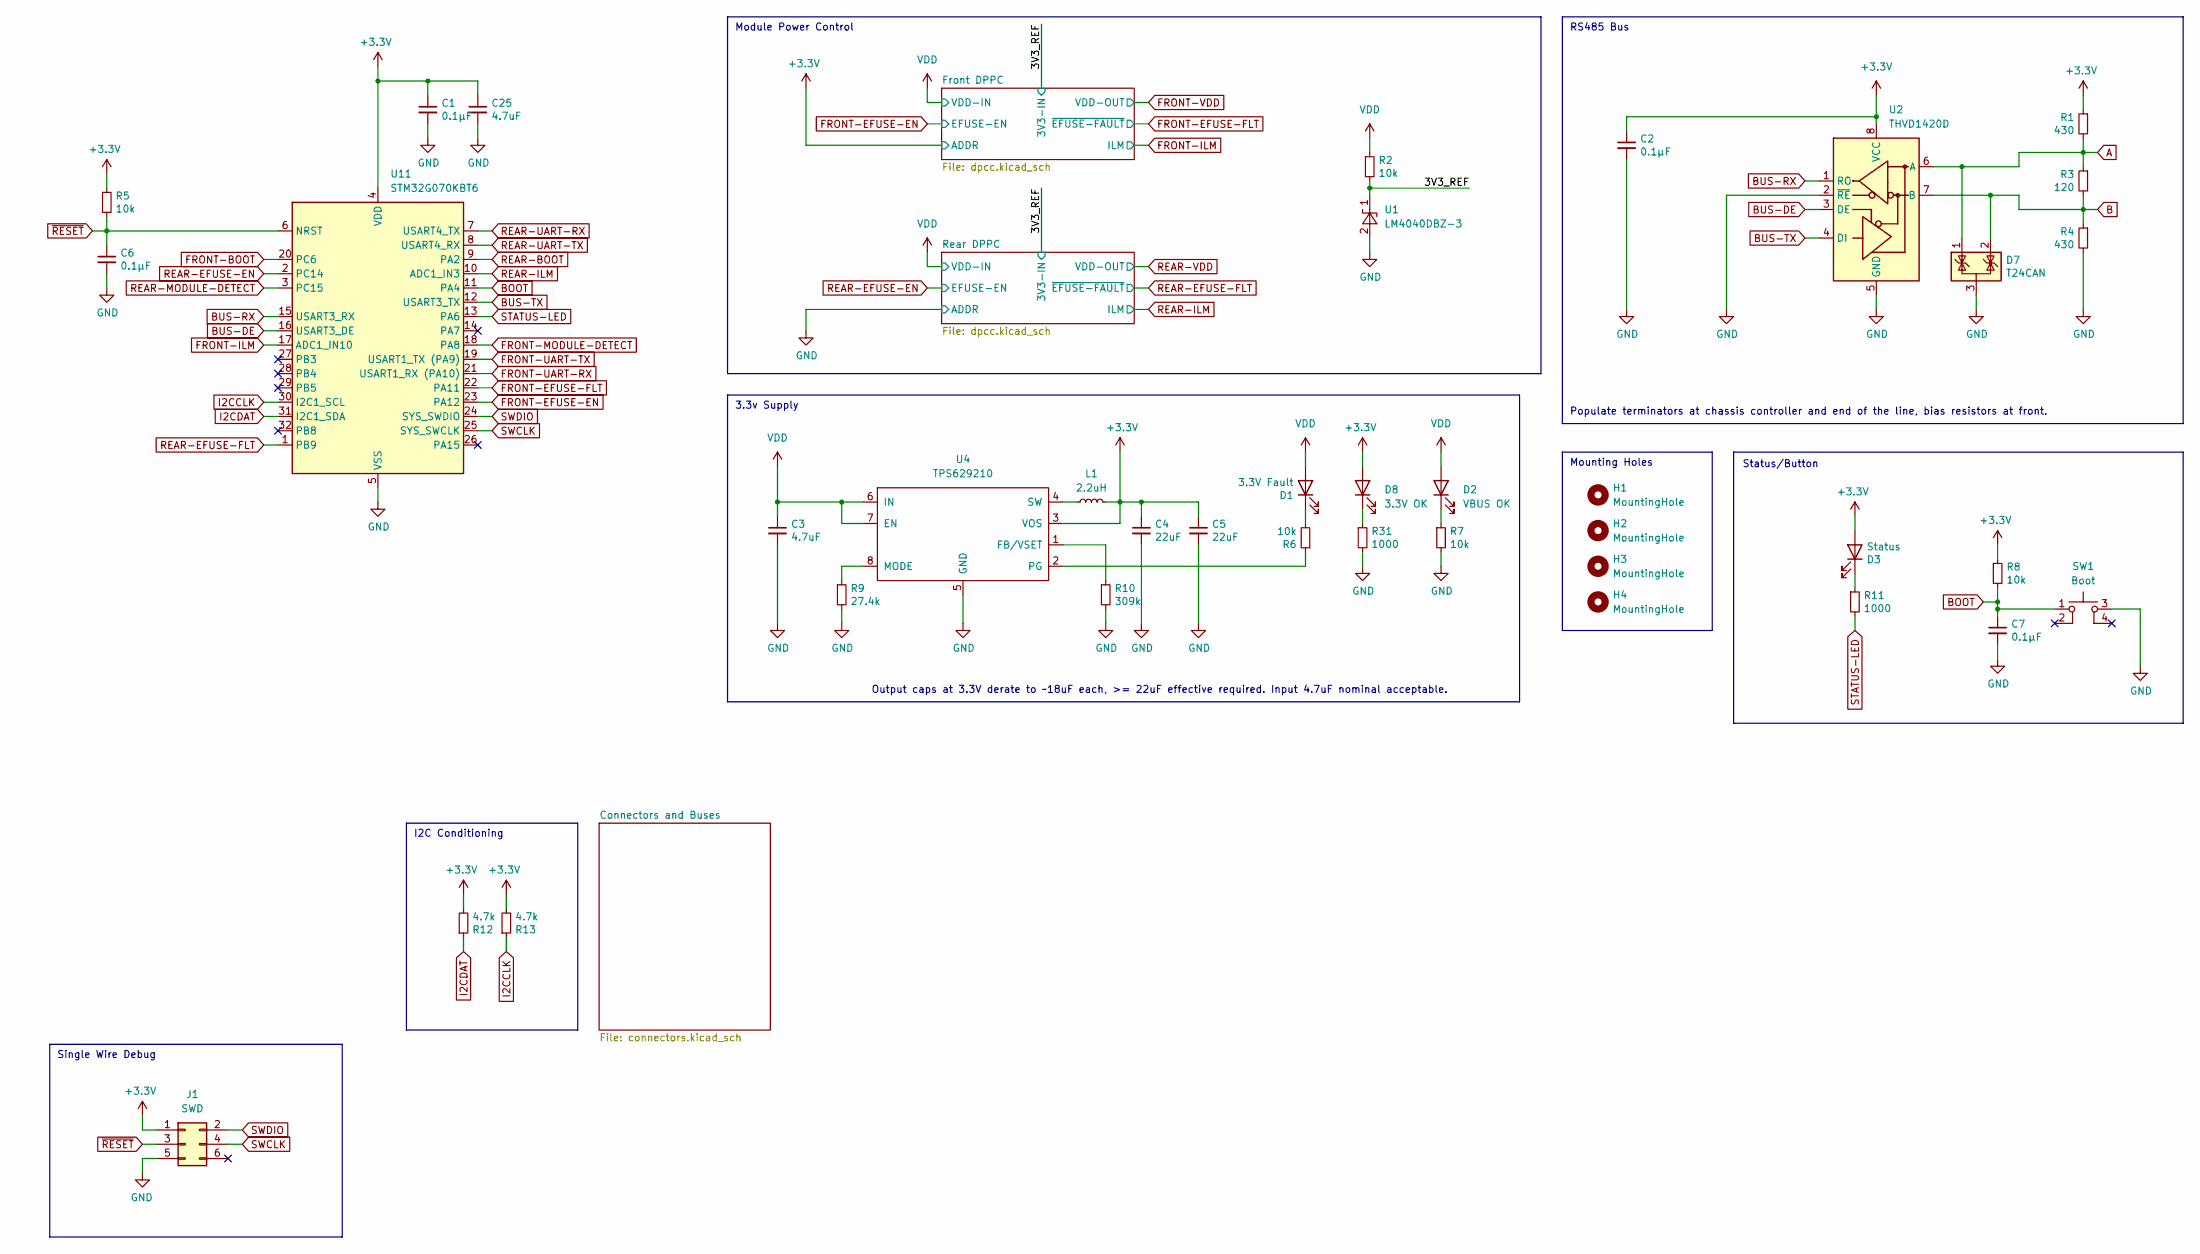
[picture p43: schematic Backplane.kicad_sch]

Parts:
C1, C2, C6, C7: 0.1μF; C_0603_1608Metric; DIGIKEY 1276-1005-1-ND
C3: 4.7uF; C_1206_3216Metric; DIGIKEY 445-1606-1-ND
C4, C5: 22uF; C_1206_3216Metric; DIGIKEY 1276-3148-1-ND
C25: 4.7uF; C_0603_1608Metric; DIGIKEY 1276-2087-1-ND
D1: 3.3V Fault; LED_0603_1608Metric; DIGIKEY 3147-B19Y1USD-20C000113U1930CT-ND
D2: VBUS OK; LED_0603_1608Metric; DIGIKEY 3147-B19Y1USD-20C000113U1930CT-ND
D3: Status; LED_0603_1608Metric; DIGIKEY 3147-B19Y1UYG-20C000313U1930CT-ND
D7: T24CAN; SOT-23; DIGIKEY CDSOT23-T24CANCT-ND
D8: 3.3V OK; LED_0603_1608Metric; DIGIKEY 3147-B19Y1UYG-20C000313U1930CT-ND
H1, H2, H3, H4: MountingHole; MountingHole_3.2mm_M3_NoCopper; DIGIKEY NONE
J1: SWD; Tag-Connect_TC2030-IDC-NL_2x03_P1.27mm_Vertical; DIGIKEY NONE
L1: 2.2uH; L_1008_2520Metric; DIGIKEY 490-DFE252012PD-2R2M=P2CT-ND
R1, R4: 430; R_0603_1608Metric; DIGIKEY P430HCT-ND
R2, R5, R6, R7, R8: 10k; R_0603_1608Metric; DIGIKEY P10.0KHCT-ND
R3: 120; R_0603_1608Metric; DIGIKEY P120HCT-ND
R9: 27.4k; R_0603_1608Metric; DIGIKEY P27.4KHCT-ND
R10: 309k; R_0603_1608Metric; DIGIKEY P309KHCT-ND
R11: 1000; R_0603_1608Metric; DIGIKEY P1.00KHCT-ND
R12, R13: 4.7k; R_0603_1608Metric; DIGIKEY P4.7KHCT-ND
R31: 1000; R_0603_1608Metric; DIGIKEY P1.0KHCT-ND
SW1: Boot; PTS526Sx15SMTR2xLFS; DIGIKEY CKN12220-1-ND
U1: LM4040DBZ-3; SOT-23; DIGIKEY 31-LM4040C33FTACT-ND
U2: THVD1420D; SOT-583-8; DIGIKEY 296-THVD1420DRLRCT-ND
U4: TPS629210; SOT-583-8; DIGIKEY 296-TPS629210DRLRCT-ND
U11: STM32G070KBT6; LQFP-32_7x7mm_P0.8mm; DIGIKEY 497-STM32G070KBT6-ND

Connections:
+3.3V: C1.1, C2.1, C4.1, C5.1, C25.1, D3.2 (A), D8.2 (A), J1.1, L1.2, R1.1, R5.1, R8.1, R12.2, R13.2, U2.8 (VCC), U4.3 (VOS), U11.4 (VDD); also elsewhere on the board
/3V3_REF: R2.2, U1.1 (K); also elsewhere on the board
A: D7.1 (K), R1.2, R3.1, U2.6 (A); also elsewhere on the board
B: D7.2 (K), R3.2, R4.1, U2.7 (B); also elsewhere on the board
BOOT: C7.1, R8.2, SW1.1, U11.11 (PA4)
BUS-DE: U2.3 (DE), U11.16 (USART3_DE)
BUS-RX: U2.1 (RO), U11.15 (USART3_RX)
BUS-TX: U2.4 (DI), U11.12 (USART3_TX)
FRONT-BOOT: U11.20 (PC6); also elsewhere on the board
FRONT-EFUSE-EN: U11.23 (PA12); also elsewhere on the board
FRONT-EFUSE-FLT: U11.22 (PA11); also elsewhere on the board
FRONT-ILM: U11.17 (ADC1_IN10); also elsewhere on the board
FRONT-MODULE-DETECT: U11.18 (PA8); also elsewhere on the board
FRONT-UART-RX: U11.21 (USART1_RX (PA10)); also elsewhere on the board
FRONT-UART-TX: U11.19 (USART1_TX (PA9)); also elsewhere on the board
GND: C1.2, C2.2, C3.2, C4.2, C5.2, C6.2, C7.2, C25.2, D7.3 (A), J1.5, R4.2, R7.2, R9.2, R10.2, R31.2, SW1.3, U1.2 (A), U2.2 (~RE), U2.5 (GND), U4.5 (GND), U11.5 (VSS); also elsewhere on the board
I2CCLK: R13.1, U11.30 (I2C1_SCL); also elsewhere on the board
I2CDAT: R12.1, U11.31 (I2C1_SDA); also elsewhere on the board
unnamed: D1.1 (K), R6.2
unnamed: D2.1 (K), R7.1
unnamed: D3.1 (K), R11.1
unnamed: D8.1 (K), R31.1
unnamed: R10.1, U4.1 (FB/VSET)
unnamed: R9.1, U4.8 (MODE)
unnamed: R6.1, U4.2 (PG)
unnamed: L1.1, U4.4 (SW)
REAR-BOOT: U11.9 (PA2); also elsewhere on the board
REAR-EFUSE-EN: U11.2 (PC14); also elsewhere on the board
REAR-EFUSE-FLT: U11.1 (PB9); also elsewhere on the board
REAR-ILM: U11.10 (ADC1_IN3); also elsewhere on the board
REAR-MODULE-DETECT: U11.3 (PC15); also elsewhere on the board
REAR-UART-RX: U11.7 (USART4_TX); also elsewhere on the board
REAR-UART-TX: U11.8 (USART4_RX); also elsewhere on the board
STATUS-LED: R11.2, U11.13 (PA6)
SWCLK: J1.4, U11.25 (SYS_SWCLK)
SWDIO: J1.2, U11.24 (SYS_SWDIO)
VDD: C3.1, D1.2 (A), D2.2 (A), R2.1, U4.6 (IN), U4.7 (EN); also elsewhere on the board
~RESET: C6.1, J1.3, R5.2, U11.6 (NRST)

Notes on the sheet:
I2C Conditioning
Module Power Control
Single Wire Debug
Output caps at 3.3V derate to ~18uF each, >= 22uF effective required. Input 4.7uF nominal acceptable.
Status/Button
Mounting Holes
3.3v Supply
Populate terminators at chassis controller and end of the line, bias resistors at front.
RS485 Bus

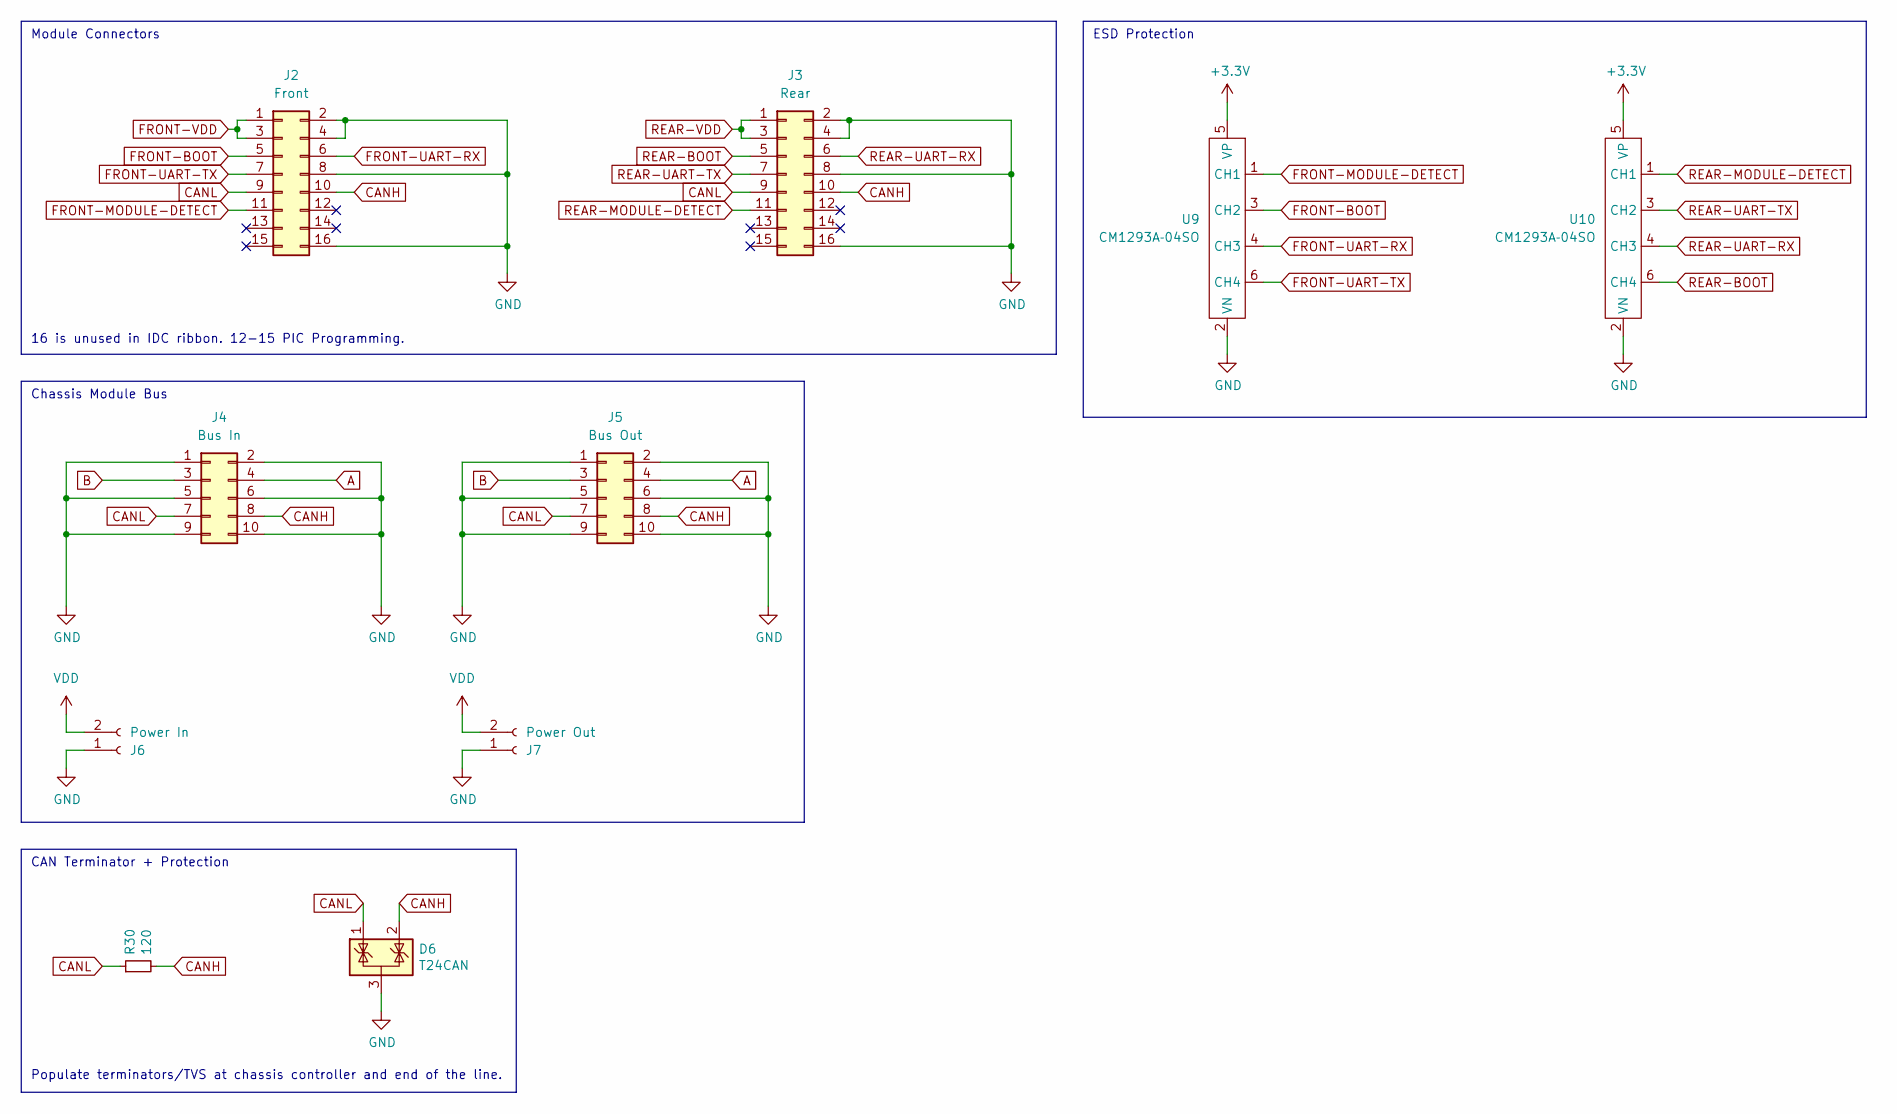
[picture p44: schematic connectors.kicad_sch]

Parts:
D6: T24CAN; SOT-23; DIGIKEY CDSOT23-T24CANCT-ND
J2: Front; PinHeader_2x08_P2.54mm_VerticalAndHorizontal_Centered; DIGIKEY STOCK/Toby
J3: Rear; PinHeader_2x08_P2.54mm_VerticalAndHorizontal_Centered; DIGIKEY STOCK/Toby
J4: Bus In; PinHeader_2x05_P2.54mm_VerticalAndHorizontal_Centered; DIGIKEY STOCK/Toby
J5: Bus Out; PinHeader_2x05_P2.54mm_VerticalAndHorizontal_Centered; DIGIKEY STOCK/Toby
J6: Power In; AMASS_XT30PW-M_1x02_P2.50mm_Horizontal; DIGIKEY STOCK/ALIEXPRESS
J7: Power Out; AMASS_XT30PW-F_1x02_P2.50mm_Horizontal; DIGIKEY STOCK/ALIEXPRESS
R30: 120; R_0603_1608Metric; DIGIKEY P120HCT-ND
U9, U10: CM1293A‐04SO; SC-74-6_1.55x2.9mm_P0.95mm; DIGIKEY CM1293A-04SOOSCT-ND

Connections:
+3.3V: U9.5 (VP), U10.5 (VP); also elsewhere on the board
A: J4.4, J5.4; also elsewhere on the board
B: J4.3, J5.3; also elsewhere on the board
CANH: D6.2 (K), J2.10, J3.10, J4.8, J5.8, R30.2
CANL: D6.1 (K), J2.9, J3.9, J4.7, J5.7, R30.1
FRONT-BOOT: J2.5, U9.3 (CH2); also elsewhere on the board
FRONT-MODULE-DETECT: J2.11, U9.1 (CH1); also elsewhere on the board
FRONT-UART-RX: J2.6, U9.4 (CH3); also elsewhere on the board
FRONT-UART-TX: J2.7, U9.6 (CH4); also elsewhere on the board
FRONT-VDD: J2.1, J2.3; also elsewhere on the board
GND: D6.3 (A), J2.2, J2.4, J2.8, J2.16, J3.2, J3.4, J3.8, J3.16, J4.1, J4.2, J4.5, J4.6, J4.9, J4.10, J5.1, J5.2, J5.5, J5.6, J5.9, J5.10, J6.1, J7.1, U9.2 (VN), U10.2 (VN); also elsewhere on the board
REAR-BOOT: J3.5, U10.6 (CH4); also elsewhere on the board
REAR-MODULE-DETECT: J3.11, U10.1 (CH1); also elsewhere on the board
REAR-UART-RX: J3.6, U10.4 (CH3); also elsewhere on the board
REAR-UART-TX: J3.7, U10.3 (CH2); also elsewhere on the board
REAR-VDD: J3.1, J3.3; also elsewhere on the board
VDD: J6.2, J7.2; also elsewhere on the board

Notes on the sheet:
Chassis Module Bus
Module Connectors
CAN Terminator + Protection
16 is unused in IDC ribbon. 12-15 PIC Programming.
Populate terminators/TVS at chassis controller and end of the line.
ESD Protection
