melair/ktane/PCB/Backplane/Backplane.kicad_pcb

## KiCad design PCB/Backplane/Backplane.kicad_pcb (continued)

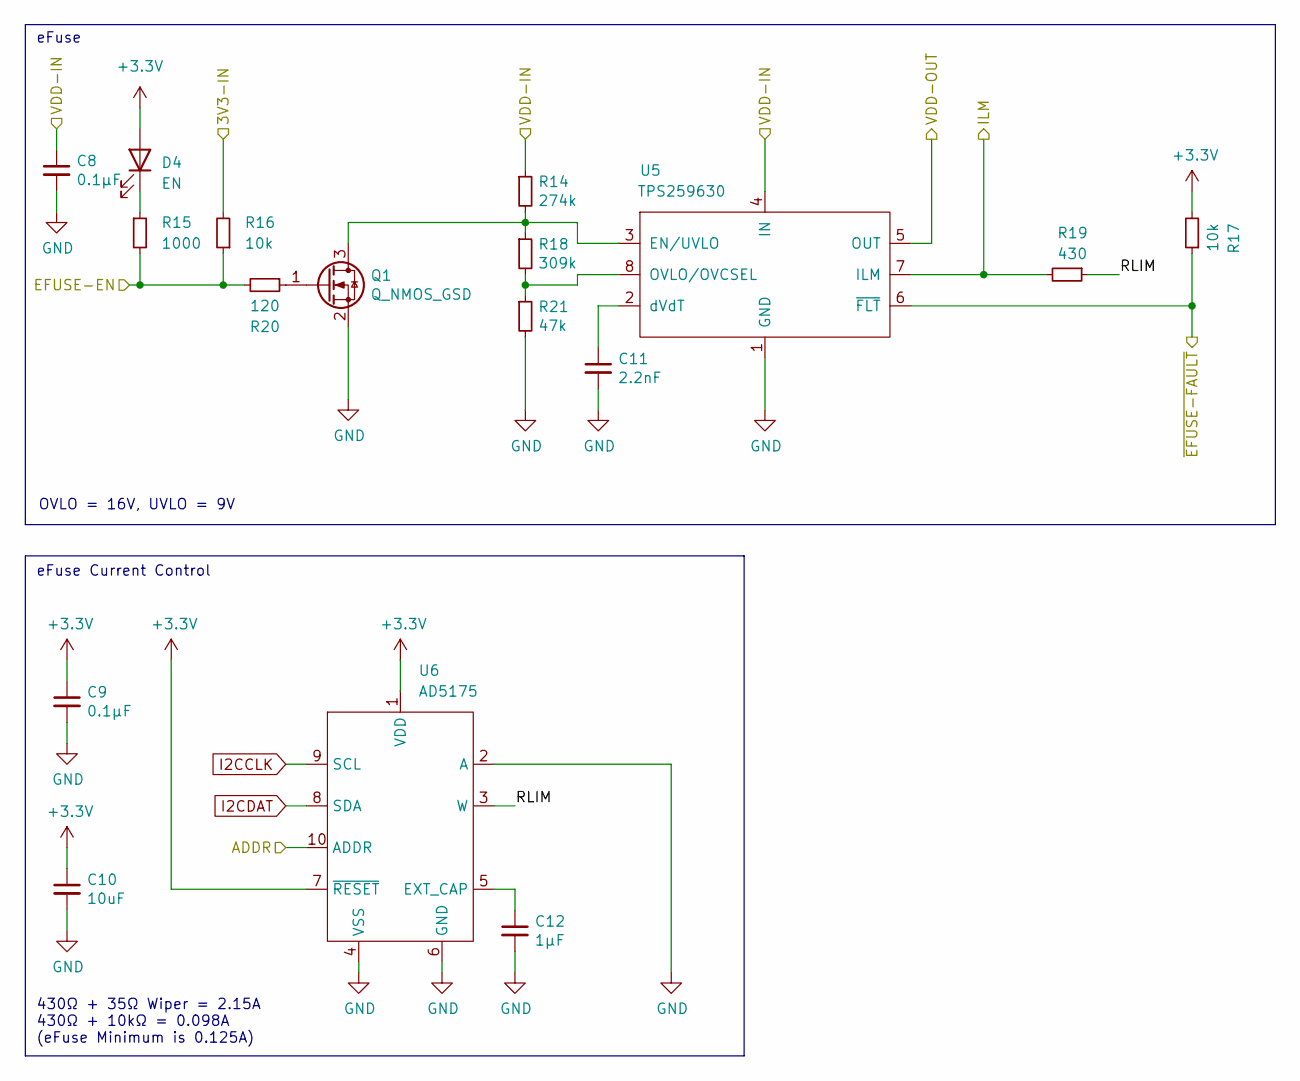
[picture p45: schematic dpcc.kicad_sch]

Parts:
C8, C9: 0.1μF; C_0603_1608Metric; DIGIKEY 1276-1005-1-ND
C10: 10uF; C_0603_1608Metric; DIGIKEY 1276-1948-1-ND
C11: 2.2nF; C_0603_1608Metric; DIGIKEY 1276-6530-1-ND
C12: 1μF; C_0603_1608Metric; DIGIKEY 1276-1946-1-ND
D4: EN; LED_0603_1608Metric; DIGIKEY 3147-B19Y1USD-20C000113U1930CT-ND
Q1: Q_NMOS_GSD; SOT-23; DIGIKEY 31-DMN2310U-7CT-ND
R14: 274k; R_0603_1608Metric; DIGIKEY P274KHCT-ND
R15: 1000; R_0603_1608Metric; DIGIKEY P1.00KHCT-ND
R16, R17: 10k; R_0603_1608Metric; DIGIKEY P10.0KHCT-ND
R18: 309k; R_0603_1608Metric; DIGIKEY P309KHCT-ND
R19: 430; R_0603_1608Metric; DIGIKEY P430HCT-ND
R20: 120; R_0603_1608Metric; DIGIKEY P120HCT-ND
R21: 47k; R_0603_1608Metric; DIGIKEY P47.0KHCT-ND
U5: TPS259630; SOIC-8-1EP_3.9x4.9mm_P1.27mm_EP2.29x3mm; DIGIKEY 296-TPS259631DDARCT-ND
U6: AD5175; MSOP-10_3x3mm_P0.5mm; DIGIKEY 505-AD5175BRMZ-10-ND

Connections:
+3.3V: C9.1, C10.1, D4.2 (A), R17.2, U6.1 (VDD), U6.7 (~RESET), U6.10 (ADDR); also elsewhere on the board
/3V3_REF: R16.2; also elsewhere on the board
/Front DPPC/RLIM: R19.1, U6.3 (W)
FRONT-EFUSE-EN: R15.2, R16.1, R20.2; also elsewhere on the board
FRONT-EFUSE-FLT: R17.1, U5.6 (~FLT); also elsewhere on the board
FRONT-ILM: R19.2, U5.7 (ILM); also elsewhere on the board
FRONT-VDD: U5.5 (OUT); also elsewhere on the board
GND: C8.2, C9.2, C10.2, C11.2, C12.2, Q1.2 (S), R21.2, U5.1 (GND), U5.9 (GND), U6.2 (A), U6.4 (VSS), U6.6 (GND); also elsewhere on the board
I2CCLK: U6.9 (SCL); also elsewhere on the board
I2CDAT: U6.8 (SDA); also elsewhere on the board
unnamed: D4.1 (K), R15.1
unnamed: Q1.3 (D), R14.2, R18.1, U5.3 (EN/UVLO)
unnamed: Q1.1 (G), R20.1
unnamed: R18.2, R21.1, U5.8 (OVLO/OVCSEL)
unnamed: C11.1, U5.2 (dVdT)
unnamed: C12.1, U6.5 (EXT_CAP)
VDD: C8.1, R14.1, U5.4 (IN); also elsewhere on the board

Parts of its further copies:
C13, C14: 0.1μF; C_0603_1608Metric; DIGIKEY 1276-1005-1-ND
C15: 10uF; C_0603_1608Metric; DIGIKEY 1276-1948-1-ND
C16: 2.2nF; C_0603_1608Metric; DIGIKEY 1276-6530-1-ND
C17: 1μF; C_0603_1608Metric; DIGIKEY 1276-1946-1-ND
D5: EN; LED_0603_1608Metric; DIGIKEY 3147-B19Y1USD-20C000113U1930CT-ND
Q2: Q_NMOS_GSD; SOT-23; DIGIKEY 31-DMN2310U-7CT-ND
R22: 274k; R_0603_1608Metric; DIGIKEY P274KHCT-ND
R23: 1000; R_0603_1608Metric; DIGIKEY P1.00KHCT-ND
R24, R25: 10k; R_0603_1608Metric; DIGIKEY P10.0KHCT-ND
R26: 309k; R_0603_1608Metric; DIGIKEY P309KHCT-ND
R27: 430; R_0603_1608Metric; DIGIKEY P430HCT-ND
R28: 120; R_0603_1608Metric; DIGIKEY P120HCT-ND
R29: 47k; R_0603_1608Metric; DIGIKEY P47.0KHCT-ND
U7: TPS259630; SOIC-8-1EP_3.9x4.9mm_P1.27mm_EP2.29x3mm; DIGIKEY 296-TPS259631DDARCT-ND
U8: AD5175; MSOP-10_3x3mm_P0.5mm; DIGIKEY 505-AD5175BRMZ-10-ND

Connections of its further copies:
+3.3V: C14.1, C15.1, D5.2 (A), R25.2, U8.1 (VDD), U8.7 (~RESET); also elsewhere on the board
/3V3_REF: R24.2; also elsewhere on the board
/Rear DPPC/RLIM: R27.1, U8.3 (W)
GND: C13.2, C14.2, C15.2, C16.2, C17.2, Q2.2 (S), R29.2, U7.1 (GND), U7.9 (GND), U8.2 (A), U8.4 (VSS), U8.6 (GND), U8.10 (ADDR); also elsewhere on the board
I2CCLK: U8.9 (SCL); also elsewhere on the board
I2CDAT: U8.8 (SDA); also elsewhere on the board
unnamed: D5.1 (K), R23.1
unnamed: Q2.3 (D), R22.2, R26.1, U7.3 (EN/UVLO)
unnamed: Q2.1 (G), R28.1
unnamed: R26.2, R29.1, U7.8 (OVLO/OVCSEL)
unnamed: C16.1, U7.2 (dVdT)
unnamed: C17.1, U8.5 (EXT_CAP)
REAR-EFUSE-EN: R23.2, R24.1, R28.2; also elsewhere on the board
REAR-EFUSE-FLT: R25.1, U7.6 (~FLT); also elsewhere on the board
REAR-ILM: R27.2, U7.7 (ILM); also elsewhere on the board
REAR-VDD: U7.5 (OUT); also elsewhere on the board
VDD: C13.1, R22.1, U7.4 (IN); also elsewhere on the board

Notes on the sheet:
eFuse
430Ω + 35Ω Wiper = 2.15A 430Ω + 10kΩ = 0.098A (eFuse Minimum is 0.125A)
OVLO = 16V, UVLO = 9V
eFuse Current Control

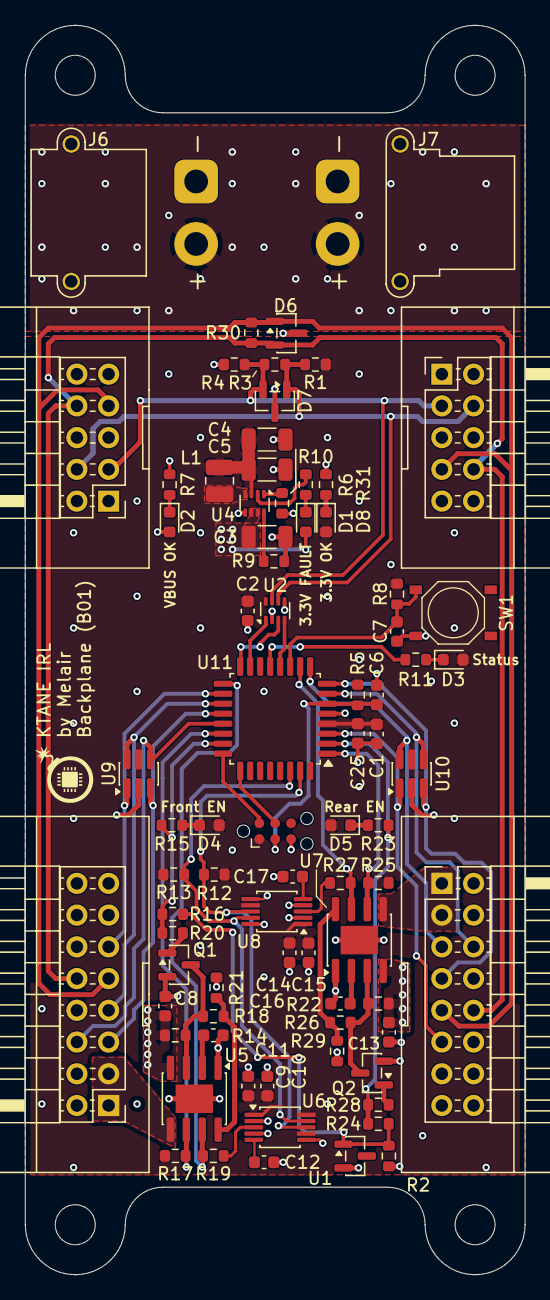
[picture p46: board Backplane.kicad_pcb from above]

Board: 4 copper layers, 40.0 x 100.0 mm, 82 parts (0 on the bottom side), 56 nets.
