melair/ktane/PCB/Modules/Audio/Audio.kicad_pcb

## KiCad design PCB/Modules/Audio/Audio.kicad_pcb (2026-06-27)

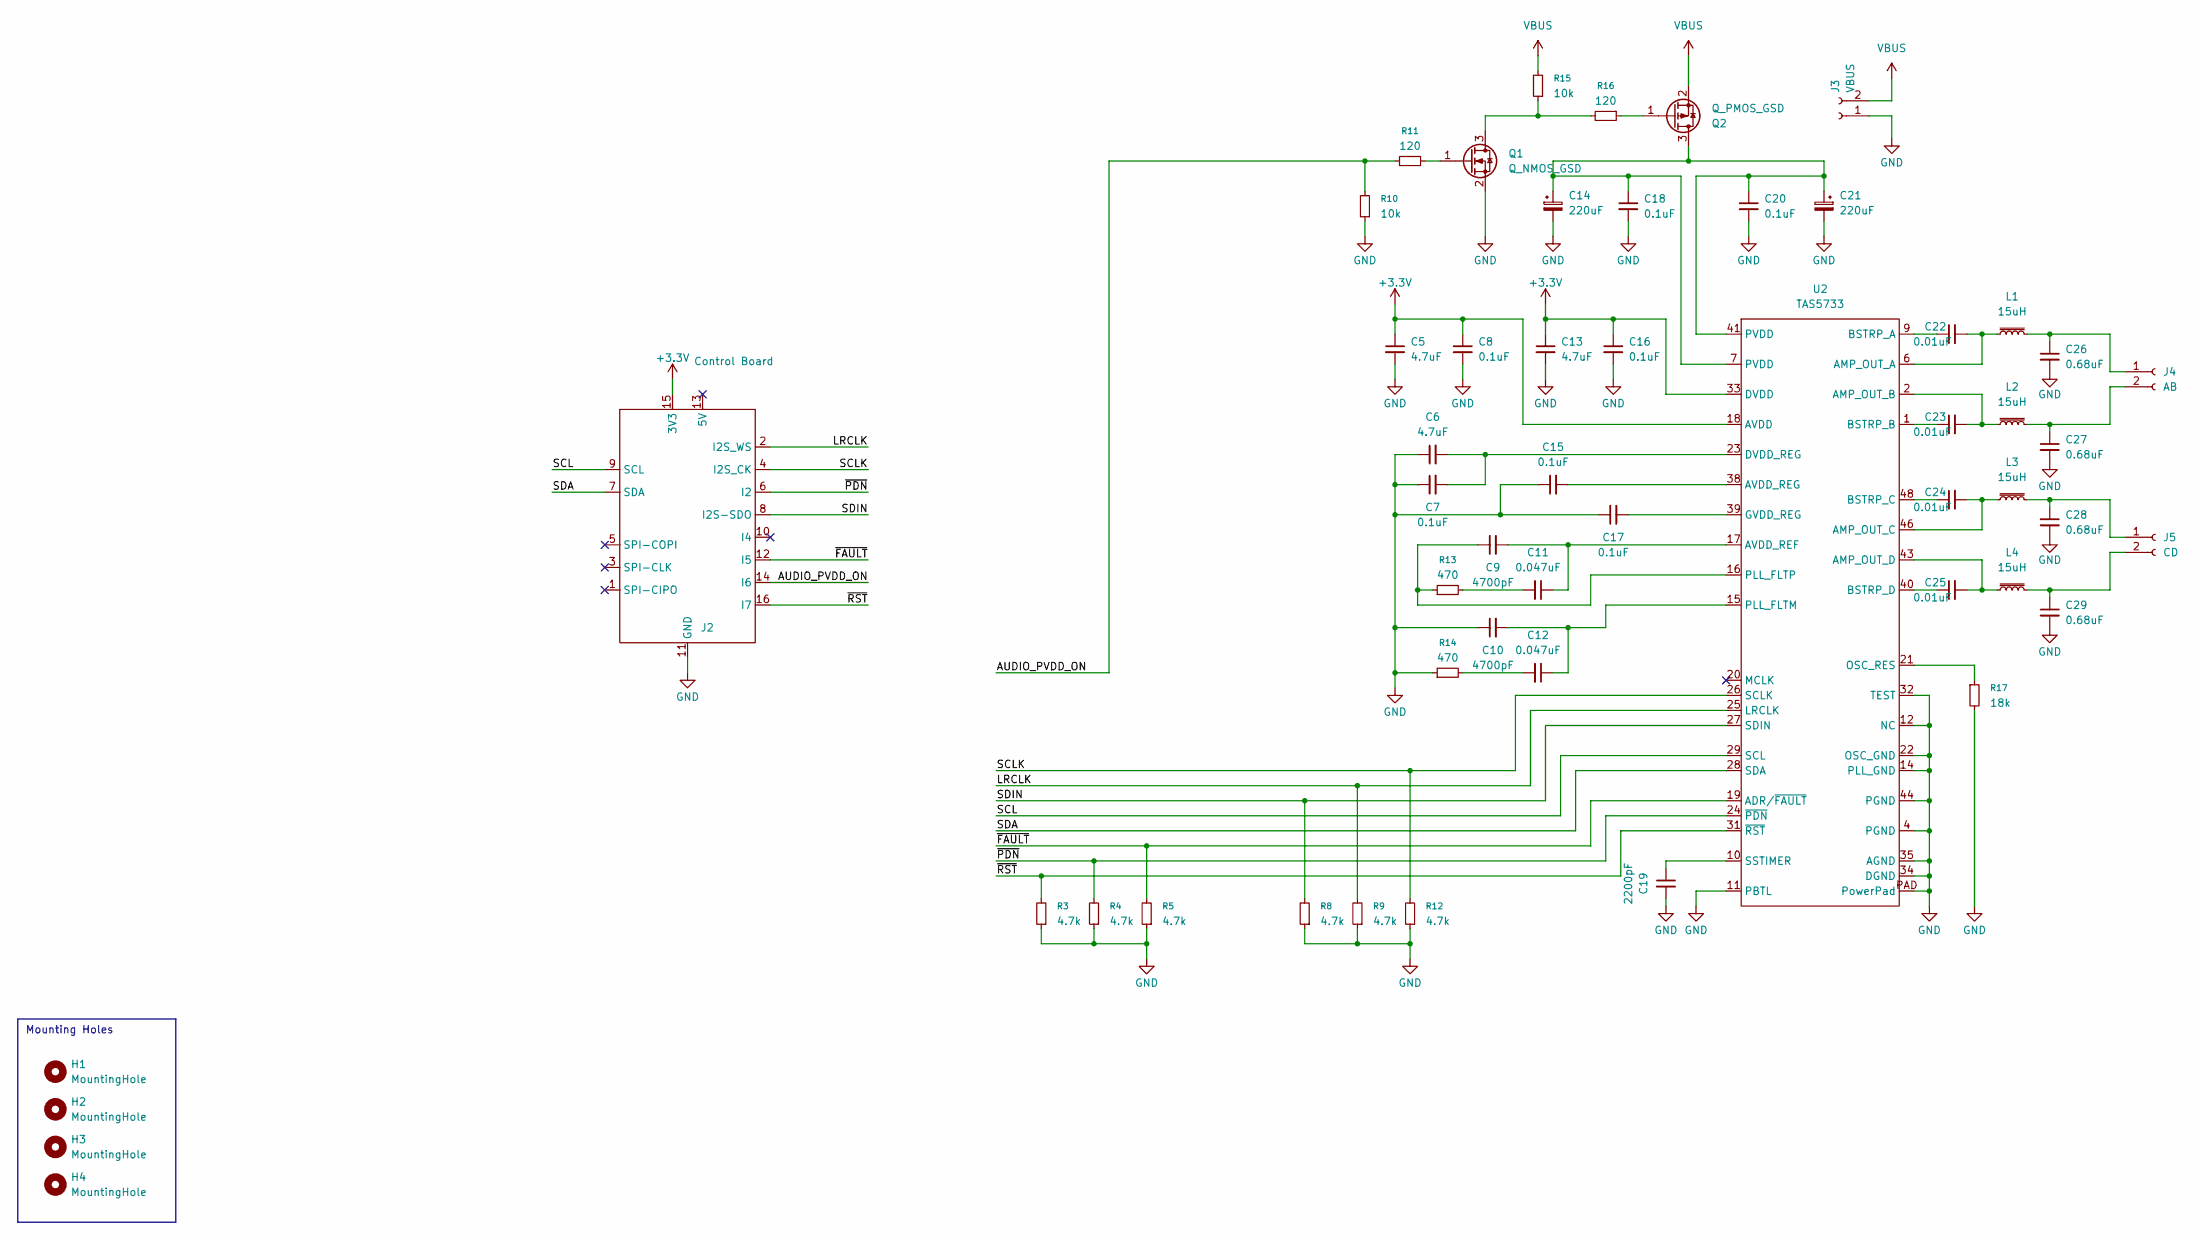
[picture p47: schematic Audio.kicad_sch, KTANE - Audio Board]

Parts:
C5, C6, C13: 4.7uF; C_0603_1608Metric; DIGIKEY 1276-2087-1-ND
C7, C8, C15, C16, C17: 0.1uF; C_0603_1608Metric; DIGIKEY 1276-1005-1-ND
C9, C10: 4700pF; C_0603_1608Metric; DIGIKEY 1276-1098-1-ND
C11, C12: 0.047uF; C_0603_1608Metric; DIGIKEY 1276-2079-1-ND
C14, C21: 220uF; CP_Elec_8x6.9; DIGIKEY PCE3839CT-ND
C18, C20: 0.1uF; C_0603_1608Metric; DIGIKEY 1276-CL10B104KB8NNNLCT-ND
C19: 2200pF; C_0603_1608Metric; DIGIKEY 1276-6530-1-ND
C22, C25: 0.01uF; C_0805_2012Metric; DIGIKEY 1276-1078-1-ND
C23, C24: 0.01uF; C_0603_1608Metric; DIGIKEY 1276-1009-1-ND
C26, C27, C28, C29: 0.68uF; C_0805_2012Metric; DIGIKEY 1276-7009-1-ND
H1, H2, H3, H4: MountingHole; MountingHole_3.2mm_M3_NoCopper; DIGIKEY NONE
J2: Control Board; PinHeader_2x08_P2.54mm_Vertical-Centered; DIGIKEY ALIEXPRESS/STOCK
J3: VBUS; AMASS_XT30PW-M_1x02_P2.50mm_Horizontal; DIGIKEY ALIEXPRESS/STOCK
J4: AB; JST_PH_B2B-PH-SM4-TB_1x02-1MP_P2.00mm_Vertical; DIGIKEY 455-B2B-PH-SM4-TBCT-ND
J5: CD; JST_PH_B2B-PH-SM4-TB_1x02-1MP_P2.00mm_Vertical; DIGIKEY 455-B2B-PH-SM4-TBCT-ND
L1, L2, L3, L4: 15uH; L_APV_ANR8040; DIGIKEY 553-BWVS00808040150M00CT-ND
Q1: Q_NMOS_GSD; SOT-23-3; DIGIKEY 31-DMN2310U-7CT-ND
Q2: Q_PMOS_GSD; SOT-23; DIGIKEY 4518-SI2307ACT-ND
R3, R4, R5, R8, R9, R12: 4.7k; R_0603_1608Metric; DIGIKEY P4.70KHCT-ND
R10, R15: 10k; R_0603_1608Metric; DIGIKEY P10.0KHCT-ND
R11, R16: 120; R_0603_1608Metric; DIGIKEY P120HCT-ND
R13, R14: 470; R_0603_1608Metric; DIGIKEY P470HCT-ND
R17: 18k; R_0603_1608Metric; DIGIKEY P18.0KHCT-ND
U2: TAS5733; HTSSOP-48_6.1x12.5mm_P0.5mm_EP_3.6x6.4; MOUSER 595-TAS5733LDCAR

Connections:
+3.3V: C5.1, C8.1, C13.1, C16.1, J2.15 (3V3), U2.18 (AVDD), U2.33 (DVDD)
/AUDIO_PVDD_ON: J2.14 (I6), R10.2, R11.2
/LRCLK: J2.2 (I2S_WS), R9.2, U2.25 (LRCLK)
/SCL: J2.9 (SCL), U2.29 (SCL)
/SCLK: J2.4 (I2S_CK), R12.2, U2.26 (SCLK)
/SDA: J2.7 (SDA), U2.28 (SDA)
/SDIN: J2.8 (I2S-SDO), R8.2, U2.27 (SDIN)
/~FAULT: J2.12 (I5), R5.2, U2.19 (ADR/~FAULT)
/~PDN: J2.6 (I2), R4.2, U2.24 (~PDN)
/~RST: J2.16 (I7), R3.2, U2.31 (~RST)
GND: C5.2, C6.1, C7.1, C8.2, C10.1, C13.2, C14.2, C15.1, C16.2, C17.1, C18.2, C19.2, C20.2, C21.2, C26.2, C27.2, C28.2, C29.2, J2.11 (GND), J3.1, Q1.2 (S), R3.1, R4.1, R5.1, R8.1, R9.1, R10.1, R12.1, R14.1, R17.2, U2.4 (PGND), U2.5 (PGND), U2.11 (PBTL), U2.12 (NC), U2.13 (NC), U2.14 (PLL_GND), U2.22 (OSC_GND), U2.30 (NC), U2.32 (TEST), U2.34 (DGND), U2.35 (AGND), U2.36 (NC), U2.37 (NC), U2.44 (PGND), U2.45 (PGND), U2.PAD (PowerPad)
unnamed: C11.2, R13.2
unnamed: C12.2, R14.2
unnamed: C23.2, L2.2, U2.2 (AMP_OUT_B), U2.3 (AMP_OUT_B)
unnamed: C24.2, L3.2, U2.46 (AMP_OUT_C), U2.47 (AMP_OUT_C)
unnamed: C26.1, J4.1, L1.1
unnamed: C27.1, J4.2, L2.1
unnamed: C28.1, J5.1, L3.1
unnamed: C29.1, J5.2, L4.1
unnamed: Q1.3 (D), R15.1, R16.2
unnamed: Q1.1 (G), R11.1
unnamed: Q2.1 (G), R16.1
unnamed: C22.2, L1.2, U2.6 (AMP_OUT_A)
unnamed: C25.2, L4.2, U2.43 (AMP_OUT_D)
unnamed: C9.2, C11.1, U2.17 (AVDD_REF)
unnamed: C15.2, U2.38 (AVDD_REG)
unnamed: C22.1, U2.9 (BSTRP_A)
unnamed: C23.1, U2.1 (BSTRP_B)
unnamed: C24.1, U2.48 (BSTRP_C)
unnamed: C25.1, U2.40 (BSTRP_D)
unnamed: C6.2, C7.2, U2.23 (DVDD_REG)
unnamed: C17.2, U2.39 (GVDD_REG)
unnamed: R17.1, U2.21 (OSC_RES)
unnamed: C10.2, C12.1, U2.15 (PLL_FLTM)
unnamed: C9.1, R13.1, U2.16 (PLL_FLTP)
unnamed: C19.1, U2.10 (SSTIMER)
PVDD: C14.1, C18.1, C20.1, C21.1, Q2.3 (D), U2.7 (PVDD), U2.8 (PVDD), U2.41 (PVDD), U2.42 (PVDD)
VBUS: J3.2, Q2.2 (S), R15.2

Notes on the sheet:
Mounting Holes

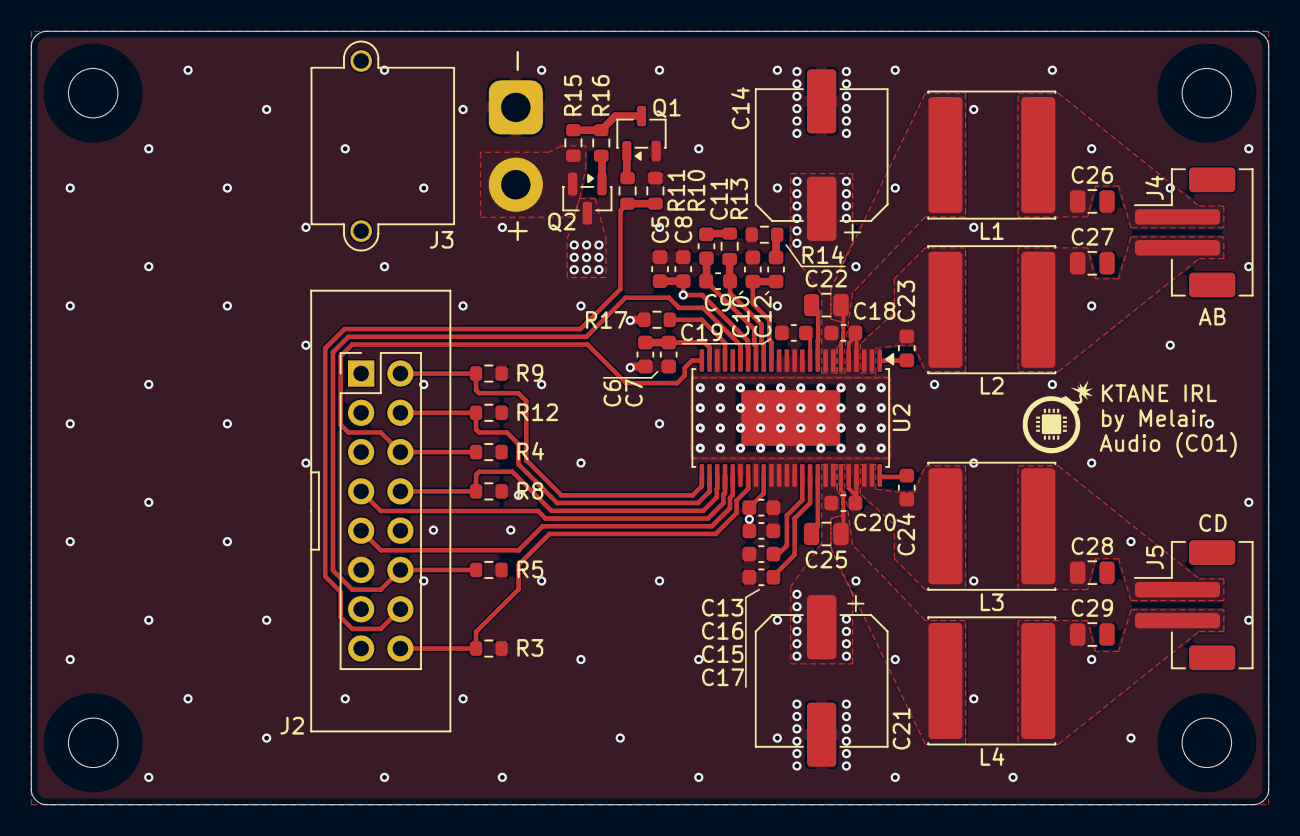
[picture p48: board Audio.kicad_pcb from above]

Board: 4 copper layers, 80.0 x 50.0 mm, 53 parts (0 on the bottom side), 38 nets.
