melair/ktane/PCB/ControlBoard/ControlBoard.kicad_pcb

## KiCad design PCB/ControlBoard/ControlBoard.kicad_pcb (2026-06-27)

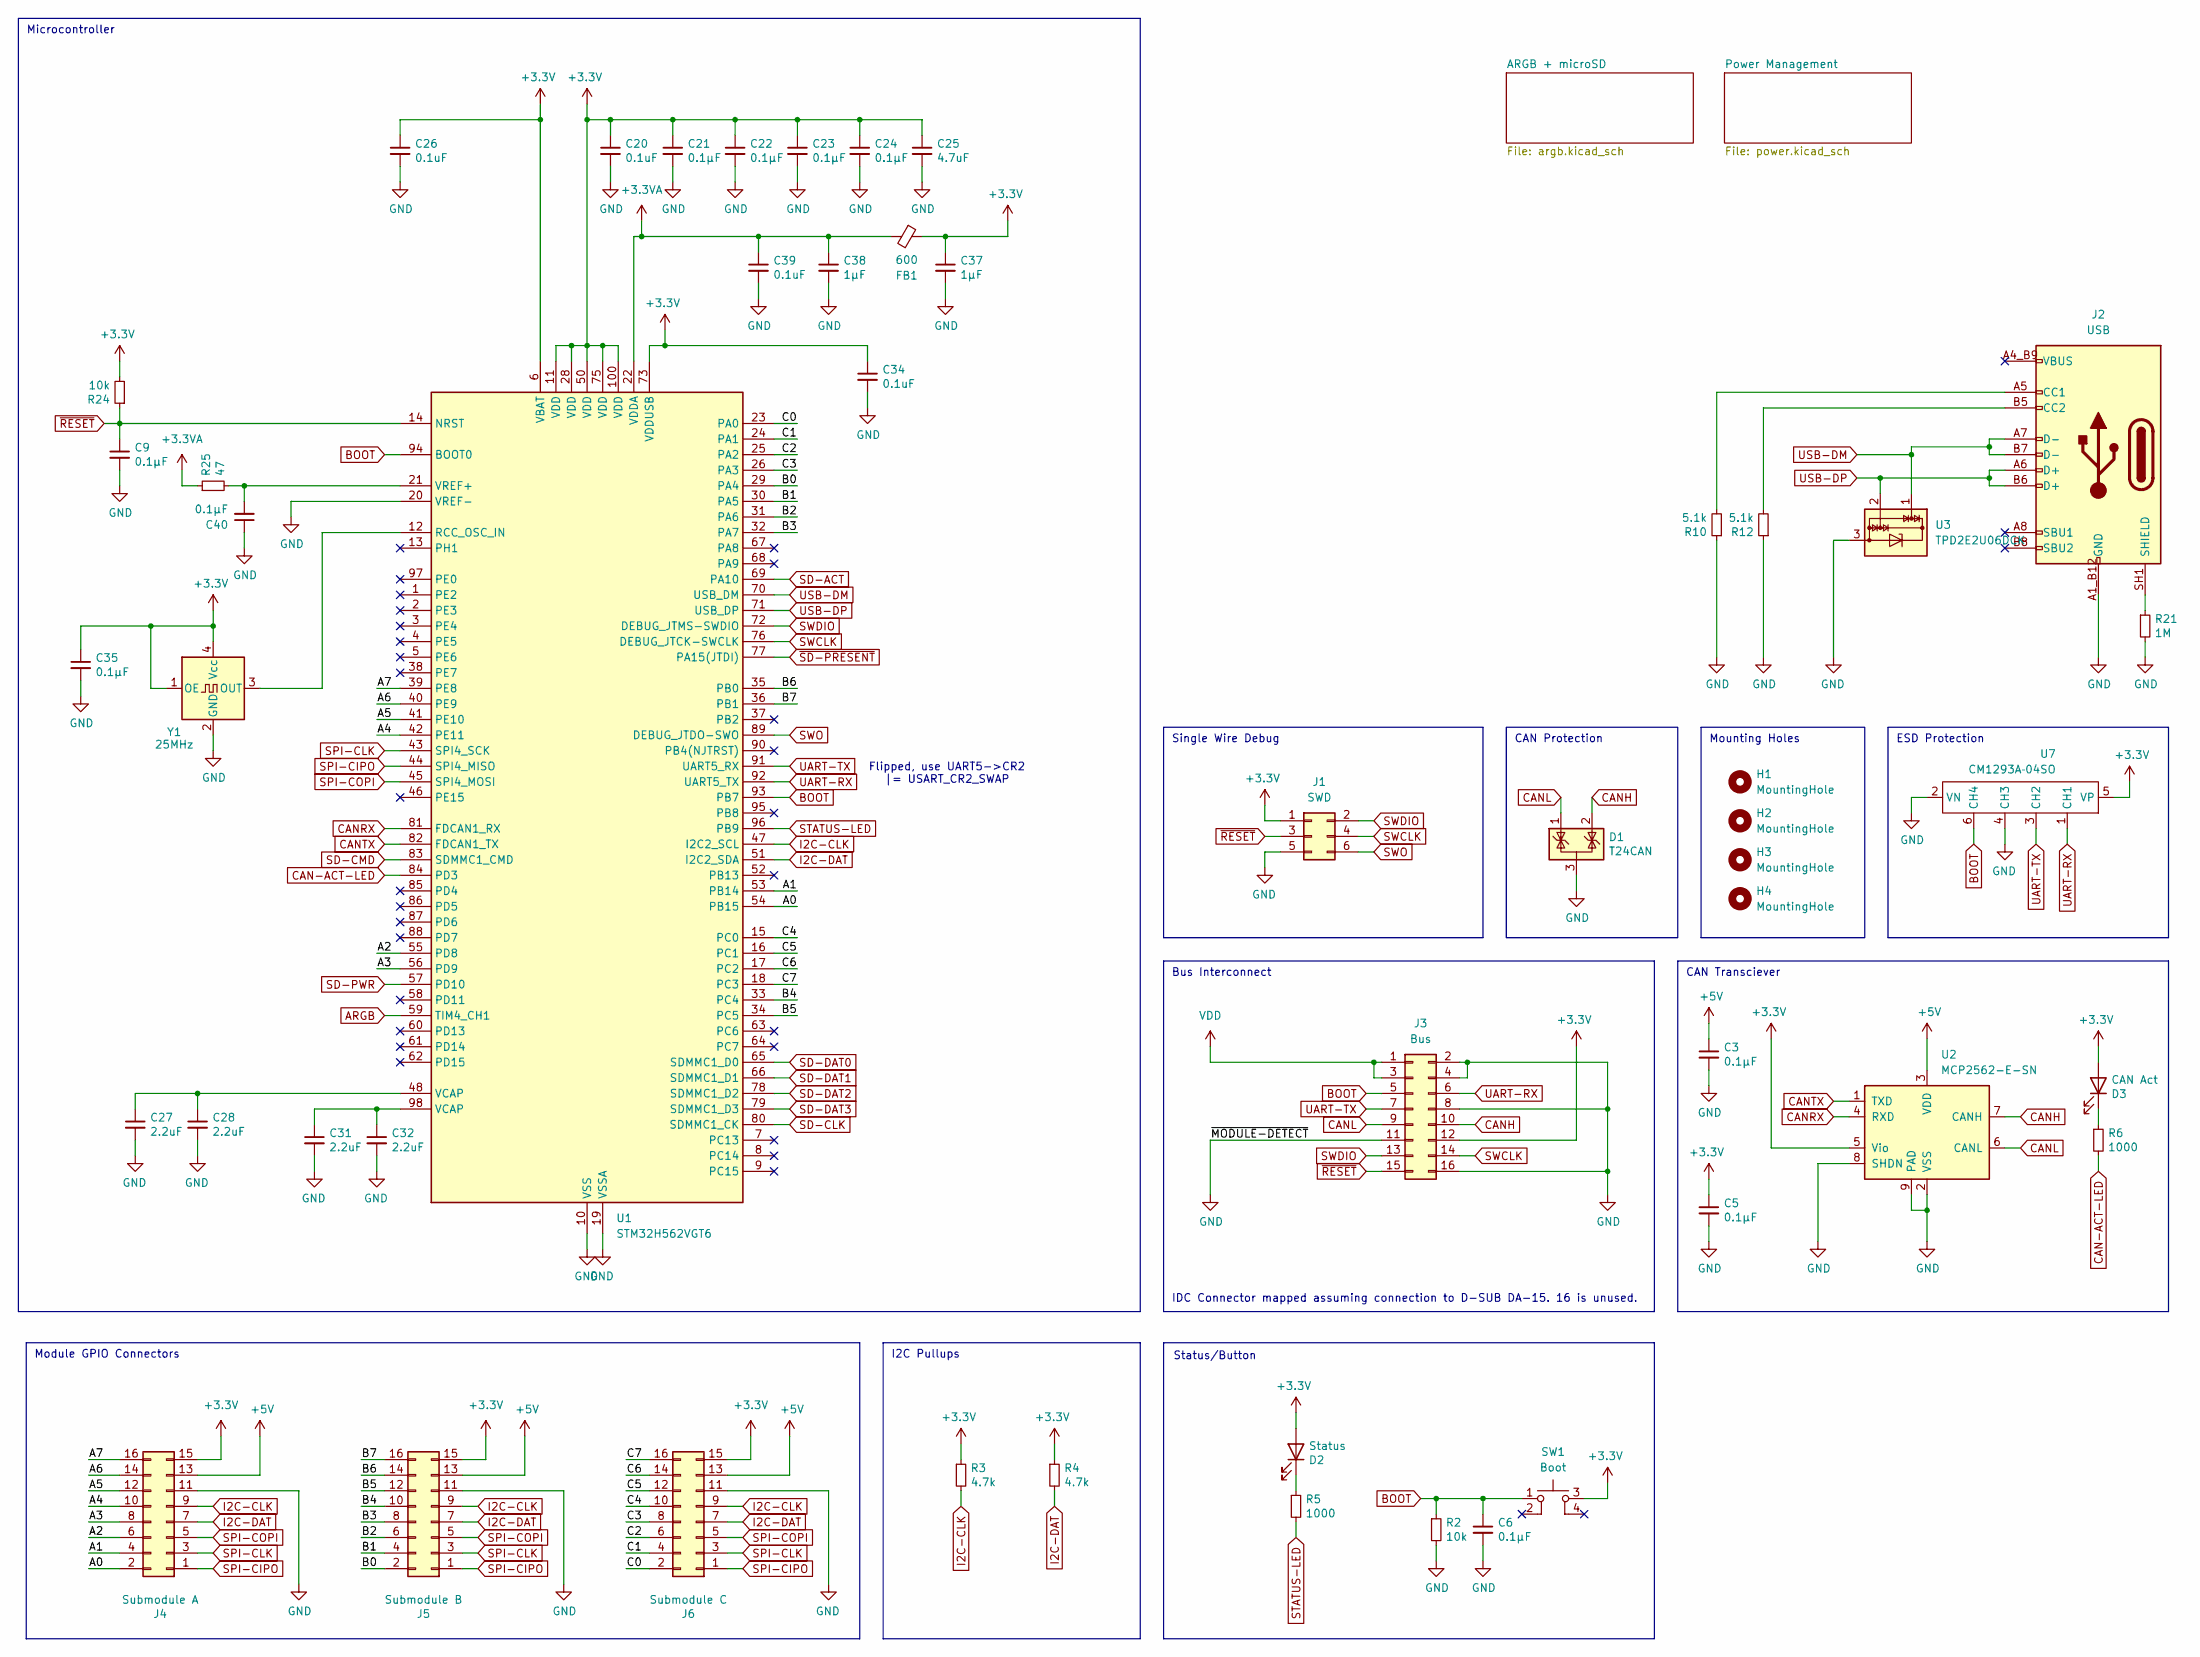
[picture p49: schematic ControlBoard.kicad_sch, KTANE Physical Edition - Control Board]

Parts:
C3, C5, C6, C9, C21, C22, C23, C24, C35, C40: 0.1μF; C_0603_1608Metric; DIGIKEY 1276-1005-1-ND
C20, C26, C34, C39: 0.1uF; C_0603_1608Metric; DIGIKEY 1276-1005-1-ND
C25: 4.7uF; C_0603_1608Metric; DIGIKEY 1276-2087-1-ND
C27, C28, C31, C32: 2.2uF; C_0603_1608Metric; DIGIKEY 1276-2018-1-ND
C37, C38: 1μF; C_0603_1608Metric; DIGIKEY 1276-1024-1-ND
D1: T24CAN; SOT-23; DIGIKEY CDSOT23-T24CANCT-ND
D2: Status; LED_0603_1608Metric; DIGIKEY 3147-B19Y1UYG-20C000313U1930CT-ND
D3: CAN Act; LED_0603_1608Metric; DIGIKEY 3147-B19Y1UYG-20C000313U1930CT-ND
FB1: 600; L_0603_1608Metric; DIGIKEY 490-1014-1-ND
H1, H2, H3, H4: MountingHole; MountingHole_3.2mm_M3_NoCopper
J1: SWD; Tag-Connect_TC2030-IDC-NL_2x03_P1.27mm_Vertical
J2: USB; SAMESKY_UJ20-C-H-G-SMT-1A-P16-TR; DIGIKEY 2223-UJ20-C-H-G-SMT-1A-P16-TRCT-ND
J3: Bus; PinHeader_2x08_P2.54mm_VerticalAndHorizontal_Centered; DIGIKEY STOCK/HEADER
J4: Submodule A; PinHeader_2x08_P2.54mm_Vertical-Centered; DIGIKEY S9171-ND
J5: Submodule B; PinHeader_2x08_P2.54mm_Vertical-Centered; DIGIKEY S9171-ND
J6: Submodule C; PinHeader_2x08_P2.54mm_Vertical-Centered; DIGIKEY S9171-ND
R2, R24: 10k; R_0603_1608Metric; DIGIKEY P10.0KHCT-ND
R3, R4: 4.7k; R_0603_1608Metric; DIGIKEY P4.70KHCT-ND
R5, R6: 1000; R_0603_1608Metric; DIGIKEY P1.00KHCT-ND
R10, R12: 5.1k; R_0603_1608Metric; DIGIKEY P5.10KHCT-ND
R21: 1M; R_0603_1608Metric; DIGIKEY P1.00MHCT-ND
R25: 47; R_0603_1608Metric; DIGIKEY 541-47.0HCT-ND
SW1: Boot; PTS526Sx15SMTR2xLFS; DIGIKEY CKN12220-1-ND
U1: STM32H562VGT6; LQFP-100_14x14mm_P0.5mm; DIGIKEY 497-STM32H562VGT6-ND
U2: MCP2562-E-SN; DFN-8-1EP_3x3mm_P0.65mm_EP1.55x2.4mm; DIGIKEY MCP2562T-E/MFCT-ND
U3: TPD2E2U06DCK; SOT-323_SC-70; DIGIKEY TPD2E2U06DCKR
U7: CM1293A‐04SO; SC-74-6_1.55x2.9mm_P0.95mm; DIGIKEY CM1293A-04SOOSCT-ND
Y1: 25MHz; Oscillator_SMD-Vishay_X022C_2.5mmx2.0mm; DIGIKEY 541-XO22C3EREHX25M000CT-ND

Connections:
+3.3V: C5.1, C20.1, C21.1, C22.1, C23.1, C24.1, C25.1, C26.1, C34.1, C35.1, C37.1, D2.2 (A), D3.2 (A), FB1.1, J1.1, J3.12, J4.15, J5.15, J6.15, R3.1, R4.1, R24.2, SW1.3, U1.6 (VBAT), U1.11 (VDD), U1.28 (VDD), U1.50 (VDD), U1.73 (VDDUSB), U1.75 (VDD), U1.100 (VDD), U2.5 (Vio), U7.5 (VP), Y1.1 (OE), Y1.4 (Vcc); also elsewhere on the board
+3.3VA: C38.1, C39.1, FB1.2, R25.1, U1.22 (VDDA)
+5V: C3.1, J4.13, J5.13, J6.13, U2.3 (VDD); also elsewhere on the board
/A0: J4.2, U1.54 (PB15)
/A1: J4.4, U1.53 (PB14)
/A2: J4.6, U1.55 (PD8)
/A3: J4.8, U1.56 (PD9)
/A4: J4.10, U1.42 (PE11)
/A5: J4.12, U1.41 (PE10)
/A6: J4.14, U1.40 (PE9)
/A7: J4.16, U1.39 (PE8)
/B0: J5.2, U1.29 (PA4)
/B1: J5.4, U1.30 (PA5)
/B2: J5.6, U1.31 (PA6)
/B3: J5.8, U1.32 (PA7)
/B4: J5.10, U1.33 (PC4)
/B5: J5.12, U1.34 (PC5)
/B6: J5.14, U1.35 (PB0)
/B7: J5.16, U1.36 (PB1)
/C0: J6.2, U1.23 (PA0)
/C1: J6.4, U1.24 (PA1)
/C2: J6.6, U1.25 (PA2)
/C3: J6.8, U1.26 (PA3)
/C4: J6.10, U1.15 (PC0)
/C5: J6.12, U1.16 (PC1)
/C6: J6.14, U1.17 (PC2)
/C7: J6.16, U1.18 (PC3)
ARGB: U1.59 (TIM4_CH1); also elsewhere on the board
BOOT: C6.1, J3.5, R2.1, SW1.1, U1.93 (PB7), U1.94 (BOOT0), U7.6 (CH4)
CAN-ACT-LED: R6.2, U1.84 (PD3)
CANH: D1.2 (K), J3.10, U2.7 (CANH)
CANL: D1.1 (K), J3.9, U2.6 (CANL)
CANRX: U1.81 (FDCAN1_RX), U2.4 (RXD)
CANTX: U1.82 (FDCAN1_TX), U2.1 (TXD)
GND: C3.2, C5.2, C6.2, C9.2, C20.2, C21.2, C22.2, C23.2, C24.2, C25.2, C26.2, C27.2, C28.2, C31.2, C32.2, C34.2, C35.2, C37.2, C38.2, C39.2, C40.1, D1.3 (A), J1.5, J2.A1_B12 (GND), J2.B1_A12 (GND), J3.2, J3.4, J3.8, J3.11, J3.16, J4.11, J5.11, J6.11, R2.2, R10.1, R12.1, R21.2, U1.10 (VSS), U1.19 (VSSA), U1.20 (VREF-), U1.27 (VSS), U1.49 (VSS), U1.74 (VSS), U1.99 (VSS), U2.2 (VSS), U2.8 (SHDN), U2.9 (PAD), U3.3, U7.2 (VN), U7.4 (CH3), Y1.2 (GND); also elsewhere on the board
I2C-CLK: J4.9, J5.9, J6.9, R3.2, U1.47 (I2C2_SCL)
I2C-DAT: J4.7, J5.7, J6.7, R4.2, U1.51 (I2C2_SDA)
unnamed: C27.1, C28.1, U1.48 (VCAP)
unnamed: C31.1, C32.1, U1.98 (VCAP)
unnamed: D2.1 (K), R5.1
unnamed: D3.1 (K), R6.1
unnamed: J2.A5 (CC1), R10.2
unnamed: J2.B5 (CC2), R12.2
unnamed: U1.12 (RCC_OSC_IN), Y1.3 (OUT)
unnamed: C40.2, R25.2, U1.21 (VREF+)
SD-ACT: U1.69 (PA10); also elsewhere on the board
SD-CLK: U1.80 (SDMMC1_CK); also elsewhere on the board
SD-CMD: U1.83 (SDMMC1_CMD); also elsewhere on the board
SD-DAT0: U1.65 (SDMMC1_D0); also elsewhere on the board
SD-DAT1: U1.66 (SDMMC1_D1); also elsewhere on the board
SD-DAT2: U1.78 (SDMMC1_D2); also elsewhere on the board
SD-DAT3: U1.79 (SDMMC1_D3); also elsewhere on the board
SD-PWR: U1.57 (PD10); also elsewhere on the board
SPI-CIPO: J4.1, J5.1, J6.1, U1.44 (SPI4_MISO)
SPI-CLK: J4.3, J5.3, J6.3, U1.43 (SPI4_SCK)
SPI-COPI: J4.5, J5.5, J6.5, U1.45 (SPI4_MOSI)
STATUS-LED: R5.2, U1.96 (PB9)
SWCLK: J1.4, J3.14, U1.76 (DEBUG_JTCK-SWCLK)
SWDIO: J1.2, J3.13, U1.72 (DEBUG_JTMS-SWDIO)
SWO: J1.6, U1.89 (DEBUG_JTDO-SWO)
UART-RX: J3.6, U1.92 (UART5_TX), U7.1 (CH1)
UART-TX: J3.7, U1.91 (UART5_RX), U7.3 (CH2)
USB-DM: J2.A7 (D-), J2.B7 (D-), U1.70 (USB_DM), U3.1
USB-DP: J2.A6 (D+), J2.B6 (D+), U1.71 (USB_DP), U3.2
VDD: J3.1, J3.3; also elsewhere on the board
~RESET: C9.1, J1.3, J3.15, R24.1, U1.14 (NRST)
~SD-PRESENT: U1.77 (PA15(JTDI)); also elsewhere on the board

Notes on the sheet:
Status/Button
Bus Interconnect
Single Wire Debug
Module GPIO Connectors
Microcontroller
CAN Protection
Flipped, use UART5->CR2 |= USART_CR2_SWAP
IDC Connector mapped assuming connection to D-SUB DA-15. 16 is unused.
Mounting Holes
ESD Protection
CAN Transciever
I2C Pullups

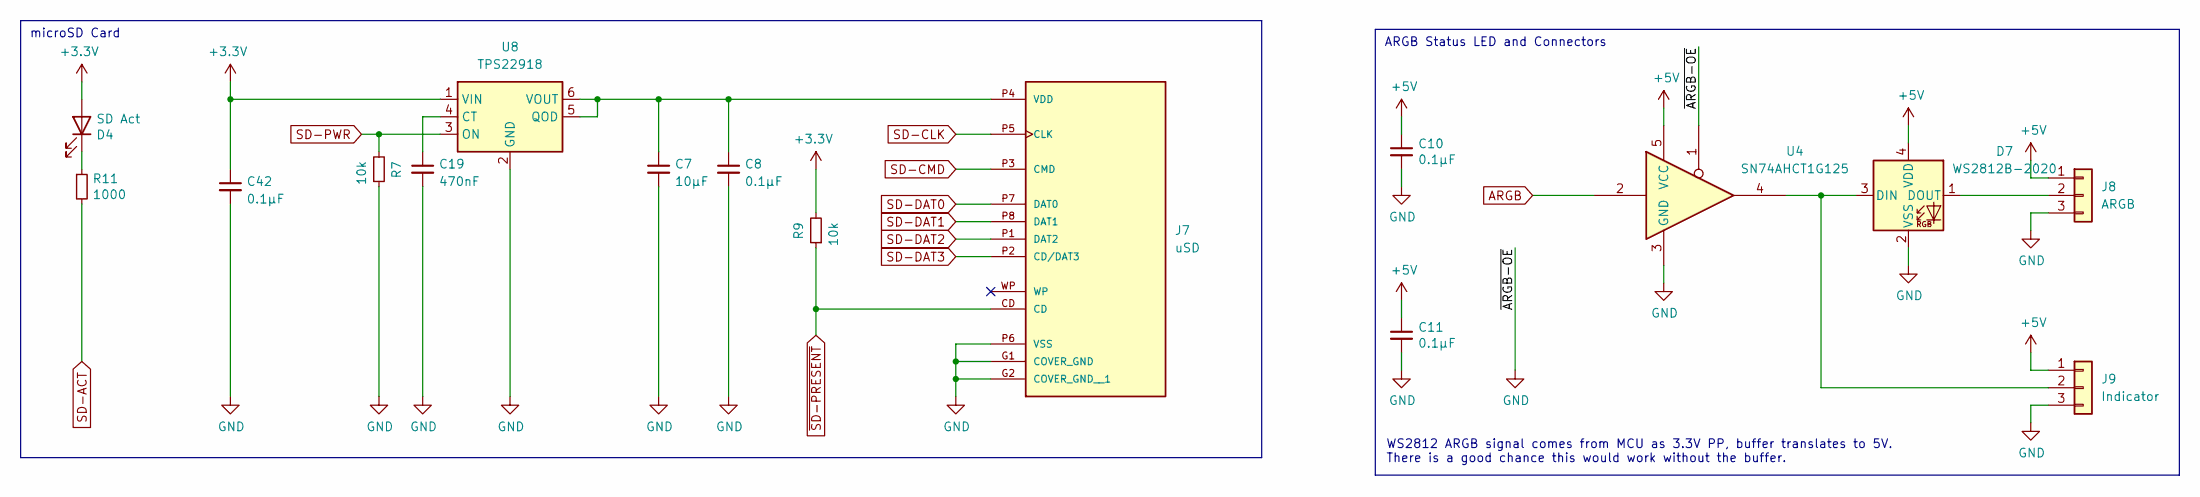
[picture p50: schematic argb.kicad_sch]

Parts:
C7: 10μF; C_0603_1608Metric; DIGIKEY 1276-1948-1-ND
C8, C10, C11, C42: 0.1μF; C_0603_1608Metric; DIGIKEY 1276-1005-1-ND
C19: 470nF; C_0603_1608Metric; DIGIKEY 1276-1094-1-ND
D4: SD Act; LED_0603_1608Metric; DIGIKEY 3147-B19Y1UYG-20C000313U1930CT-ND
D7: WS2812B-2020; LED_WS2812B-2020_PLCC4_2.0x2.0mm; DIGIKEY STOCK/ALIEXPRESS
J7: uSD; CUI_MSD-11-A; PARTREV 1.02; DIGIKEY 2223-MSD-11-ACT-ND
J8: ARGB; JST_PH_B3B-PH-SM4-TB_1x03-1MP_P2.00mm_Vertical; DIGIKEY 455-B3B-PH-SM4-TBCT-ND
J9: Indicator; JST_PH_B3B-PH-SM4-TB_1x03-1MP_P2.00mm_Vertical; DIGIKEY 455-B3B-PH-SM4-TBCT-ND
R7, R9: 10k; R_0603_1608Metric; DIGIKEY P10.0KHCT-ND
R11: 1000; R_0603_1608Metric; DIGIKEY P1.00KHCT-ND
U4: SN74AHCT1G125; SOT-23-5; DIGIKEY 296-4708-1-ND
U8: TPS22918; SOT-23-6; DIGIKEY 296-44632-1-ND

Connections:
+3.3V: C42.1, D4.2 (A), R9.2, U8.1 (VIN); also elsewhere on the board
+5V: C10.1, C11.1, D7.4 (VDD), J8.1, J9.1, U4.5 (VCC); also elsewhere on the board
ARGB: U4.2; also elsewhere on the board
GND: C7.2, C8.2, C10.2, C11.2, C19.2, C42.2, D7.2 (VSS), J7.G1 (COVER_GND), J7.G2 (COVER_GND__1), J7.P6 (VSS), J8.3, J9.3, R7.1, U4.1, U4.3 (GND), U8.2 (GND); also elsewhere on the board
unnamed: D4.1 (K), R11.1
unnamed: D7.3 (DIN), J9.2, U4.4
unnamed: D7.1 (DOUT), J8.2
unnamed: C7.1, C8.1, J7.P4 (VDD), U8.5 (QOD), U8.6 (VOUT)
unnamed: C19.1, U8.4 (CT)
SD-ACT: R11.2; also elsewhere on the board
SD-CLK: J7.P5 (CLK); also elsewhere on the board
SD-CMD: J7.P3 (CMD); also elsewhere on the board
SD-DAT0: J7.P7 (DAT0); also elsewhere on the board
SD-DAT1: J7.P8 (DAT1); also elsewhere on the board
SD-DAT2: J7.P1 (DAT2); also elsewhere on the board
SD-DAT3: J7.P2 (CD/DAT3); also elsewhere on the board
SD-PWR: R7.2, U8.3 (ON); also elsewhere on the board
~SD-PRESENT: J7.CD, R9.1; also elsewhere on the board

Notes on the sheet:
microSD Card
WS2812 ARGB signal comes from MCU as 3.3V PP, buffer translates to 5V. There is a good chance this would work without the buffer.
ARGB Status LED and Connectors

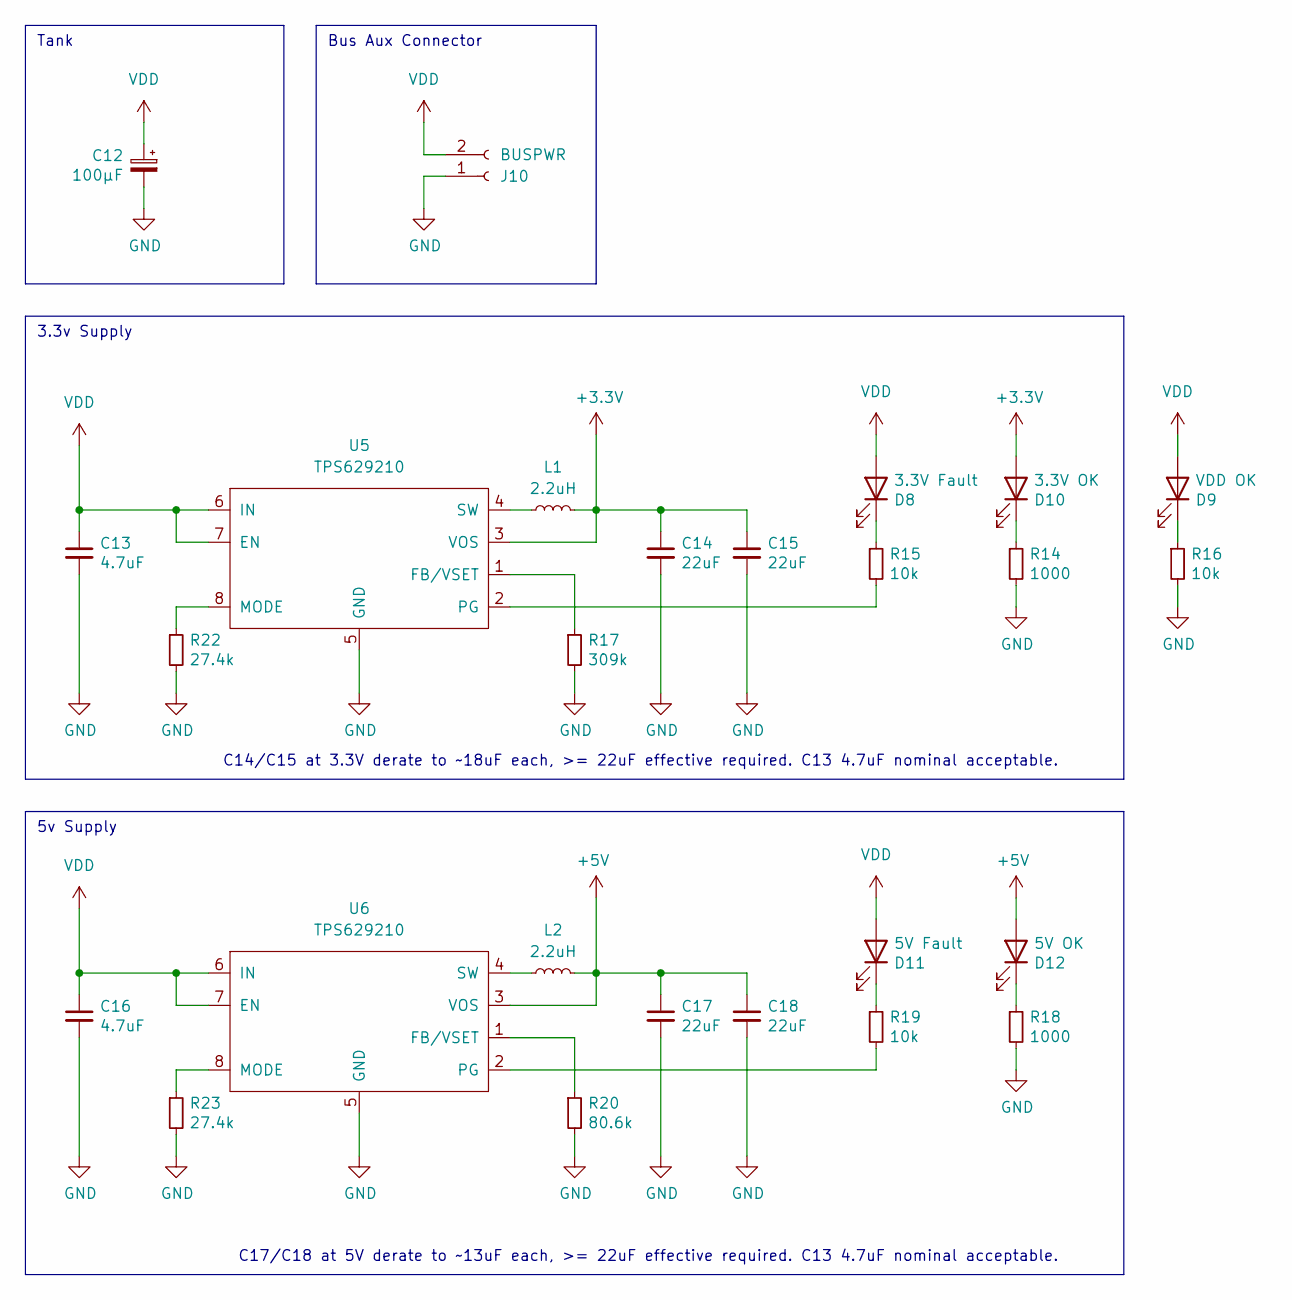
[picture p51: schematic power.kicad_sch]

Parts:
C12: 100μF; C_Elec_6.3x7.7; DIGIKEY 399-A768EB107M1ELAE036CT-ND
C13, C16: 4.7uF; C_1206_3216Metric; DIGIKEY 445-1606-1-ND
C14, C15, C17, C18: 22uF; C_1206_3216Metric; DIGIKEY 1276-3148-1-ND
D8: 3.3V Fault; LED_0603_1608Metric; DIGIKEY 3147-B19Y1USD-20C000113U1930CT-ND
D9: VDD OK; LED_0603_1608Metric; DIGIKEY 3147-B19Y1USD-20C000113U1930CT-ND
D10: 3.3V OK; LED_0603_1608Metric; DIGIKEY 3147-B19Y1UYG-20C000313U1930CT-ND
D11: 5V Fault; LED_0603_1608Metric; DIGIKEY 3147-B19Y1USD-20C000113U1930CT-ND
D12: 5V OK; LED_0603_1608Metric; DIGIKEY 3147-B19Y1UYG-20C000313U1930CT-ND
J10: BUSPWR; AMASS_XT30PW-F_1x02_P2.50mm_Horizontal; DIGIKEY STOCK/AMASS
L1, L2: 2.2uH; L_1008_2520Metric; DIGIKEY 490-DFE252012PD-2R2M=P2CT-ND
R14, R18: 1000; R_0603_1608Metric; DIGIKEY P1.00KHCT-ND
R15, R16, R19: 10k; R_0603_1608Metric; DIGIKEY P10.0KHCT-ND
R17: 309k; R_0603_1608Metric; DIGIKEY P309KHCT-ND
R20: 80.6k; R_0603_1608Metric; DIGIKEY P80.6KHCT-ND
R22, R23: 27.4k; R_0603_1608Metric; DIGIKEY P27.4KHCT-ND
U5, U6: TPS629210; SOT-583-8; DIGIKEY 296-TPS629210DRLRCT-ND

Connections:
+3.3V: C14.1, C15.1, D10.2 (A), L1.2, U5.3 (VOS); also elsewhere on the board
+5V: C17.1, C18.1, D12.2 (A), L2.2, U6.3 (VOS); also elsewhere on the board
GND: C12.2, C13.2, C14.2, C15.2, C16.2, C17.2, C18.2, J10.1, R14.2, R16.2, R17.2, R18.2, R20.2, R22.2, R23.2, U5.5 (GND), U6.5 (GND); also elsewhere on the board
unnamed: D8.1 (K), R15.1
unnamed: D9.1 (K), R16.1
unnamed: D10.1 (K), R14.1
unnamed: D11.1 (K), R19.1
unnamed: D12.1 (K), R18.1
unnamed: R17.1, U5.1 (FB/VSET)
unnamed: R22.1, U5.8 (MODE)
unnamed: R15.2, U5.2 (PG)
unnamed: L1.1, U5.4 (SW)
unnamed: R20.1, U6.1 (FB/VSET)
unnamed: R23.1, U6.8 (MODE)
unnamed: R19.2, U6.2 (PG)
unnamed: L2.1, U6.4 (SW)
VDD: C12.1, C13.1, C16.1, D8.2 (A), D9.2 (A), D11.2 (A), J10.2, U5.6 (IN), U5.7 (EN), U6.6 (IN), U6.7 (EN); also elsewhere on the board

Notes on the sheet:
3.3v Supply
C17/C18 at 5V derate to ~13uF each, >= 22uF effective required. C13 4.7uF nominal acceptable.
Bus Aux Connector
5v Supply
Tank
C14/C15 at 3.3V derate to ~18uF each, >= 22uF effective required. C13 4.7uF nominal acceptable.

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
