melair/ktane/PCB/ControlBoard/ControlBoard.kicad_pcb

## KiCad design PCB/ControlBoard/ControlBoard.kicad_pcb (continued)

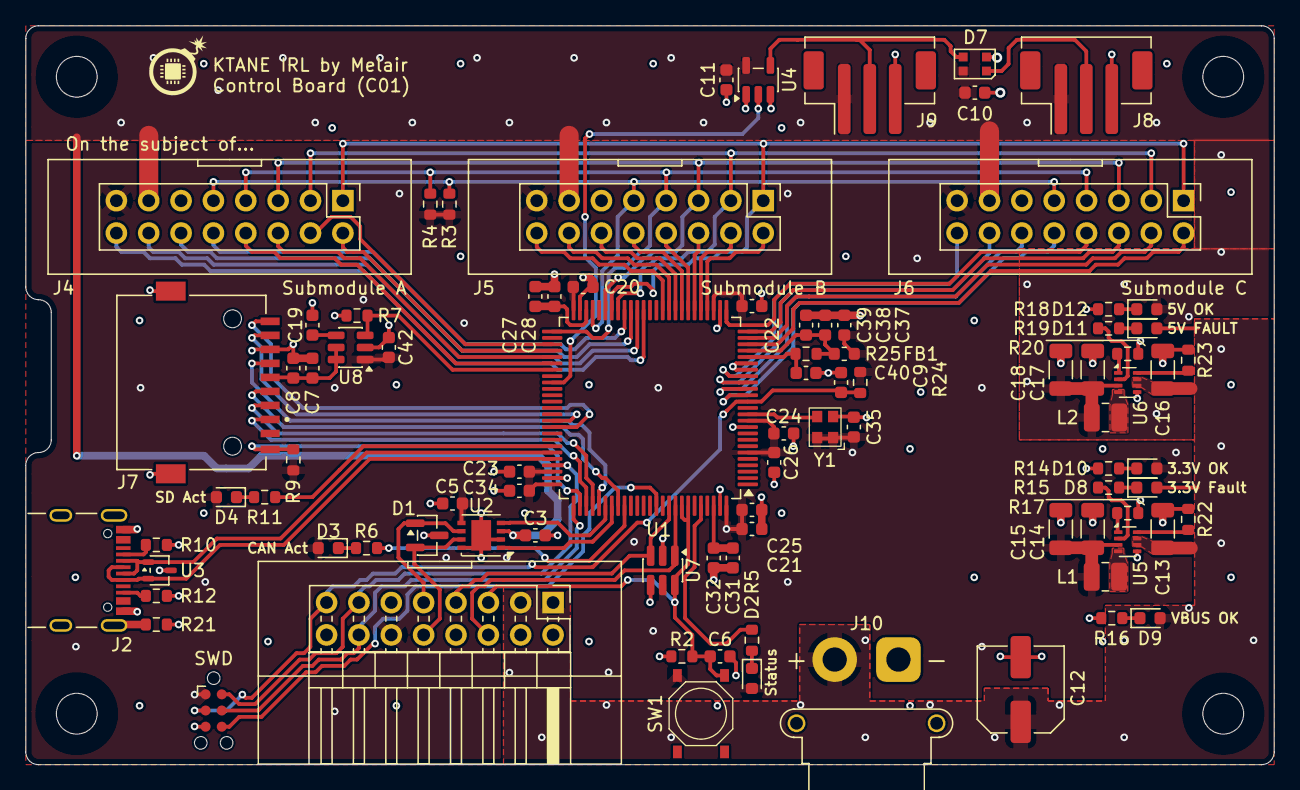
[picture p52: board ControlBoard.kicad_pcb from above]

Board: 4 copper layers, 98.0 x 58.0 mm, 93 parts (0 on the bottom side), 86 nets.
