melair/ktane/PCB/Others/Timer/Timer.kicad_pcb

## KiCad design PCB/Others/Timer/Timer.kicad_pcb (2026-04-29)

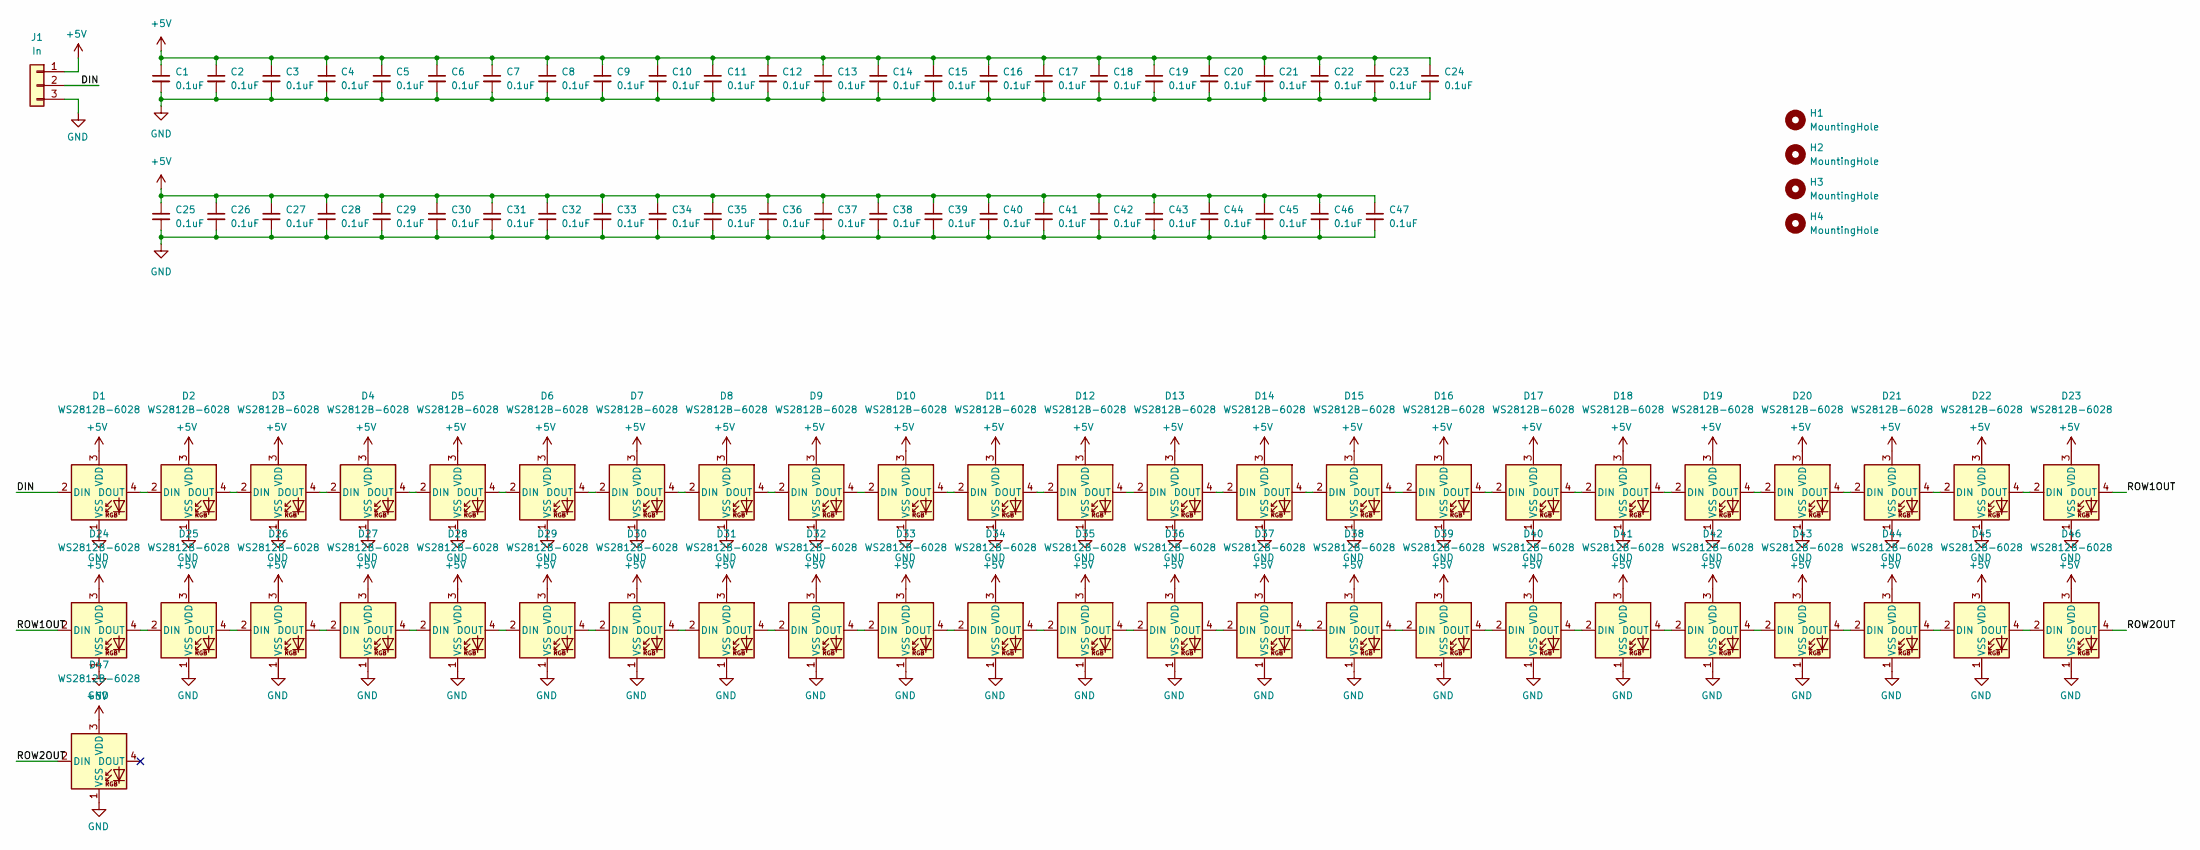
[picture p53: schematic Timer.kicad_sch]

Parts:
C1, C2, C3, C4, C5, C6, C7, C8, C9, C10, C11, C12, C13, C14, C15, C16, C17, C18, C19, C20, C21, C22, C23, C24, C25, C26, C27, C28, C29, C30, C31, C32, C33, C34, C35, C36, C37, C38, C39, C40, C41, C42, C43, C44, C45, C46, C47: 0.1uF; C_0603_1608Metric; DIGIKEY 1276-1005-1-ND
D1, D2, D3, D4, D5, D6, D7, D8, D9, D10, D11, D12, D13, D14, D15, D16, D17, D18, D19, D20, D21, D22, D23, D24, D25, D26, D27, D28, D29, D30, D31, D32, D33, D34, D35, D36, D37, D38, D39, D40, D41, D42, D43, D44, D45, D46, D47: WS2812B-6028; LED_RGB_SMD_6028_2.8x3.5mm_Square; DIGIKEY STOCK/AliExpress
H1, H2, H3, H4: MountingHole; MountingHole_3.2mm_M3; DIGIKEY NONE
J1: In; JST_PH_B3B-PH-SM4-TB_1x03-1MP_P2.00mm_Vertical; DIGIKEY 455-B3B-PH-SM4-TBCT-ND

Connections:
+5V: C1.1, C2.1, C3.1, C4.1, C5.1, C6.1, C7.1, C8.1, C9.1, C10.1, C11.1, C12.1, C13.1, C14.1, C15.1, C16.1, C17.1, C18.1, C19.1, C20.1, C21.1, C22.1, C23.1, C24.1, C25.1, C26.1, C27.1, C28.1, C29.1, C30.1, C31.1, C32.1, C33.1, C34.1, C35.1, C36.1, C37.1, C38.1, C39.1, C40.1, C41.1, C42.1, C43.1, C44.1, C45.1, C46.1, C47.1, D1.3 (VDD), D2.3 (VDD), D3.3 (VDD), D4.3 (VDD), D5.3 (VDD), D6.3 (VDD), D7.3 (VDD), D8.3 (VDD), D9.3 (VDD), D10.3 (VDD), D11.3 (VDD), D12.3 (VDD), D13.3 (VDD), D14.3 (VDD), D15.3 (VDD), D16.3 (VDD), D17.3 (VDD), D18.3 (VDD), D19.3 (VDD), D20.3 (VDD), D21.3 (VDD), D22.3 (VDD), D23.3 (VDD), D24.3 (VDD), D25.3 (VDD), D26.3 (VDD), D27.3 (VDD), D28.3 (VDD), D29.3 (VDD), D30.3 (VDD), D31.3 (VDD), D32.3 (VDD), D33.3 (VDD), D34.3 (VDD), D35.3 (VDD), D36.3 (VDD), D37.3 (VDD), D38.3 (VDD), D39.3 (VDD), D40.3 (VDD), D41.3 (VDD), D42.3 (VDD), D43.3 (VDD), D44.3 (VDD), D45.3 (VDD), D46.3 (VDD), D47.3 (VDD), J1.1
/DIN: D1.2 (DIN), J1.2
/ROW1OUT: D23.4 (DOUT), D24.2 (DIN)
/ROW2OUT: D46.4 (DOUT), D47.2 (DIN)
GND: C1.2, C2.2, C3.2, C4.2, C5.2, C6.2, C7.2, C8.2, C9.2, C10.2, C11.2, C12.2, C13.2, C14.2, C15.2, C16.2, C17.2, C18.2, C19.2, C20.2, C21.2, C22.2, C23.2, C24.2, C25.2, C26.2, C27.2, C28.2, C29.2, C30.2, C31.2, C32.2, C33.2, C34.2, C35.2, C36.2, C37.2, C38.2, C39.2, C40.2, C41.2, C42.2, C43.2, C44.2, C45.2, C46.2, C47.2, D1.1 (VSS), D2.1 (VSS), D3.1 (VSS), D4.1 (VSS), D5.1 (VSS), D6.1 (VSS), D7.1 (VSS), D8.1 (VSS), D9.1 (VSS), D10.1 (VSS), D11.1 (VSS), D12.1 (VSS), D13.1 (VSS), D14.1 (VSS), D15.1 (VSS), D16.1 (VSS), D17.1 (VSS), D18.1 (VSS), D19.1 (VSS), D20.1 (VSS), D21.1 (VSS), D22.1 (VSS), D23.1 (VSS), D24.1 (VSS), D25.1 (VSS), D26.1 (VSS), D27.1 (VSS), D28.1 (VSS), D29.1 (VSS), D30.1 (VSS), D31.1 (VSS), D32.1 (VSS), D33.1 (VSS), D34.1 (VSS), D35.1 (VSS), D36.1 (VSS), D37.1 (VSS), D38.1 (VSS), D39.1 (VSS), D40.1 (VSS), D41.1 (VSS), D42.1 (VSS), D43.1 (VSS), D44.1 (VSS), D45.1 (VSS), D46.1 (VSS), D47.1 (VSS), J1.3
unnamed: D1.4 (DOUT), D2.2 (DIN)
unnamed: D2.4 (DOUT), D3.2 (DIN)
unnamed: D3.4 (DOUT), D4.2 (DIN)
unnamed: D4.4 (DOUT), D5.2 (DIN)
unnamed: D5.4 (DOUT), D6.2 (DIN)
unnamed: D6.4 (DOUT), D7.2 (DIN)
unnamed: D7.4 (DOUT), D8.2 (DIN)
unnamed: D8.4 (DOUT), D9.2 (DIN)
unnamed: D9.4 (DOUT), D10.2 (DIN)
unnamed: D10.4 (DOUT), D11.2 (DIN)
unnamed: D11.4 (DOUT), D12.2 (DIN)
unnamed: D12.4 (DOUT), D13.2 (DIN)
unnamed: D13.4 (DOUT), D14.2 (DIN)
unnamed: D14.4 (DOUT), D15.2 (DIN)
unnamed: D15.4 (DOUT), D16.2 (DIN)
unnamed: D16.4 (DOUT), D17.2 (DIN)
unnamed: D17.4 (DOUT), D18.2 (DIN)
unnamed: D18.4 (DOUT), D19.2 (DIN)
unnamed: D19.4 (DOUT), D20.2 (DIN)
unnamed: D20.4 (DOUT), D21.2 (DIN)
unnamed: D21.4 (DOUT), D22.2 (DIN)
unnamed: D22.4 (DOUT), D23.2 (DIN)
unnamed: D24.4 (DOUT), D25.2 (DIN)
unnamed: D25.4 (DOUT), D26.2 (DIN)
unnamed: D26.4 (DOUT), D27.2 (DIN)
unnamed: D27.4 (DOUT), D28.2 (DIN)
unnamed: D28.4 (DOUT), D29.2 (DIN)
unnamed: D29.4 (DOUT), D30.2 (DIN)
unnamed: D30.4 (DOUT), D31.2 (DIN)
unnamed: D31.4 (DOUT), D32.2 (DIN)
unnamed: D32.4 (DOUT), D33.2 (DIN)
unnamed: D33.4 (DOUT), D34.2 (DIN)
unnamed: D34.4 (DOUT), D35.2 (DIN)
unnamed: D35.4 (DOUT), D36.2 (DIN)
unnamed: D36.4 (DOUT), D37.2 (DIN)
unnamed: D37.4 (DOUT), D38.2 (DIN)
unnamed: D38.4 (DOUT), D39.2 (DIN)
unnamed: D39.4 (DOUT), D40.2 (DIN)
unnamed: D40.4 (DOUT), D41.2 (DIN)
unnamed: D41.4 (DOUT), D42.2 (DIN)
unnamed: D42.4 (DOUT), D43.2 (DIN)
unnamed: D43.4 (DOUT), D44.2 (DIN)
unnamed: D44.4 (DOUT), D45.2 (DIN)
unnamed: D45.4 (DOUT), D46.2 (DIN)

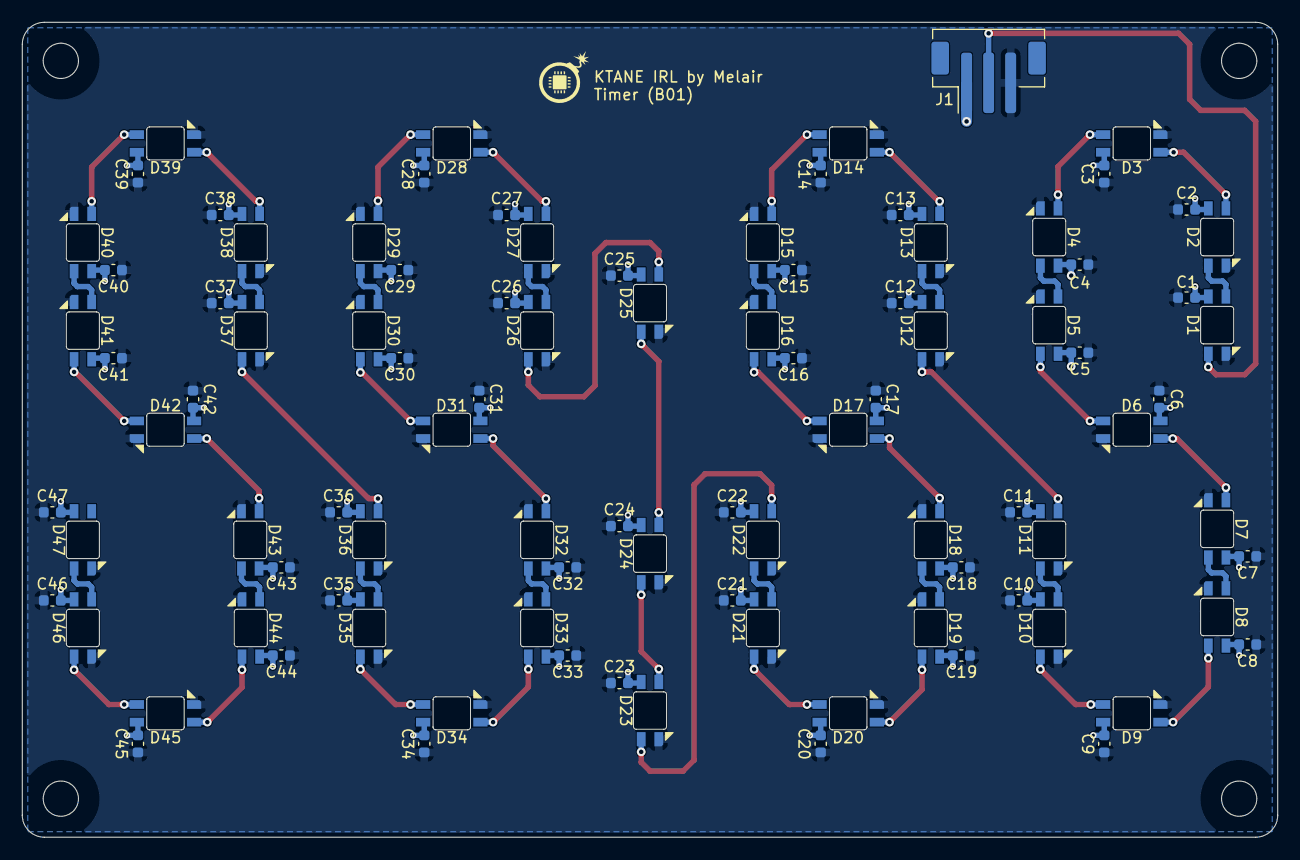
[picture p54: board Timer.kicad_pcb from below]

Board: 2 copper layers, 114.0 x 74.0 mm, 99 parts (52 on the bottom side), 49 nets.
