melair/ktane/PCB/Modules/PullUpDown/PullUpDown.kicad_pcb

## KiCad design PCB/Modules/PullUpDown/PullUpDown.kicad_pcb (2026-04-29)

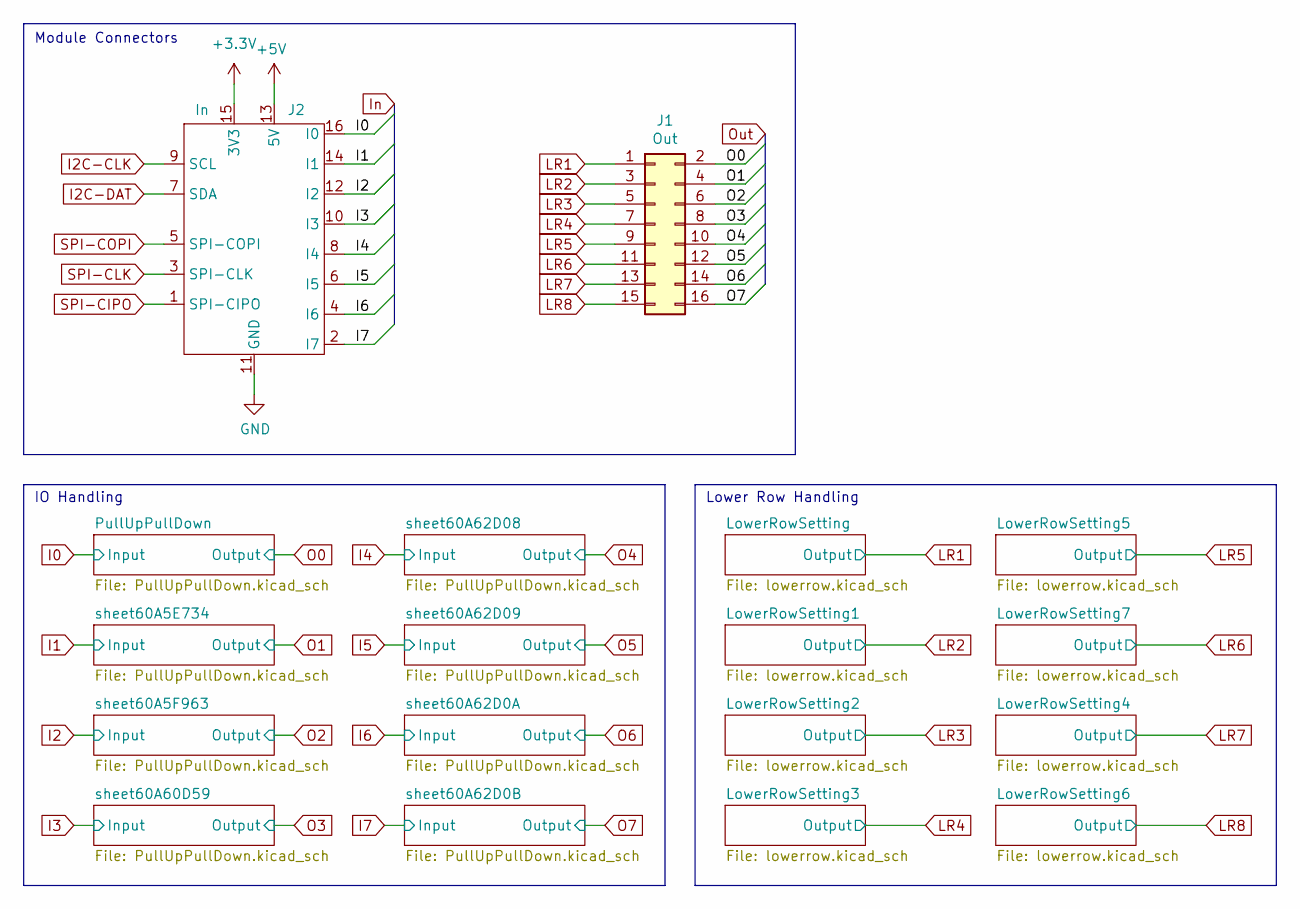
[picture p55: schematic PullUpDown.kicad_sch, KTANE Physical Edition - Pull Up/Down Module]

Parts:
J1: Out; PinHeader_2x08_P2.54mm_Vertical-Centered; DIGIKEY S9171-ND
J2: In; KTANE Submodule Connector V2 - Short; DIGIKEY STOCK

Connections:
+3.3V: J2.15 (3V3); also elsewhere on the board
+5V: J2.13 (5V); also elsewhere on the board
GND: J2.11 (GND); also elsewhere on the board
I0: J2.16 (I0); also elsewhere on the board
I1: J2.14 (I1); also elsewhere on the board
I2: J2.12 (I2); also elsewhere on the board
I2C-CLK: J2.9 (SCL)
I2C-DAT: J2.7 (SDA)
I3: J2.10 (I3); also elsewhere on the board
I4: J2.8 (I4); also elsewhere on the board
I5: J2.6 (I5); also elsewhere on the board
I6: J2.4 (I6); also elsewhere on the board
I7: J2.2 (I7); also elsewhere on the board
LR1: J1.1; also elsewhere on the board
LR2: J1.3; also elsewhere on the board
LR3: J1.5; also elsewhere on the board
LR4: J1.7; also elsewhere on the board
LR5: J1.9; also elsewhere on the board
LR6: J1.11; also elsewhere on the board
LR7: J1.13; also elsewhere on the board
LR8: J1.15; also elsewhere on the board
O0: J1.2; also elsewhere on the board
O1: J1.4; also elsewhere on the board
O2: J1.6; also elsewhere on the board
O3: J1.8; also elsewhere on the board
O4: J1.10; also elsewhere on the board
O5: J1.12; also elsewhere on the board
O6: J1.14; also elsewhere on the board
O7: J1.16; also elsewhere on the board
SPI-CIPO: J2.1 (SPI-CIPO)
SPI-CLK: J2.3 (SPI-CLK)
SPI-COPI: J2.5 (SPI-COPI)

Notes on the sheet:
Module Connectors
IO Handling
Lower Row Handling

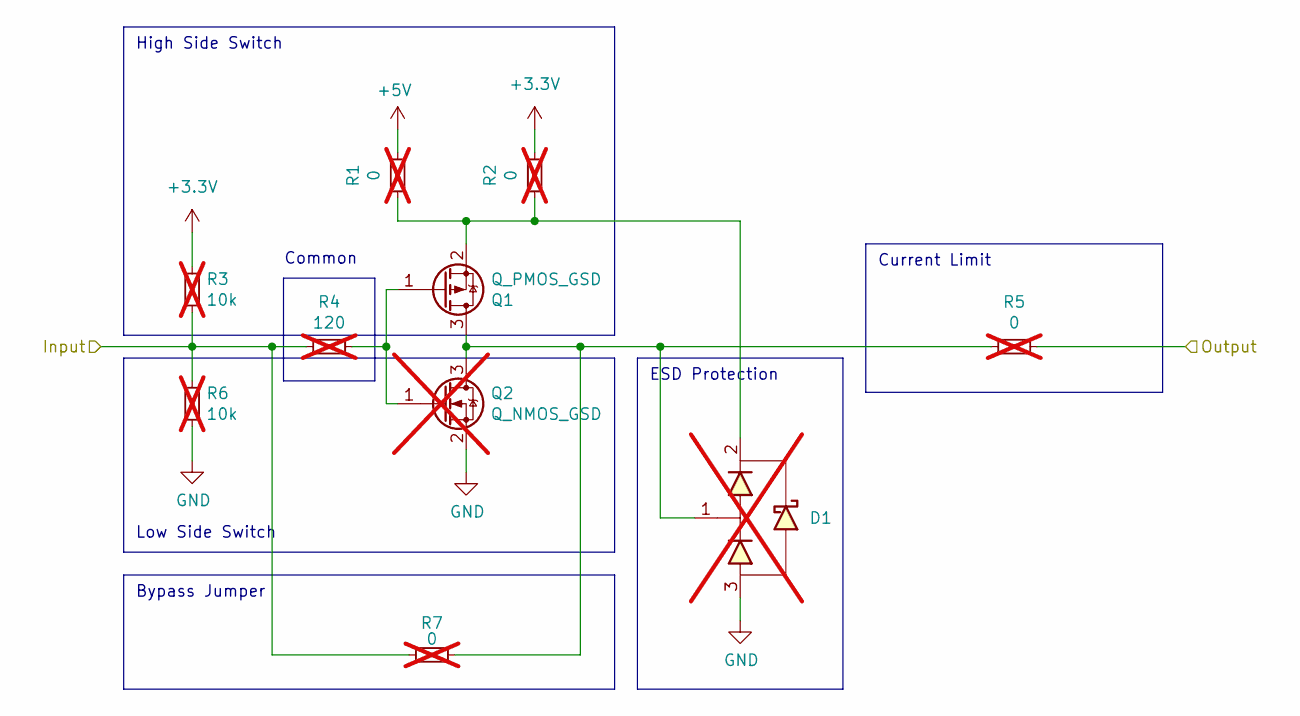
[picture p56: schematic PullUpPullDown.kicad_sch]

Parts:
D1: D1213A-01SO-7; SOT-23; DIGIKEY D1213A-01SO-7DICT-ND; not fitted
Q1: Q_PMOS_GSD; SOT-23; DIGIKEY DMG2301L-7DICT-ND
Q2: Q_NMOS_GSD; SOT-23; DIGIKEY 31-DMN2310U-7CT-ND; not fitted
R1, R2, R5, R7: 0; R_0603_1608Metric; DIGIKEY 10-ERJ-H3G0R00VCT-ND; not fitted
R3, R6: 10k; R_0603_1608Metric; DIGIKEY P10.0KHCT-ND; not fitted
R4: 120; R_0603_1608Metric; DIGIKEY P120HCT-ND; not fitted

Connections:
+3.3V: R2.1, R3.2; also elsewhere on the board
+5V: R1.1; also elsewhere on the board
GND: D1.3, Q2.2 (S), R6.1; also elsewhere on the board
I0: R3.1, R4.1, R6.2, R7.2; also elsewhere on the board
unnamed: D1.1, Q1.3 (D), Q2.3 (D), R5.2, R7.1
unnamed: Q1.1 (G), Q2.1 (G), R4.2
unnamed: D1.2, Q1.2 (S), R1.2, R2.2
O0: R5.1; also elsewhere on the board

Parts of its further copies:
D2, D3, D4, D5, D6, D7, D8: D1213A-01SO-7; SOT-23; DIGIKEY D1213A-01SO-7DICT-ND; not fitted
Q3, Q5, Q7, Q9, Q11, Q13, Q15: Q_PMOS_GSD; SOT-23; DIGIKEY DMG2301L-7DICT-ND
Q4, Q6, Q8, Q10, Q12, Q14, Q16: Q_NMOS_GSD; SOT-23; DIGIKEY 31-DMN2310U-7CT-ND; not fitted
R8, R9, R12, R14, R15, R16, R19, R21, R22, R23, R26, R28, R29, R30, R33, R35, R36, R37, R40, R42, R43, R44, R47, R49, R50, R51, R54, R56: 0; R_0603_1608Metric; DIGIKEY 10-ERJ-H3G0R00VCT-ND; not fitted
R10, R13, R17, R20, R24, R27, R31, R34, R38, R41, R45, R48, R52, R55: 10k; R_0603_1608Metric; DIGIKEY P10.0KHCT-ND; not fitted

Connections of its further copies:
+3.3V: R9.1, R10.2, R16.1, R17.2, R23.1, R24.2, R30.1, R31.2, R37.1, R38.2, R44.1, R45.2, R51.1, R52.2; also elsewhere on the board
+5V: R8.1, R15.1, R22.1, R29.1, R36.1, R43.1, R50.1; also elsewhere on the board
GND: D2.3, D3.3, D4.3, D5.3, D6.3, D7.3, D8.3, Q4.2 (S), Q6.2 (S), Q8.2 (S), Q10.2 (S), Q12.2 (S), Q14.2 (S), Q16.2 (S), R13.1, R20.1, R27.1, R34.1, R41.1, R48.1, R55.1; also elsewhere on the board
I1: R10.1, R13.2, R14.2; also elsewhere on the board
I2: R17.1, R20.2, R21.2; also elsewhere on the board
I3: R24.1, R27.2, R28.2; also elsewhere on the board
I4: R31.1, R34.2, R35.2; also elsewhere on the board
I5: R38.1, R41.2, R42.2; also elsewhere on the board
I6: R45.1, R48.2, R49.2; also elsewhere on the board
I7: R52.1, R55.2, R56.2; also elsewhere on the board
unnamed: D2.1, Q3.3 (D), Q4.3 (D), R12.2, R14.1
unnamed 25: Q3.1 (G), Q4.1 (G); also elsewhere on the board
unnamed: D2.2, Q3.2 (S), R8.2, R9.2
unnamed: D3.1, Q5.3 (D), Q6.3 (D), R19.2, R21.1
unnamed 28: Q5.1 (G), Q6.1 (G); also elsewhere on the board
unnamed: D3.2, Q5.2 (S), R15.2, R16.2
unnamed: D4.1, Q7.3 (D), Q8.3 (D), R26.2, R28.1
unnamed 31: Q7.1 (G), Q8.1 (G); also elsewhere on the board
unnamed: D4.2, Q7.2 (S), R22.2, R23.2
unnamed: D5.2, Q9.2 (S), R29.2, R30.2
unnamed: D5.1, Q9.3 (D), Q10.3 (D), R33.2, R35.1
unnamed 35: Q9.1 (G), Q10.1 (G); also elsewhere on the board
unnamed: D6.1, Q11.3 (D), Q12.3 (D), R40.2, R42.1
unnamed 37: Q11.1 (G), Q12.1 (G); also elsewhere on the board
unnamed: D6.2, Q11.2 (S), R36.2, R37.2
unnamed: D7.1, Q13.3 (D), Q14.3 (D), R47.2, R49.1
unnamed 40: Q13.1 (G), Q14.1 (G); also elsewhere on the board
unnamed: D7.2, Q13.2 (S), R43.2, R44.2
unnamed: D8.1, Q15.3 (D), Q16.3 (D), R54.2, R56.1
unnamed 43: Q15.1 (G), Q16.1 (G); also elsewhere on the board
unnamed: D8.2, Q15.2 (S), R50.2, R51.2
O1: R12.1; also elsewhere on the board
O2: R19.1; also elsewhere on the board
O3: R26.1; also elsewhere on the board
O4: R33.1; also elsewhere on the board
O5: R40.1; also elsewhere on the board
O6: R47.1; also elsewhere on the board
O7: R54.1; also elsewhere on the board

Notes on the sheet:
ESD Protection
High Side Switch
Common
Current Limit
Bypass Jumper
Low Side Switch

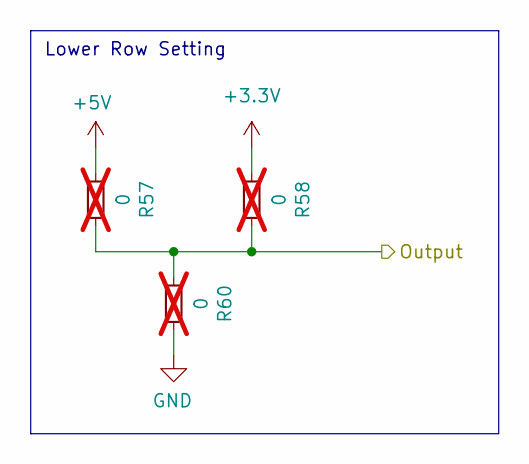
[picture p57: schematic lowerrow.kicad_sch]

Parts:
R57, R58, R60: 0; R_0603_1608Metric; DIGIKEY 10-ERJ-H3G0R00VCT-ND; not fitted

Connections:
+3.3V: R58.2; also elsewhere on the board
+5V: R57.2; also elsewhere on the board
GND: R60.1; also elsewhere on the board
LR1: R57.1, R58.1, R60.2; also elsewhere on the board

Parts of its further copies:
R61, R62, R64, R65, R66, R68, R69, R70, R72, R73, R74, R76, R77, R78, R80, R81, R82, R84, R85, R86, R88: 0; R_0603_1608Metric; DIGIKEY 10-ERJ-H3G0R00VCT-ND; not fitted

Connections of its further copies:
+3.3V: R62.2, R66.2, R70.2, R74.2, R78.2, R82.2, R86.2; also elsewhere on the board
+5V: R61.2, R65.2, R69.2, R73.2, R77.2, R81.2, R85.2; also elsewhere on the board
GND: R64.1, R68.1, R72.1, R76.1, R80.1, R84.1, R88.1; also elsewhere on the board
LR2: R61.1, R62.1, R64.2; also elsewhere on the board
LR3: R65.1, R66.1, R68.2; also elsewhere on the board
LR4: R69.1, R70.1, R72.2; also elsewhere on the board
LR5: R73.1, R74.1, R76.2; also elsewhere on the board
LR6: R77.1, R78.1, R80.2; also elsewhere on the board
LR7: R81.1, R82.1, R84.2; also elsewhere on the board
LR8: R85.1, R86.1, R88.2; also elsewhere on the board

Notes on the sheet:
Lower Row Setting

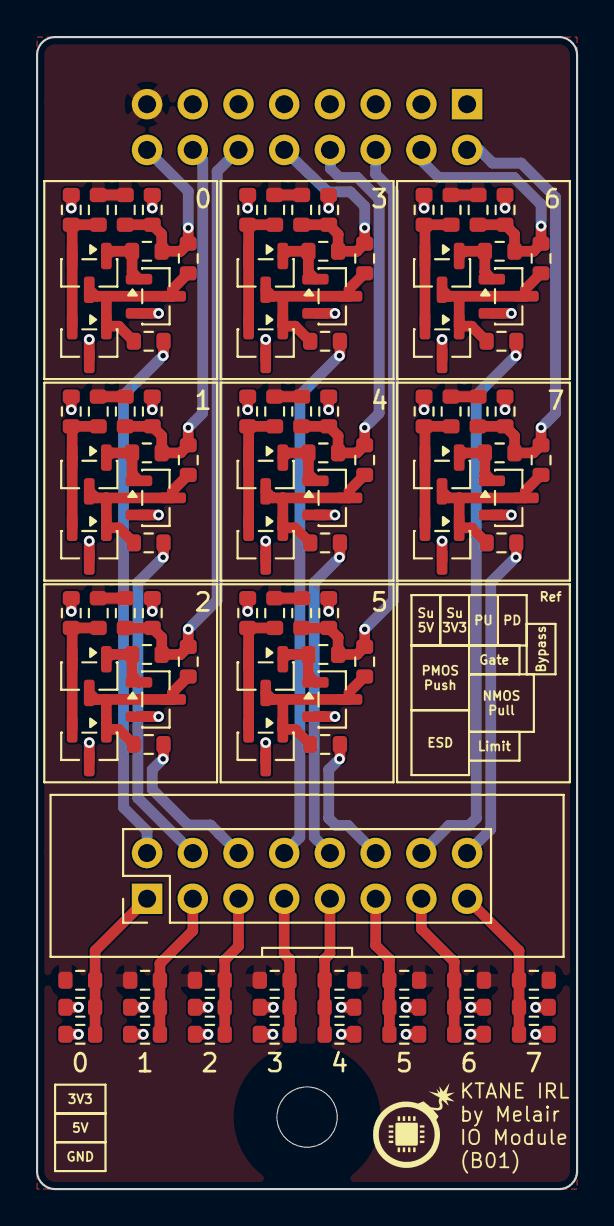
[picture p58: board PullUpDown.kicad_pcb from above]

Board: 4 copper layers, 30.0 x 64.0 mm, 106 parts (0 on the bottom side), 51 nets.

Other parts of the board:
R11, R18, R25, R32, R39, R46, R53: 100; R_0603_1608Metric

Their connections:
I1: R11.1; also elsewhere on the board
I2: R18.1; also elsewhere on the board
I3: R25.1; also elsewhere on the board
I4: R32.1; also elsewhere on the board
I5: R39.1; also elsewhere on the board
I6: R46.1; also elsewhere on the board
I7: R53.1; also elsewhere on the board
unnamed 25: R11.2; also elsewhere on the board
unnamed 28: R18.2; also elsewhere on the board
unnamed 31: R25.2; also elsewhere on the board
unnamed 35: R32.2; also elsewhere on the board
unnamed 37: R39.2; also elsewhere on the board
unnamed 40: R46.2; also elsewhere on the board
unnamed 43: R53.2; also elsewhere on the board
