melair/ktane/PCB/Edgework/Bus/Bus.kicad_pcb

## KiCad design PCB/Edgework/Bus/Bus.kicad_pcb (2026-04-29)

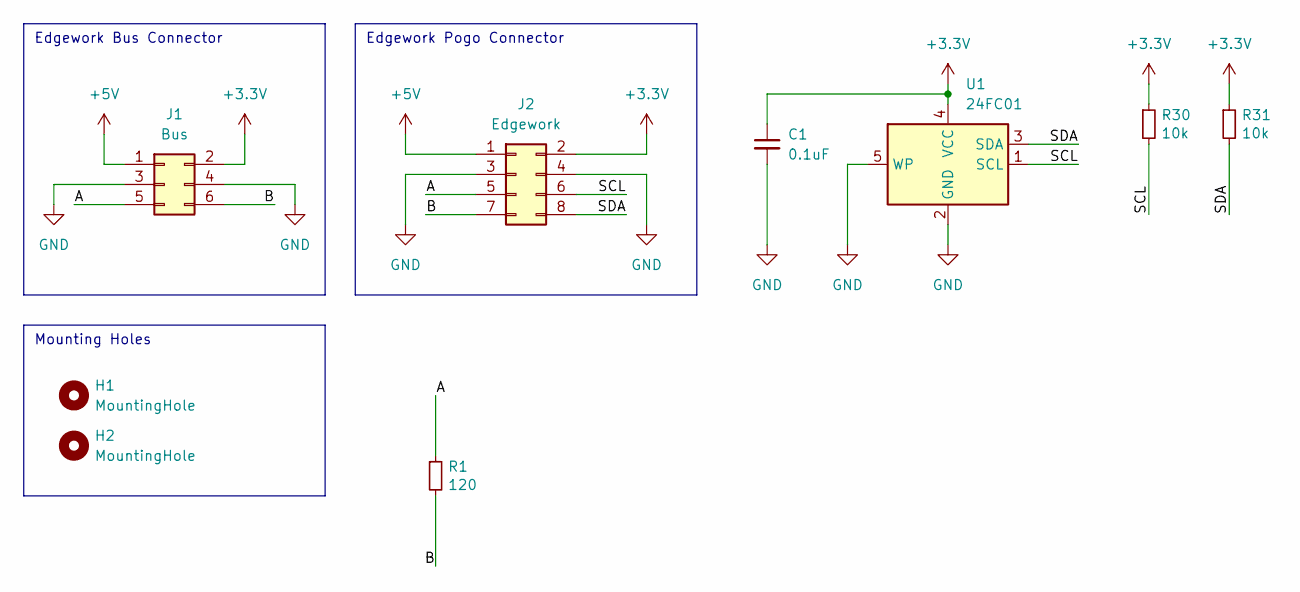
[picture p59: schematic Bus.kicad_sch]

Parts:
C1: 0.1uF; C_0603_1608Metric; DIGIKEY 1276-1005-1-ND
H1, H2: MountingHole; MountingHole_3.2mm_M3; DIGIKEY NONE
J1: Bus; PinHeader_2x03_P2.54mm_Horizontal; DIGIKEY STOCK
J2: Edgework; PinHeader_2x04_P2.54mm_Vertical; DIGIKEY STOCK
R1: 120; R_0603_1608Metric; DIGIKEY P120HCT-ND
R30, R31: 10k; R_0603_1608Metric; DIGIKEY P10.0KHCT-ND
U1: 24FC01; SOT-23-5; DIGIKEY 24FC01T-I/OTCT-ND

Connections:
+3.3V: C1.1, J1.2, J2.2, R30.1, R31.1, U1.4 (VCC)
+5V: J1.1, J2.1
/A: J1.5, J2.5, R1.1
/B: J1.6, J2.7, R1.2
/SCL: J2.6, R30.2, U1.1 (SCL)
/SDA: J2.8, R31.2, U1.3 (SDA)
GND: C1.2, J1.3, J1.4, J2.3, J2.4, U1.2 (GND), U1.5 (WP)

Notes on the sheet:
Edgework Bus Connector
Edgework Pogo Connector
Mounting Holes

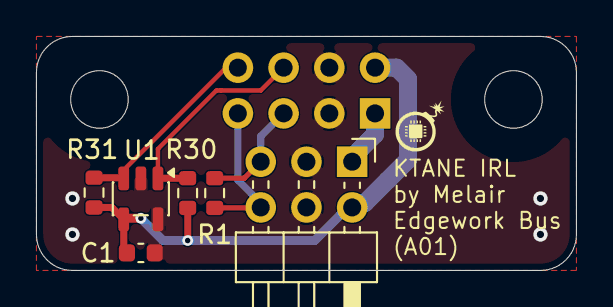
[picture p60: board Bus.kicad_pcb from above]

Board: 2 copper layers, 30.0 x 13.0 mm, 9 parts (1 on the bottom side), 7 nets.
