melair/ktane/PCB/Modules/LCDDriver/LCDDriver.kicad_pcb

## KiCad design PCB/Modules/LCDDriver/LCDDriver.kicad_pcb (2026-04-29)

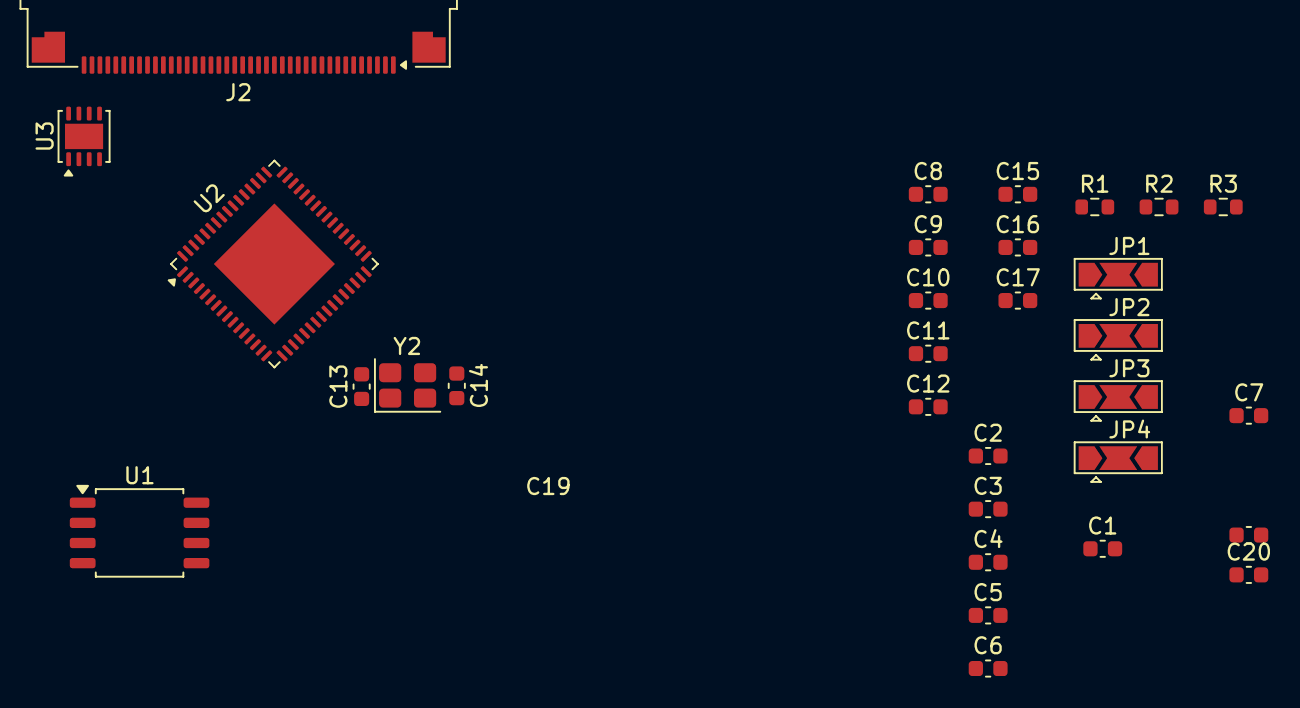
[picture p61: board LCDDriver.kicad_pcb from above]

Board: 2 copper layers, 31 parts (0 on the bottom side), 49 nets, no tracks yet.

Parts:
C1, C3, C5, C7, C8, C11, C16, C20: 1uF; C_0603_1608Metric
C2, C4, C6, C9, C10, C15, C19: 0.1uF; C_0603_1608Metric
C12: 3.3uF; C_0603_1608Metric
C13, C14: 18pF; C_0603_1608Metric
C17: 220nF; C_0603_1608Metric
J2: LCD; Amphenol_F32Q-1A7x1-11040_1x40-1MP_P0.5mm_Horizontal
JP1, JP2: TP-RST; SolderJumper-3_P2.0mm_Open_TrianglePad1.0x1.5mm
JP3: TP-SCL; SolderJumper-3_P2.0mm_Open_TrianglePad1.0x1.5mm
JP4: TP-SDA; SolderJumper-3_P2.0mm_Open_TrianglePad1.0x1.5mm
R1, R2, R3: 12; R_0603_1608Metric
U1: W25Q64JVSS; SOIC-8_5.3x5.3mm_P1.27mm
U2: BT817Q; VQFN-64-1EP_9x9mm_P0.5mm_EP5.4x5.4mm
U3: TPS61062; VSON-8-1EP_3x3mm_P0.65mm_EP1.6x2.4mm
Y2: Crystal_GND24_Small; Crystal_SMD_SeikoEpson_FA238-4Pin_3.2x2.5mm

Connections:
+1V2: C12.1, C15.1, C19.1, C20.1, U2.2 (VCC1V2), U2.25 (VOUT1V2), U2.57 (VCC1V2)
+3.3V: C1.1, C2.1, C3.1, C4.1, C5.1, C6.1, C7.1, C8.1, C9.1, C10.1, C11.1, U1.8 (VCC), U2.9 (VCCIO1), U2.17 (VCCIO3), U2.24 (VCC), U2.27 (VCCA), U2.28 (VCCIO2)
+5V: C16.1, U3.8 (VIN)
/CTP-SCL: JP3.1 (A), U2.31 (CTP_SCL)
/CTP-SDA: JP4.1 (A), U2.32 (CTP_SDA)
/DB0: J2.25, U2.63 (R2)
/DB1: J2.24, U2.62 (R3)
/DB2: J2.23, U2.61 (R4)
/DB3: J2.22, U2.60 (R5)
/DB4: J2.21, U2.59 (R6)
/DB5: J2.20, U2.58 (R7)
/DB6: J2.19, U2.54 (G2)
/DB7: J2.18, U2.53 (G3)
/DB8: J2.17, U2.52 (G4)
/DB9: J2.16, U2.51 (G5)
/DB10: J2.15, U2.50 (G6)
/DB11: J2.14, U2.49 (G7)
/DB12: J2.13, U2.45 (B2)
/DB13: J2.12, U2.44 (B3)
/DB14: J2.11, U2.43 (B4)
/DB15: J2.10, U2.42 (B5)
/DB16: J2.9, U2.41 (B6)
/DB17: J2.8, U2.40 (B7)
/DE: J2.28, U2.35 (DE)
/HS: J2.26, U2.37 (HSYNC)
/PCLK: J2.29, U2.39 (PCLK)
/SPIM_IO2: U1.3 (~WP/IO_{2}), U2.19 (SPIM_IO2)
/SPIM_IO3: U1.7 (~HOLD/~RESET/IO_{3}), U2.20 (SPIM_IO3)
/SPIM_MISO: U1.2 (DO/IO_{1}), U2.18 (SPIM_MISO)
/SPIM_MOSI: U1.5 (DI/IO_{0}), U2.16 (SPIM_MOSI)
/SPIM_SCLK: U1.6 (CLK), U2.14 (SPIM_SCLK)
/TP-SCL: J2.4, JP3.2 (C)
/TP-SDA: J2.5, JP4.2 (C)
/VS: J2.27, U2.36 (VSYNC)
/X1: C13.1, U2.21 (X1/CLK), Y2.1
/X2: C14.1, U2.22 (X2), Y2.3
/~CTP-INT: JP2.1 (A), U2.30 (~CTP_INT)
/~CTP-RST: JP1.1 (A), U2.29 (~CTP_RST)
/~SPIM_SS: U1.1 (~CS), U2.15 (~SPIM_SS)
/~TP-INT: J2.6, JP2.2 (C)
/~TP-RST: J2.3, JP1.2 (C)
BACKLIGHT: U2.34 (BACKLIGHT), U3.2 (EN)
GND: C1.2, C2.2, C3.2, C4.2, C5.2, C6.2, C7.2, C8.2, C9.2, C10.2, C11.2, C12.2, C13.2, C14.2, C15.2, C16.2, C17.2, C19.2, C20.2, J2.1, J2.7, J2.37, R1.1, U1.4 (GND), U2.23 (GND), U2.33 (GND), U2.48 (GND), U2.65 (GND), U3.1 (GND), U3.3 (ILED), U3.5 (PGND), U3.9 (GND), Y2.2, Y2.4
LEDA: C17.1, J2.40, U3.7 (OUT)
LEDK1: J2.39, R2.1
LEDK2: J2.38, R3.1
unnamed: R1.2, R2.2, R3.2, U3.4 (FB)
SPI-CLK: J2.31, U2.3 (SCK)
SPI-COPI: J2.32, U2.5 (MOSI)
