melair/ktane/PCB/Modules/Power/Power.kicad_pcb

## KiCad design PCB/Modules/Power/Power.kicad_pcb (2026-04-29)

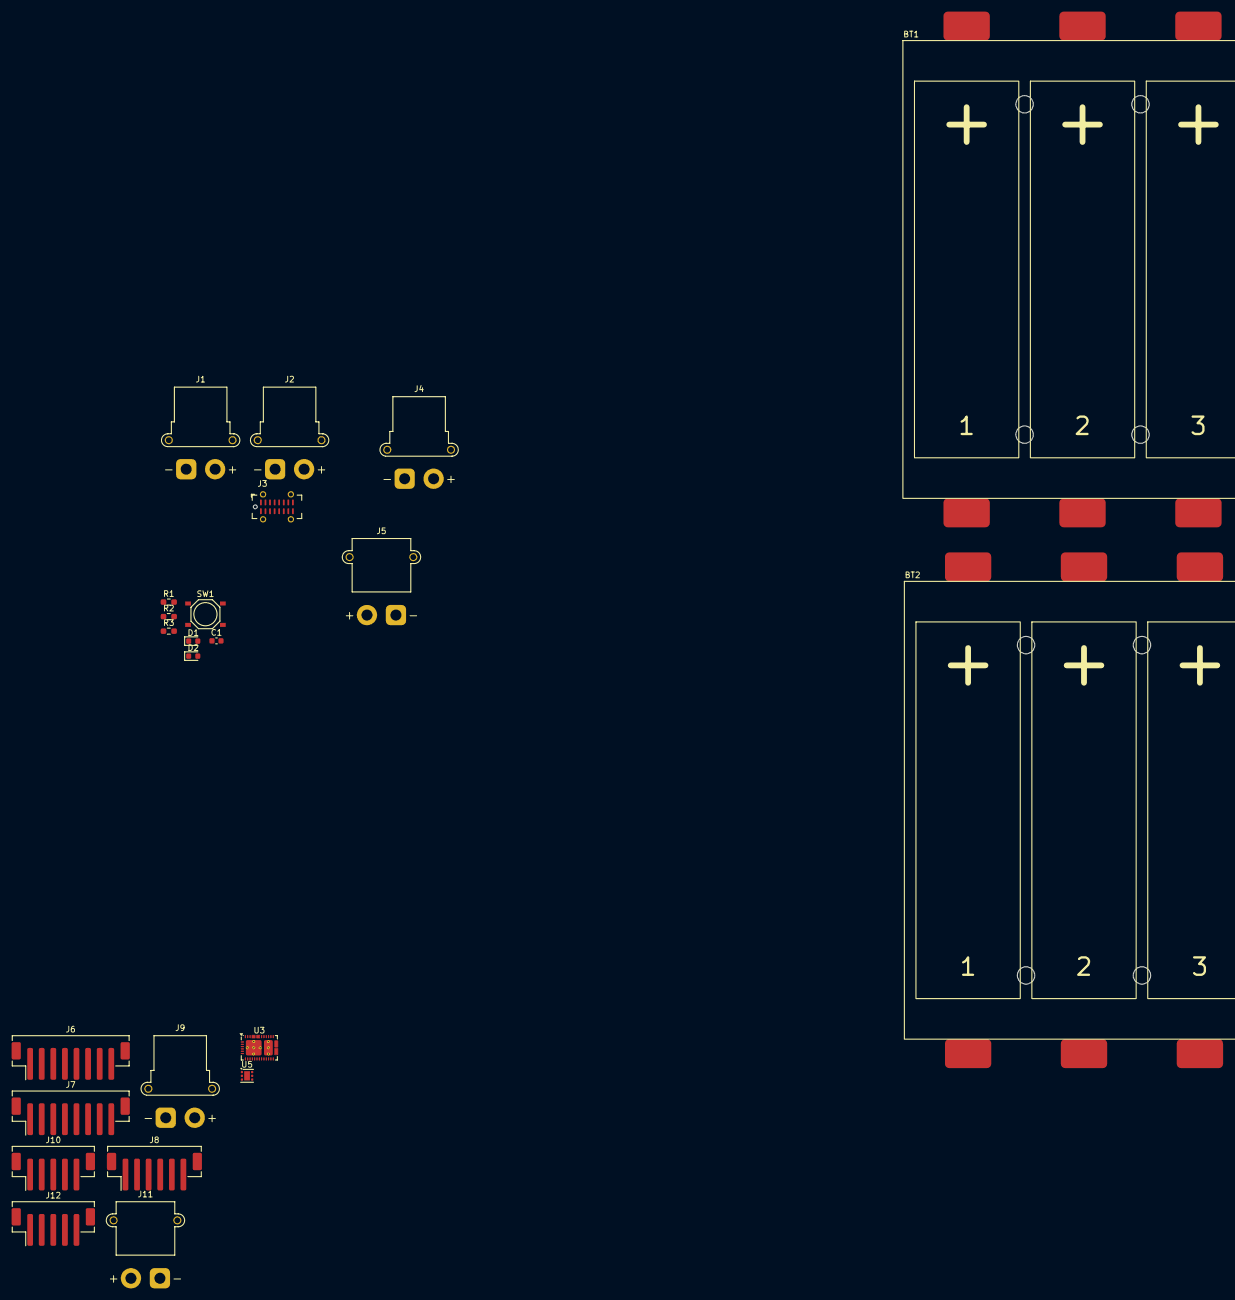
[picture p62: board Power.kicad_pcb from above]

Board: 2 copper layers, 23 parts (0 on the bottom side), 27 nets, no tracks yet.

Parts:
BT1, BT2: 3Cell18650Holder
C1: 1nF; C_0603_1608Metric
D1: OK; LED_0603_1608Metric
D2: Fault; LED_0603_1608Metric
J1: Out1; AMASS_XT30PW-F_1x02_P2.50mm_Horizontal
J2: Out2; AMASS_XT30PW-F_1x02_P2.50mm_Horizontal
J3: USB_C_Receptacle_USB2.0_14P; USB_C_Receptacle_G-Switch_GT-USB-7051x
J4: VBus; AMASS_XT30PW-F_1x02_P2.50mm_Horizontal
J5: VBus; AMASS_XT30PW-M_1x02_P2.50mm_Horizontal
J6, J7: Comms; JST_PH_B8B-PH-SM4-TB_1x08-1MP_P2.00mm_Vertical
J8: Host; JST_PH_B6B-PH-SM4-TB_1x06-1MP_P2.00mm_Vertical
J9: Battery; AMASS_XT30PW-F_1x02_P2.50mm_Horizontal
J10, J12: Comms; JST_PH_B5B-PH-SM4-TB_1x05-1MP_P2.00mm_Vertical
J11: Battery; AMASS_XT30PW-M_1x02_P2.50mm_Horizontal
R1: 1M; R_0603_1608Metric_Pad0.98x0.95mm_HandSolder
R2, R3: 100; R_0603_1608Metric_Pad0.98x0.95mm_HandSolder
SW1: Action; PTS526Sx15SMTR2xLFS
U3: TPS25751D; Texas_REF0038A_WQFN-38-2EP_6x4mm_P0.4
U5: TVS2200DRV; WSON-6-1EP_2x2mm_P0.65mm_EP1x1.6mm

Connections:
/Battery/GND: J11.1, J12.5
/Interface/BUTTON: J6.5, SW1.2
/Interface/CC1: J3.A5 (CC1), J6.1
/Interface/CC2: J3.B5 (CC2), J6.2
/Interface/D+: J3.A6 (D+), J3.B6 (D+), J6.4
/Interface/D-: J3.A7 (D-), J3.B7 (D-), J6.3
/Interface/GND: C1.2, D1.1 (K), D2.1 (K), J3.A1 (GND), J3.A12 (GND), J3.B1 (GND), J3.B12 (GND), J4.1, J6.8, R1.1, SW1.1
/Interface/LED-GREEN: J6.6, R2.1
/Interface/LED-RED: J6.7, R3.2
/Interface/SHIELD: C1.1, J3.S1 (SHIELD), R1.2
/Interface/VBUS: J3.A4 (VBUS), J3.A9 (VBUS), J3.B4 (VBUS), J3.B9 (VBUS), J4.2
/Manager/CC1: J7.1, U3.28 (CC1)
/Manager/CC2: J7.2, U3.29 (CC2)
/Manager/OUT1: J1.2, J2.2
/Manager/SCL: J10.1, U3.9 (I2Ct_SCL)
/Manager/SDA: J10.2, U3.8 (I2Ct_SDA)
/Manager/~ALERT: J10.3, U3.10 (~I2Ct_IRQ)
GND: J1.1, J2.1, J5.1, J7.8, J8.6, J9.1, J10.4, J10.5, U3.5 (GPIO0), U3.6 (GPIO1), U3.7 (GPIO2), U3.11 (GND), U3.12 (GND), U3.13 (GPIO11), U3.14 (GND), U3.19 (GPIO3), U3.26 (GPIO4), U3.27 (GPIO5), U3.31 (GND), U3.34 (PP5V), U3.36 (GPIO7), U3.37 (GPIO6), U3.39 (GND), U5.1 (GND), U5.2 (GND), U5.3 (GND), U5.7 (GND)
unnamed: BT1.1 (+), BT2.1 (+)
unnamed: BT1.2 (-), BT1.3 (+), BT2.2 (-), BT2.3 (+)
unnamed: BT1.4 (-), BT1.5 (+), BT2.4 (-), BT2.5 (+)
unnamed: BT1.6 (-), BT2.6 (-)
unnamed: D1.2 (A), R2.2
unnamed: D2.2 (A), R3.1
unnamed: U3.1 (LDO_3V3), U3.2 (ACDIN1)
unnamed: U3.3 (ACDIN2), U3.4 (LDO_1V5)
VBUS_IN: J5.2, U3.23 (VBUS_IN), U3.32 (VBUS), U5.4 (IN), U5.5 (IN), U5.6 (IN)
