melair/ktane/PCB/Others/2FALCD/2FALCD.kicad_pcb

## KiCad design PCB/Others/2FALCD/2FALCD.kicad_pcb (2026-03-31)

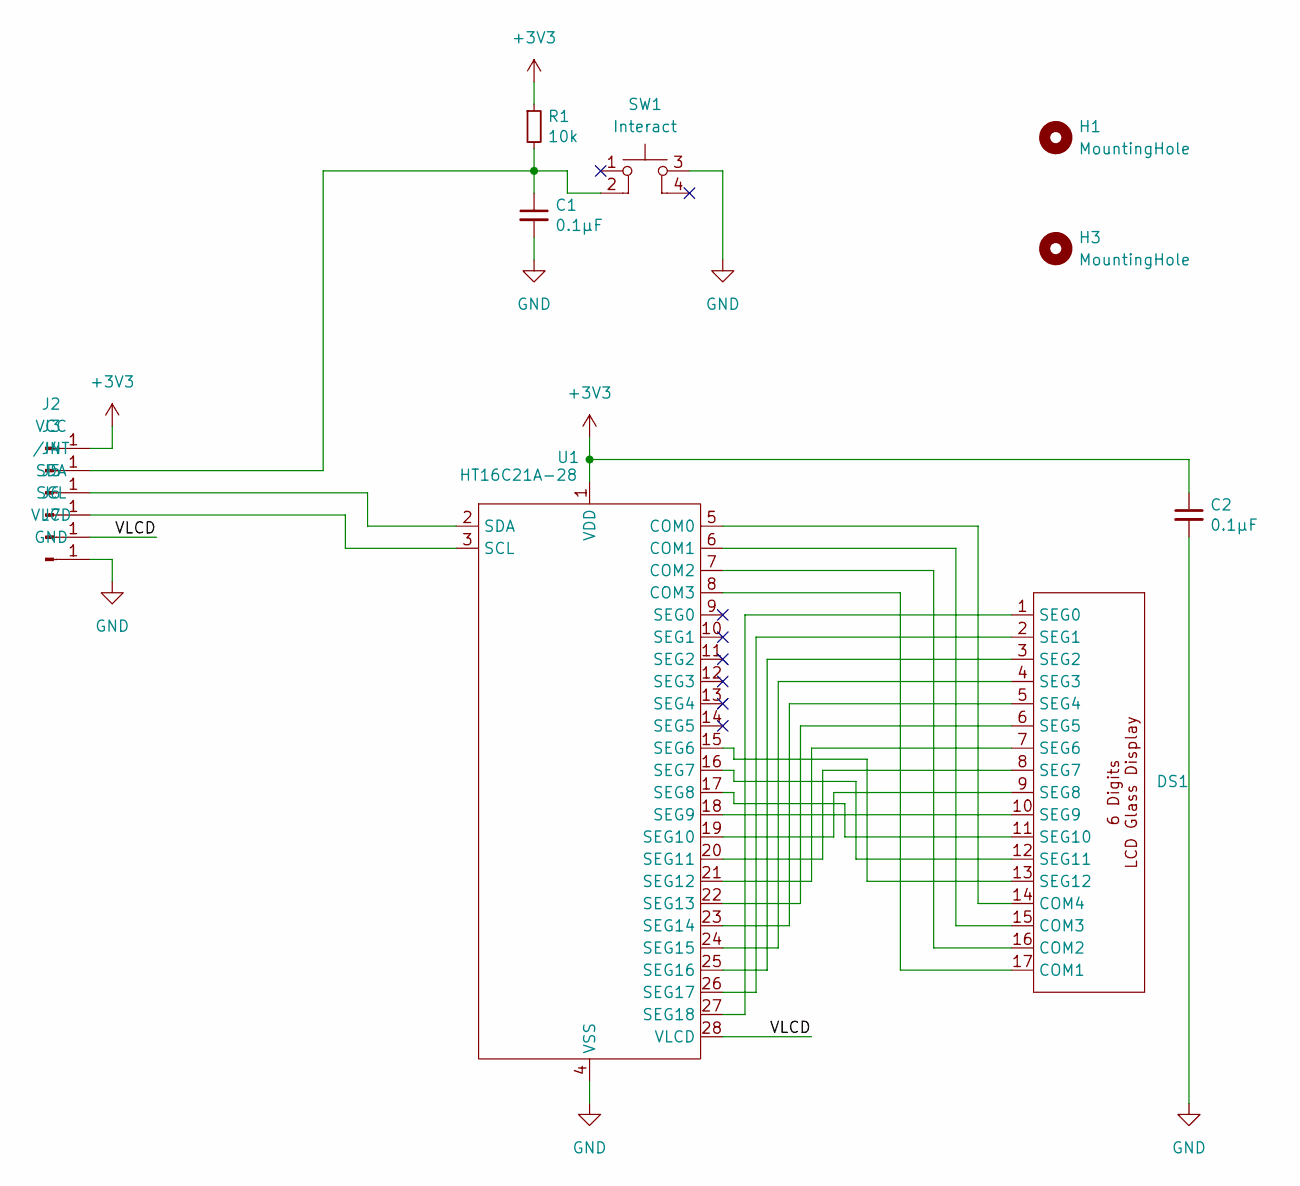
[picture p63: schematic 2FALCD.kicad_sch]

Parts:
C1, C2: 0.1μF; C_0603_1608Metric; DIGIKEY 1276-1005-1-ND
DS1: LCDGlass-6Digit
H1, H3: MountingHole; MountingHole_3.2mm_M3
J2: VCC; Pad4x2
J3: /INT; Pad4x2
J4: SDA; Pad4x2
J5: SCL; Pad4x2
J6: VLCD; Pad4x2
J7: GND; Pad4x2
R1: 10k; R_0603_1608Metric; DIGIKEY P10.0KHCT-ND
SW1: Interact; PTS526Sx15SMTR2xLFS; DIGIKEY CKN12220-1-ND
U1: HT16C21A-28; SOP-28_8.4x18.16mm_P1.27mm

Connections:
+3V3: C2.1, J2.1 (Pin_1_1), R1.1, U1.1 (VDD)
/VLCD: J6.1 (Pin_1_1), U1.28 (VLCD)
GND: C1.2, C2.2, J7.1 (Pin_1_1), SW1.3, U1.4 (VSS)
unnamed: DS1.17 (COM1), U1.8 (COM3)
unnamed: DS1.16 (COM2), U1.7 (COM2)
unnamed: DS1.15 (COM3), U1.6 (COM1)
unnamed: DS1.14 (COM4), U1.5 (COM0)
unnamed: DS1.1 (SEG0), U1.27 (SEG18)
unnamed: DS1.2 (SEG1), U1.26 (SEG17)
unnamed: DS1.3 (SEG2), U1.25 (SEG16)
unnamed: DS1.4 (SEG3), U1.24 (SEG15)
unnamed: DS1.5 (SEG4), U1.23 (SEG14)
unnamed: DS1.6 (SEG5), U1.22 (SEG13)
unnamed: DS1.7 (SEG6), U1.21 (SEG12)
unnamed: DS1.8 (SEG7), U1.20 (SEG11)
unnamed: DS1.9 (SEG8), U1.19 (SEG10)
unnamed: DS1.10 (SEG9), U1.18 (SEG9)
unnamed: DS1.11 (SEG10), U1.17 (SEG8)
unnamed: DS1.12 (SEG11), U1.16 (SEG7)
unnamed: DS1.13 (SEG12), U1.15 (SEG6)
unnamed: C1.1, J3.1 (Pin_1_1), R1.2, SW1.2
unnamed: J4.1 (Pin_1_1), U1.2 (SDA)
unnamed: J5.1 (Pin_1_1), U1.3 (SCL)

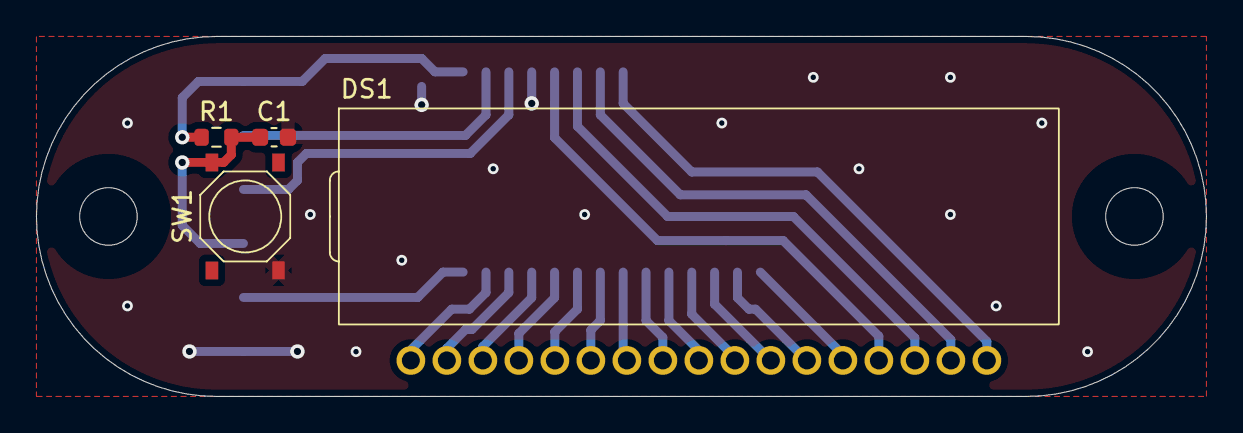
[picture p64: board 2FALCD.kicad_pcb from above]

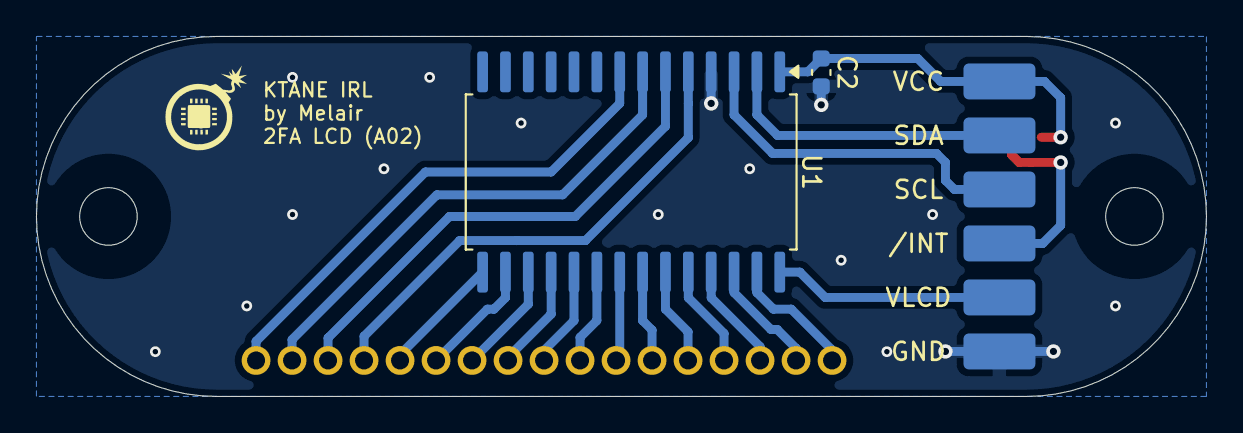
[picture p65: board 2FALCD.kicad_pcb from below]

Board: 2 copper layers, 65.0 x 20.0 mm, 14 parts (8 on the bottom side), 23 nets.
