melair/ktane/Firmware/STM32/ControlBoard/ControlBoard.ioc

Mcu.UserName=STM32H562VGTx
PA0.GPIO_Label=C0
PA0.Signal=SharedStack_PA0
PA1.GPIO_Label=C1
PA1.Signal=SharedStack_PA1
PA10.GPIO_Label=SD_ACT
PA10.Signal=GPIO_Output
PA11.Signal=USB_DM
PA12.Signal=USB_DP
PA13(JTMS/SWDIO).Signal=DEBUG_JTMS-SWDIO
PA14(JTCK/SWCLK).Signal=DEBUG_JTCK-SWCLK
PA15(JTDI).GPIO_Label=SD_DETECT
PA15(JTDI).Signal=GPIO_Input
PA2.GPIO_Label=C2
PA2.Signal=SharedStack_PA2
PA3.GPIO_Label=C3
PA3.Signal=SharedStack_PA3
PA4.GPIO_Label=B0
PA4.Signal=SharedStack_PA4
PA5.GPIO_Label=B1
PA5.Signal=SharedStack_PA5
PA6.GPIO_Label=B2
PA6.Signal=SharedStack_PA6
PA7.GPIO_Label=B3
PA7.Signal=SharedStack_PA7
PB0.GPIO_Label=B6
PB0.Signal=SharedStack_PB0
PB1.GPIO_Label=B7
PB1.Signal=SharedStack_PB1
PB10.Signal=I2C2_SCL
PB12.Signal=I2C2_SDA
PB14.GPIO_Label=A1
PB14.Signal=SharedStack_PB14
PB15.GPIO_Label=A0
PB15.Signal=SharedStack_PB15
PB3(JTDO/TRACESWO).Signal=DEBUG_JTDO-SWO
PB5.Signal=UART5_RX
PB6.Signal=UART5_TX
PB7.GPIO_Label=BOOT_IN
PB7.Signal=GPIO_Input
PB9.GPIO_Label=STATUS_LED
PB9.Signal=GPIO_Output
PC0.GPIO_Label=C4
PC0.Signal=SharedStack_PC0
PC1.GPIO_Label=C5
PC1.Signal=SharedStack_PC1
PC10.Signal=SDMMC1_D2
PC11.Signal=SDMMC1_D3
PC12.Signal=SDMMC1_CK
PC2.GPIO_Label=C6
PC2.Signal=SharedStack_PC2
PC3.GPIO_Label=C7
PC3.Signal=SharedStack_PC3
PC4.GPIO_Label=B4
PC4.Signal=SharedStack_PC4
PC5.GPIO_Label=B5
PC5.Signal=SharedStack_PC5
PC8.Signal=SDMMC1_D0
PC9.Signal=SDMMC1_D1
PD0.Signal=FDCAN1_RX
PD1.Signal=FDCAN1_TX
PD10.GPIO_Label=SD_PWR
PD10.Signal=GPIO_Output
PD12.GPIO_Label=ARGB
PD12.Signal=S_TIM4_CH1
PD2.Signal=SDMMC1_CMD
PD3.GPIO_Label=CAN_ACT
PD3.Signal=GPIO_Output
PD8.GPIO_Label=A2
PD8.Signal=SharedStack_PD8
PD9.GPIO_Label=A3
PD9.Signal=SharedStack_PD9
PE10.GPIO_Label=A5
PE10.Signal=SharedStack_PE10
PE11.GPIO_Label=A4
PE11.Signal=SharedStack_PE11
PE12.Signal=SPI4_SCK
PE13.Signal=SPI4_MISO
PE14.Signal=SPI4_MOSI
PE8.GPIO_Label=A7
PE8.Signal=SharedStack_PE8
PE9.GPIO_Label=A6
PE9.Signal=SharedStack_PE9
PH0-OSC_IN(PH0).Signal=RCC_OSC_IN
