melair/ktane/Firmware/STM32/Comms/App/Inc/main.h

/**
  ******************************************************************************
  * @file           : main.h
  * @brief          : Header for main.c file.
  *                   This file contains the common defines of the application.
  ******************************************************************************
  * @attention
  *
  * Copyright (c) 2026 STMicroelectronics.
  * All rights reserved.
  *
  * This software is licensed under terms that can be found in the LICENSE file
  * in the root directory of this software component.
  * If no LICENSE file comes with this software, it is provided AS-IS.
  *
  ******************************************************************************
  */

/* Define to prevent recursive inclusion -------------------------------------*/
#ifndef __MAIN_H
#define __MAIN_H

#ifdef __cplusplus
extern "C" {

#endif

/* Includes ------------------------------------------------------------------*/
#include "stm32wb0x_hal.h"
#include "app_entry.h"
#include "app_common.h"
#include "compiler.h"

/* Private includes ----------------------------------------------------------*/

/* Exported types ------------------------------------------------------------*/

/* Exported constants --------------------------------------------------------*/

/* Exported macro ------------------------------------------------------------*/

/* Exported functions prototypes ---------------------------------------------*/
void Error_Handler(void);

extern UART_HandleTypeDef hlpuart1;

/* Private defines -----------------------------------------------------------*/
#define BLE_INT_Pin GPIO_PIN_2
#define BLE_INT_GPIO_Port GPIOB
#define RUN_Pin GPIO_PIN_5
#define RUN_GPIO_Port GPIOB
#define CAL_IN_Pin GPIO_PIN_4
#define CAL_IN_GPIO_Port GPIOB

#ifdef __cplusplus
}
#endif

#endif /* __MAIN_H */
