melair/ktane/Firmware/STM32/Backplane/App/Src/node_link.c

#include "node_link.h"

#include <string.h>

#include "backplane.h"
#include "backplane_bus.h"
#include "backplane_bus/protocol.h"
#include "cobs/cobs.h"
#include "node_link/protocol.h"
#include "node_link/router.h"
#include "power.h"
#include "sys/gpio.h"
#include "uart/uart.h"
#include "uart/uart_platform.h"

#define NODE_LINK_ANNOUNCEMENT_INTERVAL_MS 200U
#define NODE_LINK_TX_FRAME_COUNT 4U

_Static_assert(SIZE_NODE_LINK_ANNOUNCEMENT <= COBS_PACKET_MAX_SIZE,
               "Node link announcement exceeds the maximum COBS packet size");

#define NODE_LINK_ASSERT_BACKPLANE_BUS_PACKET_FITS(opcode, value, member) \
    _Static_assert(SIZE_##opcode <= (COBS_PACKET_MAX_SIZE - NODE_LINK_SIZE_HEADER), \
                   #opcode " exceeds the node link encapsulation capacity");

BACKPLANE_BUS_PROTOCOL_PACKETS(NODE_LINK_ASSERT_BACKPLANE_BUS_PACKET_FITS)

#undef NODE_LINK_ASSERT_BACKPLANE_BUS_PACKET_FITS

typedef struct {
    UART_State uart;
    UART_HandleTypeDef uart_handle;
    COBS_State cobs;
    uint8_t uart_tx_buffer[NODE_LINK_TX_FRAME_COUNT * COBS_FRAME_MAX_SIZE];
} NodeLink_State;

static NodeLink_State front_node_link;
static NodeLink_State rear_node_link;
static uint8_t rear_node_link_rx_ring[UART_RX_RING_DEFAULT_CAPACITY];
static uint32_t next_announcement_ms;

static void front_node_link_backplane_bus_receive(const NodeLink_Message *message);
static void rear_node_link_backplane_bus_receive(const NodeLink_Message *message);

static const NodeLink_Router front_node_link_router = {
    .backplane_bus = front_node_link_backplane_bus_receive,
};

static const NodeLink_Router rear_node_link_router = {
    .backplane_bus = rear_node_link_backplane_bus_receive,
};

static bool time_reached(const uint32_t now_ms, const uint32_t target_ms) {
    return (int32_t) (now_ms - target_ms) >= 0;
}
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
