melair/ktane/(commit log)

2021-06-28 Raise an error when firmwaring starts, and fails.
    [modules.c, modules.h]
2021-06-28 Resolve from MSIRA C warnings.
    [argb.c, can.c, mode.c, modules.c, nvm.c, tick.c]
2021-06-28 Add wrapper around module status indicator. Add error display handling.
    [argb.c, main.c, modules.c, status.c]
2021-06-28 Add support for reset packet, resets whole system.
    [main.c]
2021-06-29 Add protocol frame for game messages, tweak idle status colour to be more yellow.
2021-06-29 Refactor buzzer to handle staticly predefined frequencies.
    [main.c]
2021-06-30 Rework timer to use a shared value, rather than a function. This was to attempt to address an issue with corrupt return values from the tick_fetch(), this became especially visible when adding anothe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
    [main.c, modules.c, status.c, tick.c, tick.h]
2021-07-01 First pass at seven segment display driver for timer board.
2021-07-01 Rework interrupt handling to use multivector interrupt table.
    [main.c, tick.c]
2021-07-01 Correct comment about interrupt priority.
    [tick.c]
2021-07-01 Add more data to missing or unknown prefix/opcode detection on network. Stop trying to firmware if in debug mode.
    [modules.h, protocol.c]
2021-07-02 Migrate away from using ISRS which exposed a function return bug. Create controller mode, and initialise segment from it.
    [controller.c, main.c, mode.c, tick.c, tick.h]
2021-07-02 Fix prototypes in segments, extern predefined characters.
2021-07-02 Enhance error system have active/inactive concept, clear alarms on boot on others. Controller shows if there were issues.
    [modules.c, modules.h, protocol.c, status.c]
2021-07-03 Refactor main timer to be 2kHz and have locally generated flags for a tick of 100Hz, 1kHz and 2kHz, as well as maintain tick_value now at 1ms accuracy.
2021-07-03 Use IDLE mode to prevent CPU spinning, reduces control complexity. Disable unused peripherals.
    [main.c, tick.c]
2021-07-04 Complete work on game flow, initial controller implementation to autostart all modules.
2021-07-06 Add 20Hz tick clock, used for animations.
2021-07-07 Remove pull ups from maze, use keymatrix in debug. Fix race condition with game resetting modules.
    [game.c, mode.c]
2021-07-11 Add big font support for LCD, fix issue with using character 0xff, remove variable name clashes.
    [lcd.c]
2021-07-12 Add libraries for KTANE PCBs.
2021-07-12 Add Pull Up/Down module board, working on revision A04.
    [ModulePullUpDown-B_Cu.gbl, ModulePullUpDown-B_Cu.gbr, ModulePullUpDown-B_Mask.gbr, ModulePullUpDown-B_Mask.gbs, ModulePullUpDown-B_Paste.gbp, ModulePullUpDown-B_Paste.gbr, ModulePullUpDown-B_SilkS.gbo, ModulePullUpDown-B_SilkS.gbr]
2021-07-12 Add the LED strip board, used for wires.
    [LEDStrike-B_Cu.gbr, LEDStrike-B_Mask.gbr, LEDStrike-B_Paste.gbr, LEDStrike-B_SilkS.gbr, LEDStrike-Edge_Cuts.gbr, LEDStrike-F_Cu.gbr, LEDStrike-F_Mask.gbr, LEDStrike-F_Paste.gbr]
2021-07-12 Add LED maze PCB.
    [LEDMaze-B_Cu.gbr, LEDMaze-B_Mask.gbr, LEDMaze-B_Paste.gbr, LEDMaze-B_SilkS.gbr, LEDMaze-Edge_Cuts.gbr, LEDMaze-F_Cu.gbr, LEDMaze-F_Mask.gbr, LEDMaze-F_Paste.gbr]
2021-07-13 Add control board PCB.
    [ControlBoard-B_Cu.gbr, ControlBoard-B_Mask.gbr, ControlBoard-B_Paste.gbr, ControlBoard-B_SilkS.gbr, ControlBoard-Edge_Cuts.gbr, ControlBoard-F_Cu.gbr, ControlBoard-F_Mask.gbr, ControlBoard-F_Paste.gbr]
2021-07-13 Add timer module display board.
    [ClockStrikeRotary-B_Cu.gbr, ClockStrikeRotary-B_Mask.gbr, ClockStrikeRotary-B_Paste.gbr, ClockStrikeRotary-B_SilkS.gbr, ClockStrikeRotary-Edge_Cuts.gbr, ClockStrikeRotary-F_Cu.gbr, ClockStrikeRotary-F_Mask.gbr, ClockStrikeRotary-F_Paste.gbr]
2021-07-13 Add empty module.
    [Empty.kicad_pcb, Empty.sch]
2021-07-13 Reduce the frequency that many parts of the service loop are processed.
    This is in preparation for adding another timer for PWM that may wake the loop up far more frequently.
2021-07-13 Add PWM library for RGB leds, uses Timer 1.
2021-07-13 Correct missing symbol in control board schematic.
    [ControlBoard.sch]
2021-07-19 Finish implementation of Simon says, fix bug in distribution of strike count.
    [game.c, game.h, mode.h, simon.c]
2021-07-21 Add implementation for Who's On First, fix keymatrix bit masks.
    [mode.c, mode.h, whosonfirst.c]
2021-07-21 Correct word order broken by grouping behaviour.
    Without correction would not match default KTANE manual.
    [whosonfirst.c]
2021-07-21 Fix whitespace in choices table.
    [whosonfirst.c]
2021-07-21 Fix white space again on choices table.
    [whosonfirst.c]
2021-08-06 Complete rework for variable sized buzzer with diode.
    [ControlBoard.kicad_pcb]
2021-08-06 Fix missing comma in Who's On First.
    [whosonfirst.c]
2021-08-09 Add chassis plate used for mounting modules.
2021-08-11 Add 4x4 Col to Row key matrix module, with ESD protection.
    [Keymatrix-B_Cu.gbl, Keymatrix-B_Mask.gbs, Keymatrix-B_Paste.gbp, Keymatrix-B_SilkS.gbo, Keymatrix-Edge_Cuts.gm1, Keymatrix-F_Cu.gtl, Keymatrix-F_Mask.gts, Keymatrix-F_Paste.gtp]
2021-08-16 Mint gerber for A04 version of pull up/down module, 1mm narrower, cut outs for support posts.
    [PullUpDown-B_Cu.gbl, PullUpDown-B_Mask.gbs, PullUpDown-B_Paste.gbp, PullUpDown-B_SilkS.gbo, PullUpDown-Edge_Cuts.gm1, PullUpDown-F_Cu.gtl, PullUpDown-F_Mask.gts, PullUpDown-F_Paste.gtp]
2021-08-17 Add banana plug socket and small pushbutton as parts.
2021-08-17 Add acrylic cuts for current implemented modules.
2021-08-17 Add speculative buttons module.
2021-08-17 Add laser cuts for combination task, key busy work and sequence wires.
2021-08-17 Add ARGB led strip for whos on first stages.
2021-08-25 Update Who's on First to key matrix, fix stage led colours, fix bug with discounting previous words, fix bug with flow of correct selections.
    [whosonfirst.c]
2021-08-25 Fix bug with game seed being reset every time a status message was received.
    [game.c]
2021-08-25 Rework wires to use standard colours, and functions to calculate the solution. Unimplemented.
2021-08-25 Add implementation for simple wires, logic for which wire to cut.
2021-08-27 Align new wire adc values correctly.
2021-08-27 Fix bug in display with words with spaces in who's on first.
    [whosonfirst.c]
2021-09-01 Add noise on completion of module, add results on LCD screen after completing or failing.
    [controller.c, game.c, game.h, lcd.c, whosonfirst.c]
2021-09-01 Fix compilation errors with end game and needy function header.
    [controller.c]
2022-08-26 Rework wire detection to only care about disconnections, not colour changes during play.
2022-08-30 Add fixes, add rotary encoder, combination lock add edgework browser.
    [controller.c, lcd.c, main.c, mode.c]
2022-08-30 Various KiCad file upgrades.
    [ControlBoard.kicad_pcb, ControlBoard.kicad_sch]
2022-09-04 Tweak maximum number of modules online, fix mode count.
    [mode.h]
2022-09-16 Add .gitignore for KiCad backups.
2022-09-16 Add KiCad 6 project files.
2022-09-16 Add new Power Management PCB.
    [PowerManagement.kicad_pcb, PowerManagement.kicad_sch, PowerManagement.sch]
2022-12-18 Add concept of domain for CAN bus, to be used with 2.4GHz chassis link.
2022-12-18 New module with RTC, uSD card and nf24 radio, all using SPI.
    [SPIRadioCFRTC-B_Cu.gbl, SPIRadioCFRTC-B_Mask.gbs, SPIRadioCFRTC-B_Paste.gbp, SPIRadioCFRTC-B_Silkscreen.gbo, SPIRadioCFRTC-Edge_Cuts.gm1, SPIRadioCFRTC-F_Cu.gtl, SPIRadioCFRTC-F_Mask.gts, SPIRadioCFRTC-F_Paste.gtp]
2022-12-18 Add gerbers used to produce Power Management board.
    [PowerManagement-B_Cu.gbl, PowerManagement-B_Mask.gbs, PowerManagement-B_Paste.gbp, PowerManagement-B_Silkscreen.gbo, PowerManagement-Edge_Cuts.gm1, PowerManagement-F_Cu.gtl, PowerManagement-F_Mask.gts, PowerManagement-F_Paste.gtp]
2022-12-18 Update PullUpDown module with updated KiCad files (recovery/upgrade).
2023-02-05 Allow users of keymatrix to specify debounce samples.
2023-02-05 Add operator module, fix issue with time display when timer runs out.
    [ControlBoard.kicad_sch]
2023-02-05 Add missing reference to stdbool.h
    [ports.h]
2023-02-12 Add UI for controller for debug, fix up bugin error handling, lint whitespace.
    [argb.c, can.c, can.h, controller.c, game.c, game.h, lcd.c]
2023-02-20 First untested pass at SPI controller.
2023-02-21 Migrate SPI to use new KPORT.
2023-03-04 Fix LCD number display, refactor module data into mode_data.
    [cardscan.c, lcd.c, pn532.c]
2023-03-06 Fix up in edgework display, end stats, debug menu.
    [cardscan.c, controller.c, game.c]
2023-03-09 Fix up handling of state changes.
    [mode.c]
2023-03-09 Fix service prototypes.
2023-03-10 Migrate ARGB to SPI abstraction, add delayed CS, initial opts work.
2023-03-13 Fix up SPI HAL to be more scalable, move pins into HAL. Implement RTC clock reading on optional module.
    [argb.c, cardscan.c, main.c, pn532.c, rtc.c, rtc.h]
2023-03-19 Working SD card implementation, single channel audio playback, mixing issues with second SD card block.
    [audio.c, audio.h, main.c, main.h, pn532.c, rtc.c, rtc.h, sdcard.c]
2023-03-26 Rework audio mixing to rely on service loop, optomise sample mixing, ensure audio fill request timer fires interrupt to wake from sleep.
    [audio.c, spi.c]
2023-03-27 Add framework for flasher firmware, offset at 0x01F000, for #13.
2023-03-27 Begin to form unified application, fix known issues with function pointers, fix sd card init bug.
    [argb.c, main.c, mode.c, rtc.c, sdcard.c, spi.c, spi.h]
2023-03-29 Migrate EEPROM addresses to shared, segment offset/sizes, tweak buzzer debug disable.
    [can.c, lcd.c, mode.c, nvm.c, rng.c]
2023-03-30 Share device config between programs, add version of firmware to end of program space.
    Using asm() is a hack to work around consts not being available in the bootloader,
    it makes some sense to unify the approach long term. Functions will have to be
    written to extract firmware versions using the NVM access routines.
2023-03-31 Extract NVM routines out to common directory, fix bug with eeprom.
    Previous initialisation of the EEPROM could result in a power off after the version
    is written but before the migration, resulting it 0xff data being returned rather
    than the migrated data.
    Move version set to after migrations.
    [can.c, lcd.c, main.c, mode.c, nvm.c, rng.c]
2023-04-09 Fix bug with firmware updating, where it would ALWAYS firmware.
    [module.c]
2023-04-10 Fix version endian (again), bootloader size, migrate to global incomming packet_t*
    Because the packet handlers for modules are called by a function pointer, it appears
    that XC8 does not correctly locate the parameters passed in, as such they are
    corrupted as soon as the function starts.
    This does argue against this approach and perhaps it should be migrated back to
    a statically linked set of functions. Using #define to include the routers for
    prefixes.
    [can.c, game.c, main.c, mode.c, module.c]
2023-04-12 Revert changes to packet handling, fix firmwaring. Fix a few bugs.
    Move packet handling back to things that are in the call tree, otherwise things
    are corrupted.
    Fix issues with enablement of modules, identify messages.
    [can.c, controller.c, game.c, game.h, main.c, mode.c, module.c]
2023-04-12 Fix forced strike bug, adjust simon timings to be closer to game.
    [game.c, simon.c]
2023-04-14 Fix combination bug, add config for ARGB brightness and buzzer vol, add custom game type menus.
    [argb.c, argb.h, controller.c, game.c, game.h, lcd.c, main.c, module.c]
2023-04-16 Fix maximum number of supported strikes.
    Previously strikes 6 and 7 would result in excessively stretched time.
    [game.c]
2023-04-16 Create generic functions for determining number of solved/enabled modules/puzzles.
    [module.c]
2023-04-16 Remove initialisation for battery value.
2023-04-18 Add initial support for I2C abstraction, power management board via I2C.
2023-04-23 Fix round one of compiler issues.
    [argb.c, audio.c, cardscan.c, i2c.c, lcd.c, mode.c, mode.h, pn532.c]
2023-04-23 Second round of compiler fixes.
    [can.c, cardscan.c, lcd.c, mode.c, mode.h, whosonfirst.c]
2023-04-25 Replace buzzer calls with start of sound system.
    [cardscan.c, controller.c, game.c, main.c, protocol.h, simon.c, sound.c]
2023-08-20 Fix bugs around opt setting, add DSP volume adjustment, fix FAT bugs.
    [audio.c, audio.h, controller.c, fat.c, main.c, module.c, simon.c, sound.c]
2023-08-24 Fix up sounds, add DAC volume, fix power mgmt and display.
    [audio.c, audio.h, controller.c, main.c, module.c, power.c, power.h, protocol.h]
2023-08-25 Tidy up cardscan, fix bugs in audio, power display.
    Add module acrylic templates too.
    [cardscan.c, main.c, power.c]
2023-08-29 Rework of operator module, untested.
    [main.c]
2023-08-29 Convert all KiCad to 6.0, clean up libraries, remove files that shouldn't be committed.
    [ClockStrikeRotary.kicad_pcb, ClockStrikeRotary.kicad_sch, ClockStrikeRotary.sch, ControlBoard.kicad_pcb, ControlBoard.kicad_sch, ControlBoard.sch, Empty.kicad_pcb, Empty.kicad_sch]
2023-08-29 Add prototype for LCD module.
    [LCD.kicad_pcb, LCD.kicad_sch]
2023-08-29 Add .gitignore for PCB file types.
2023-08-29 Upgrade KiCad files from 6.0 to 7.0.
    [ClockStrikeRotary.kicad_pcb, ClockStrikeRotary.kicad_sch, ControlBoard.kicad_pcb, ControlBoard.kicad_sch, Empty.kicad_pcb, Empty.kicad_sch, Keymatrix.kicad_pcb, Keymatrix.kicad_sch]
2023-09-01 Beginning rework of Control Board for respin.
    [ControlBoard.kicad_pcb, ControlBoard.kicad_sch, argb.kicad_sch, can.kicad_sch, microsdcard.kicad_sch, power.kicad_sch]
2024-08-26 Fix extremely broken power status display logic.
2024-11-09 continue power board debugging.
2026-03-13 First pass of PCB rework.
    [BrailleDriver.kicad_pcb, BrailleDriver.kicad_sch, ClockStrikeRotary.kicad_pcb, ClockStrikeRotary.kicad_sch, ControlBoard.kicad_pcb, ControlBoard.kicad_sch, Keymatrix.kicad_pcb, Keymatrix.kicad_sch]
2026-03-13 Remove legacy PCBs from V1.
    [BrailleDriver.kicad_pcb, BrailleDriver.kicad_sch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]
2026-03-13 ControlBoard B02, with buck regulator fix.
    [ControlBoard-B_Cu.gbl, ControlBoard-B_Mask.gbs, ControlBoard-B_Paste.gbp, ControlBoard-B_Silkscreen.gbo, ControlBoard-Edge_Cuts.gm1, ControlBoard-F_Cu.gtl, ControlBoard-F_Mask.gts, ControlBoard-F_Paste.gtp]
2026-03-13 Update pull up/down module, with multivoltage ESD protection.
    [PullUpDown-B_Cu.gbl, PullUpDown-B_Mask.gbs, PullUpDown-B_Paste.gbp, PullUpDown-B_Silkscreen.gbo, PullUpDown-Edge_Cuts.gm1, PullUpDown-F_Cu.gtl, PullUpDown-F_Mask.gts, PullUpDown-F_Paste.gtp]
2026-03-13 Add V2 backplane, with RS485 bus.
    [Backplane-B_Cu.gbl, Backplane-B_Mask.gbs, Backplane-B_Paste.gbp, Backplane-B_Silkscreen.gbo, Backplane-Edge_Cuts.gm1, Backplane-F_Cu.gtl, Backplane-F_Mask.gts, Backplane-F_Paste.gtp]
2026-03-13 Add edgework bus and widget PCBs with RS485 bus.
    [Bus-B_Cu.gbl, Bus-B_Mask.gbs, Bus-B_Paste.gbp, Bus-B_Silkscreen.gbo, Bus-Edge_Cuts.gm1, Bus-F_Cu.gtl, Bus-F_Mask.gts, Bus-F_Paste.gtp]
2026-03-13 Add audio module.
    [Audio-B_Cu.gbl, Audio-B_Mask.gbs, Audio-B_Paste.gbp, Audio-B_Silkscreen.gbo, Audio-Edge_Cuts.gm1, Audio-F_Cu.gtl, Audio-F_Mask.gts, Audio-F_Paste.gtp]
2026-03-13 Add chassis comms board.
    [Comms-B_Cu.gbl, Comms-B_Mask.gbs, Comms-B_Paste.gbp, Comms-B_Silkscreen.gbo, Comms-Edge_Cuts.gm1, Comms-F_Cu.gtl, Comms-F_Mask.gts, Comms-F_Paste.gtp]
2026-03-13 WIP: LCD Driver for Maze.
    [LCDDriver.kicad_pcb, LCDDriver.kicad_sch]
2026-03-13 WIP: Power management.
    [Power.kicad_pcb, Power.kicad_sch, battery.kicad_sch, interface.kicad_sch, manager.kicad_sch]
2026-03-13 Add timer display and strike display.
    [Strikes-B_Cu.gbl, Strikes-B_Mask.gbs, Strikes-B_Paste.gbp, Strikes-B_Silkscreen.gbo, Strikes-Edge_Cuts.gm1, Strikes-F_Cu.gtl, Strikes-F_Mask.gts, Strikes-F_Paste.gtp]
2026-03-16 Add framework for all PIC18 based firmwares.
    [ControlBoard.kicad_pcb, argb.kicad_sch]
2026-03-18 Add basic MCU init, interrupt init, and pin HAL.
2026-03-21 First pass at SPI hal, however is huge once compiled.
2026-03-21 Rework SPI to only allow single instantiation, but take SPI port from compiler micro. 65% smaller build.
    [fsm.c, main.c, spi.c, spi.h]
2026-03-22 Fix up SPI HAL, read and write appear to work.
    [spi.c, spi.h]
2026-03-25 Correctly implement rotation, and fix up fill operation.
    [epaper.c, main.c]
2026-03-26 Add ESD protection to the RS485 networks.
    [Backplane.kicad_pcb, Backplane.kicad_sch, Comms.kicad_pcb, Comms.kicad_sch, connectors.kicad_sch]
2026-03-27 Fix up power LEDs on regulators.
    [Backplane.kicad_pcb, Backplane.kicad_sch, ControlBoard.kicad_pcb, power.kicad_sch]
2026-03-28 WIP: Correct displaying of program constants.
    [epaper.c, main.c, spi.h]
2026-03-28 WIP: Rework x2/y2 into width/height.
    [main.c]
2026-03-29 Add 2FA LCD display pcb.
    [2FALCD-B_Cu.gbl, 2FALCD-B_Mask.gbs, 2FALCD-B_Paste.gbp, 2FALCD-B_Silkscreen.gbo, 2FALCD-Edge_Cuts.gm1, 2FALCD-F_Cu.gtl, 2FALCD-F_Mask.gts, 2FALCD-F_Paste.gtp]
2026-03-31 Include all corrections, mint new gerbers. Update some to KiCad 10.
    [2FALCD-B_Cu.gbl, 2FALCD-B_Mask.gbs, 2FALCD-B_Paste.gbp, 2FALCD-B_Silkscreen.gbo, 2FALCD-Edge_Cuts.gm1, 2FALCD-F_Cu.gtl, 2FALCD-F_Mask.gts, 2FALCD-F_Paste.gtp]
2026-04-08 Correct Digikey part numbers.
    [Backplane.kicad_sch, ControlBoard.kicad_sch, argb.kicad_sch, connectors.kicad_sch, dpcc.kicad_sch, power.kicad_sch]
2026-04-09 Basic power handling with eFuse.
2026-04-09 Push DMA selection for SPI to compile flags.
2026-04-11 Add I2C HAL abstraction.
2026-04-11 Update SPI state names to remove clashes, ensure pins are only configured if present.
2026-04-11 Add I2C to backplane.
2026-04-11 Test I2C in edgework.
2026-04-11 Update some files to KiCad 10.
    [ControlBoard.kicad_sch, argb.kicad_sch, power.kicad_sch]
2026-04-11 Fix up I2C to protect against edge conditions.
    [i2c.c, i2c.h, main.c]
2026-04-11 Remove legacy debug, improve timer ticks, prevent bootloader jumping to invalid application.
    [fsm.c, main.c]
2026-04-11 Make access to internal_tick in timer atomic.
2026-04-11 Add mermaid diagram for i2c.
2026-04-12 Tidy up ARGB, debug issues with FSM and XC8 compilation.
    [argb.c, argb.h, fsm.c, i2c.c, main.c]
2026-04-12 Remove fs_t name, fix corruption bug in argb_set.
    [argb.c, fsm.c, i2c.c, main.c, power.c, spi.c]
2026-04-13 Add initialisation for control board, add/fix ARGB for control board.
    [argb.c, main.c]
2026-04-14 Add support for setting current via I2C.
2026-04-15 Begin CSP implementation, add DMA/PPS/CLC tables to polyfill.
2026-04-17 Add support for SPI CLK polarity.
2026-04-18 Working example of driving strikes and timer.
2026-04-18 Fix holes in CSP implementation.
2026-04-19 Don't power control board from programmer anymore.
2026-04-23 Fix deadlock after single CAN node running. Other safety tweaks.
    [can.c, can.h, main.c]
2026-04-24 Initial buggy working of status FSM.
    [main.c, status.c]
2026-04-27 Add implementation for status/button control, plus keymatrix.
2026-04-27 Fix up minor bugs and typos.
    [status.c]
2026-04-29 Update to KiCad 10.
    [Audio.kicad_pcb, Audio.kicad_sch, Bus.kicad_pcb, Bus.kicad_sch, Comms.kicad_sch, LCDDriver.kicad_pcb, LCDDriver.kicad_sch, Power.kicad_pcb]
2026-05-23 End of PIC18 development for firmware, migration to STM32 hardware will occur.
2026-06-24 feat: Add new footprints and symbols for STM32 rework.
2026-06-24 feat: Rework ControlBoard to use an STM32H562VGT6.
    [ControlBoard.kicad_pcb, ControlBoard.kicad_sch, argb.kicad_sch, power.kicad_sch]
2026-06-25 feat: Upgrade backplane to a STM32G070KB.
    [Backplane.kicad_pcb, Backplane.kicad_sch, connectors.kicad_sch, dpcc.kicad_sch]
2026-06-25 fix: Adjust labels on regulator.
    [ControlBoard.kicad_pcb]
2026-06-25 feat: Migrate edgework to a STM32G070KBT6.
    [PullUpPullDown.kicad_sch, Widget.kicad_pcb, Widget.kicad_sch]
2026-06-25 feat: Update audio board to consume I2S from STM32 parent board, removing ESP32.
    [Audio.kicad_pcb, Audio.kicad_sch]
2026-06-25 feat: Rework comms board to have an STM32 for communications.
    [Comms.kicad_pcb, Comms.kicad_sch]
2026-06-26 feat: Add support for battery for RTC on comms board.
    [Comms.kicad_pcb, Comms.kicad_sch]
2026-06-26 feat: Remove backup battery for RTC, and crystal. 1PPS can be derived from HSE.
    [ControlBoard.kicad_pcb, ControlBoard.kicad_sch]
2026-06-26 fix: Change oscillator to 25Mhz, enables PLL to operate in nicer ranges.
    [ControlBoard.kicad_sch]
2026-06-27 fix: Correct stitching for 3.3V and GND layers.
    [ControlBoard.kicad_pcb]
2026-06-27 feat: Initial start of STM32 projects for firmware.
2026-06-27 feat: Configure initial peripherals on STM32H5.
2026-06-27 feat: Configure PLL2 to correctly feed FDCAN and SDMMC, at 80Mhz and 200Mhz.
    [ControlBoard.ioc]
2026-06-27 feat: Clock bus UART off of 32MHz HSI.
2026-06-27 feat: Import legacy BOMs for old boards.
    [Audio - B01.csv, Backplane - A02.csv, Comms - B03.csv, ControlBoard - B03.csv, Edgework Widget - A01.csv]
2026-06-27 feat: Export new revision BOM, allow in .gitignore, fix up revisions in schematics.
    [Audio - C01.csv, Audio.kicad_sch, Backplane - B01.csv, Backplane.kicad_sch, Comms - C01.csv, Comms.kicad_sch, ControlBoard - C01.csv, Edgework Widget - B01.csv]
2026-06-27 feat: Replace bare pads for battery with a cell, incase we want to use a cell holder.
    [Comms - C01.csv, Comms.kicad_pcb, Comms.kicad_sch]
2026-06-27 fix: VDD pour broken by LED, move, resolve minor stitching errors.
    [ControlBoard.kicad_pcb]
2026-06-27 feat: Final traces sizes for comms, final gerber exports.
    [Audio-B_Cu.gbl, Audio-B_Mask.gbs, Audio-B_Paste.gbp, Audio-B_Silkscreen.gbo, Audio-Edge_Cuts.gm1, Audio-F_Cu.gtl, Audio-F_Mask.gts, Audio-F_Paste.gtp]
2026-06-28 fix: Minor IOC tweaks.
    [Comms.ioc, ControlBoard.ioc]
2026-06-28 feat: Add pin stacked ports for other uses of submodule ports.
2026-07-10 chore: Migrate all STM32 projects into their own directory
2026-07-10 fix: Ensure that PLL3P is configured for I2S1.
    [ControlBoard.ioc]
2026-07-10 wip: importing STM32 code
2026-07-11 fix: Revert IOC back to non-reset version.
    [ControlBoard.ioc]
2026-07-22 feat: Implement ARGB driver, rename Core -> App.
2026-07-24 feat: Add SPI implementation, add missing GPIO config, add FSM for step two.
    [argb.c, can.c, fsm.c, gpio.h, main.c, spi.c, spi.h]
2026-07-24 feat: Migrate SPI to use FSM, plus struct to store its state.
2026-07-24 feat: Add I2C abstraction, fix RNG init.
    [i2c.c, i2c.h, main.c, mcu_init.c, rng.c]
2026-07-24 fix: Labels on Strikes PCB for SDA/SCL are swapped.
    [Strikes.kicad_pcb]
2026-07-25 feat: Add support for COBS formatted chassis bus port.
2026-07-27 wip: Add support for timer assisted rotary encoders
2026-07-28 feat: Complete InputManger, handling keymatrices, rotary encoders and analogue inputs.
2026-08-08 feat: Add framework for modules and modes.
2026-08-09 feat: Add indicator system, refactor ARGB to dirty frame approach
2026-08-09 feat: Implement status light and button for setting mode
2026-08-09 feat: Implement timer module init, pluse easy constants for strike display
2026-08-09 wip: Timer display
2026-08-09 feat: Timer and strike display, add startup animation
2026-08-11 feat: Add attract mode for timer
2026-08-12 feat: Implement TAS5733L management in chassis code.
2026-08-12 feat: Add i2s implementation, fix dac implementation
    [chassis.c, dac.c, i2s.c, i2s.h]
2026-08-12 feat: Remove error state reading, correct GPIO values, add bass boost.
    [chassis.c, dac.c, gpio.h]
2026-08-14 wip: Needy Timer PCB
    [NeedyCountdown.kicad_pcb, NeedyCountdown.kicad_sch]
2026-08-15 feat: Add single WS2812 ARGB break out board
    [ARGBSingle-B_Cu.gbl, ARGBSingle-B_Mask.gbs, ARGBSingle-B_Paste.gbp, ARGBSingle-B_Silkscreen.gbo, ARGBSingle-Edge_Cuts.gm1, ARGBSingle-F_Cu.gtl, ARGBSingle-F_Mask.gts, ARGBSingle-F_Paste.gtp]
2026-08-18 wip: Adding game mode to control board
2026-08-19 refactor: Migrate i2c, spi, status into common library.
2026-08-21 wip: Conversion of old PIC FSM based power manager.
2026-08-23 feat: Rework single ARGB board, adjust screw slot, make break away.
    [ARGBSingle.kicad_pcb, ARGBSingle.kicad_sch]
2026-08-23 feat: Add averaging of current draw.
2026-09-04 refactor: Split UART and COBS apart, and migrate to Common, with support for the STM32G0.
2026-09-05 refactor: Make ARGB available to STM32G0 platform
2026-09-06 feat: Define all UART links and buses, make chassis location a parameter.
2026-09-06 feat: Hardcode chassis location as chassis
2026-09-06 feat/refactor: Work on bus protocols, add NVM to STM32G0, refactor common features to be per directory.
2026-09-06 feat: Add chassis bus protocol, tweak edgework.
2026-09-13 feat: Fix up font handling, implement indicator, add edgework bus debug tool, add correct indicator font
    [edgework_bus.c, epaper.c, indicator.c, indicator.h, manager.c]
2026-09-15 feat: Add support for battery edgework, delay and retry for slot i2c due to insertion speed.
2026-09-15 feat: Add controller edegwork, add pulldown to InputManager. Tweak battery flash.
2026-09-20 fix: Fix secure connections and connecting when not pairing.
    [app_ble.c, app_conf.h, main.c, stm32wb0x_hal_msp.c, stm32wb0x_it.c, stm32wb0x_it.h]
2026-09-21 wip: Random pin codes
2026-09-21 refactor: Fix storage of connections, remove legacy single reference to connection handler.
    [app_ble.c, app_conf.h, ktane_gatt.c, main.c]
2026-09-24 chore: Remove I2C and SPI, we wont use them.
2026-09-24 feat: Version C02 of the comms board, fixing errors found during testing.
    [Comms.kicad_pcb, Comms.kicad_sch]
2026-09-29 refactor: Rename chassis_bus to backplane_bus.
2026-09-30 wip: Begin to build out remote power management
2026-09-30 wip: Power tracking in progress.
2026-10-01 wip: Power management from the chassis.
2026-10-01 feat: First pass at power management from chassis controlboard to backplanes.
2026-10-09 feat: Add SDMMC and FAT support for chassis, change clocks for ADC and SDMMC.
2026-10-09 feat: First pass at audio mixer, also adjust default chassis power to 1A.
2026-10-16 feat: Audio playback in chassis, including custom FAT for sdcard.
2026-10-21 feat: LCD I2C interface.
